desertfireballnetwork/observatories_technical_wiki/index.md

---
title: "Home"
nav_order: 1
---
Welcome to the [Desert Fireball
Network's](https://en.wikipedia.org/wiki/Desert_Fireball_Network) and Global
Fireball Observatory public wiki. This wiki contains documentation for
the the DFN's fireball observatories and data processing procedures for
collaborators and team members. The main GFO website is on
<https://gfo.rocks>, Australian DFN website can be found at
<https://dfn.gfo.rocks>.

**Please contribute where you can** by uploading information, designs
and files that will help others with installation, maintenance and
operation. By documenting your problems and solutions here, you can help
other collaborators get up and running faster. **We need your help to
get cameras off shelves and under the night sky looking for space
rocks!**

# Fireball Observatories

Documentation to help you get your observatory up and running

- [Re-configuring VPN in camera systems - 2023
  change]({% link network/Reconfigure_VPN.md %})
- [Contents of the box with DFNEXT system]({% link observatories/dfnext/Packing.md %})
- [Getting Started]({% link Getting_Started.md %})
- [Maintenance]({% link observatories/maintenance/index.md %})
- [Troubleshooting]({% link observatories/maintenance/Camera_Troubleshooting.md %})
- [Getting Help]({% link Getting_Help.md %})
- Frequently asked questions ([FAQ]({% link FAQ.md %}))

# Fireball Data

How to access your fireball images and information about how the DFN
processes fireball ev

- [Accessing data]({% link data-processing/Accessing_data.md %}) captured by Fireball
  Observatory (still images, videos, logs)
- [Finding Fireballs]({% link data-processing/Finding_Fireballs.md %}) in images
- Data Processing Pipeline

# Meteorite searching

- Foot searching:
  [Meteorite_searching_advice_handbook.pdf]({{ site.baseurl }}/images/Meteorite_searching_advice_handbook.pdf)
- Drone Meteorite Searching:
  <https://desertfireballnetwork.github.io/drone_meteorite_doc/>

# Resources

Collections of things you might find useful. **Contributions to this
section are especially appreciated**

Todo: find a better name for this section

- [Mechanical Designs]({% link installations/Mechanical_Designs.md %}) for deploying your
  fireball observatory (add your stand and roof mount designs here)
- [Cables]({% link observatories/maintenance/Cables.md %}) used in fireball observatories and for
  deployment
- [Photos of Fireballs]({% link data-processing/Fireball_Photos.md %}) (add your pretty
  fireball to the galleries here at reduced resolutions for everyone to
  see; remember this wiki is open to the public)
- [Photos of Fireball Camera
  Installations]({% link installations/Photos_of_Fireball_Camera_Installations.md %})
  (upload photos of your finished and in-progress installations here)

# [Hayabusa]({% link campaigns/hayabusa/index.md %})

# Wiki Info

Users with accounts may edit the wiki, and anyone may view the wiki
(even without logging in).

Internal links do not work in edit mode (it's a bug), but work as
expected in read mode.

File uploads are restricted to certain types of files. If you require a
new filetype to be added, please email DFN camera help.

Click the DFN fireball in the upper left at any time to get back to this
main page.

[Help Editing Wiki Pages](https://www.mediawiki.org/wiki/Help:Editing_pages),
[Formatting Help](https://www.mediawiki.org/wiki/Help:Formatting), [The
MediaWiki
VisualEditor](https://www.mediawiki.org/wiki/Help:VisualEditor/User_guide),
Orphaned Pages, [DFN Wiki To-do
List]({% link Wiki_To-do_List.md %})
