desertfireballnetwork/observatories_technical_wiki/Mechanical_Designs.md

upload you design files here for stands, roofmounts, railing mounts,
sunshields and things like that

# Gallery of installations

- [Various photos of Fireball Camera Systems
  Installations](Photos_of_Fireball_Camera_Installations.html)
- [Rooftop installations of DFNEXT/DFNSMALL camera
  systems](Rooftop_Fireball_Camera_Installation.html)
- [Standalone Fireball Camera
  Installation](Standalone_Fireball_Camera_Installation.html)
  (DFNEXT/DFNSMALL)

# DFNEXT and DFNSMALL camera systems

- [DFNEXT/DFNSMALL camera mounting
  pattern](Rooftop_Fireball_Camera_Installation#Mounting_Pattern.html),
  eg for roof top deployment
- [Drawings and instructions for standalone
  installation](Standalone_Fireball_Camera_Installation#Parts.html)
- [DFNEXT stand design by the UK Fireball
  Network](DFNEXT_stand_design_by_the_UK_Fireball_Network.html),
  off-the-shelf installation guide for standalone or rooftop deployment.

# DFNKIT camera systems

##  Rooftop Mounts

- [Rooftop Kit Camera
  Installation](Rooftop_Kit_Camera_Installation.html) details -
  DFNKIT deployment

(For [DFNKIT](:File:Kit_camera_with_GPS_antenna_1000.jpg.html)
cameras only at the moment. These have plastic enclosures with
transparent tops.)

Editable Autodesk Inventor ([free for use by "Qualified Educational
Institutions"](https://www.autodesk.com/education/free-software/inventor-professional))
part files:

roof_mount.ipt roof angle parameter can be modified before DXF export
for laser cutting

roof_mount_rib_and_pan.ipt

flat_roof_mount.ipt

### DXF files (send to your nearest lasercutter and then bend with a panbrake):

#### For smooth corrugated tin roofs

[Media:PART 10 degree roof mount MAT 3mm
aluminium.dxf](Media:PART_10_degree_roof_mount_MAT_3mm_aluminium.dxf.html)

[Media:PART 15 degree roof mount MAT 3mm
aluminium.dxf](Media:PART_15_degree_roof_mount_MAT_3mm_aluminium.dxf.html)

[Media:PART 20 degree roof mount MAT 3mm
aluminium.dxf](Media:PART_20_degree_roof_mount_MAT_3mm_aluminium.dxf.html)

[Media:PART 25 degree roof mount MAT 3mm
aluminium.dxf](Media:PART_25_degree_roof_mount_MAT_3mm_aluminium.dxf.html)

[Media:PART 30 degree roof mount MAT 3mm
aluminium.dxf](Media:PART_30_degree_roof_mount_MAT_3mm_aluminium.dxf.html)

[Media:PART 35 degree roof mount MAT 3mm
aluminium.dxf](Media:PART_35_degree_roof_mount_MAT_3mm_aluminium.dxf.html)

#### For rib and pan tin roofs

[Media:PART 20 degree rib and pan roof mount MAT 3mm
aluminium.dxf](Media:PART_20_degree_rib_and_pan_roof_mount_MAT_3mm_aluminium.dxf.html)

For flat roofs and other structures:

[Media:PART flat mount MAT 3mm
aluminium.dxf](Media:PART_flat_mount_MAT_3mm_aluminium.dxf.html)

### IPT files (editable for different roof angles and constructions)

[Media:Roof mount.ipt](Media:Roof_mount.ipt.html) (main roof mount
used by kit cameras, roof angle is an editable parameter)

[Media:Flat roof mount.ipt](Media:Flat_roof_mount.ipt.html)

[Media:Roof mount rib and
pan.ipt](Media:Roof_mount_rib_and_pan.ipt.html)
