desertfireballnetwork/observatories_technical_wiki/AMOS-Spec_fireball_BIOS_configuration.md

**Motherboard type: Asus ROG Strix Z370-I gaming**

Advanced - APM configuration - Restore AC power loss - Power ON.
