desertfireballnetwork/observatories_technical_wiki/observatories/dfnext/DFNEXT_stand_design_by_the_UK_Fireball_Network.md

---
title: "DFNEXT UK Stand Design"
parent: "DFNEXT"
grand_parent: "Observatories"
---
The UK Fireball Network has designed a stand for mounting DFNEXT cameras
using off the shelf building/electrical equipment. The stands have been
designed to be mounted on the floor, however, the design is easily
adaptable for installations on the side of buildings or on a flat roof.

The stand design in the UK uses the Unistrut system---a metal framing
system widely used in electrical and mechanical projects---however, an
alternative brand can be used if this system is not available. The
stands are designed to be weather resistant; all cut metal edges should
be galvanised to prevent rust, terrace pads should be used to elevate
the wooden base and minimise water damage, and the prevailing wind
direction and strength in the installation location should be considered
when positioning concrete blocks and deciding the size of the base.

### Build Manual and Cutting Instructions

![File:DFNEXT Camera Stand Design by UKFN.pdf]()
*<a href="File:DFNEXT">File:DFNEXT</a> Camera Stand Design by
UKFN.pdf*

# Gallery of installations

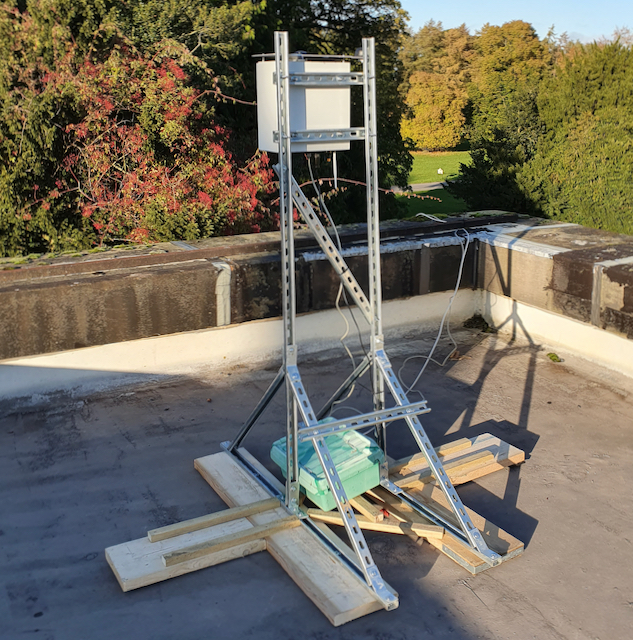
[picture p1: images/Roof_tall_install.jpeg]
\| Floor mounted camera back.jpeg\|
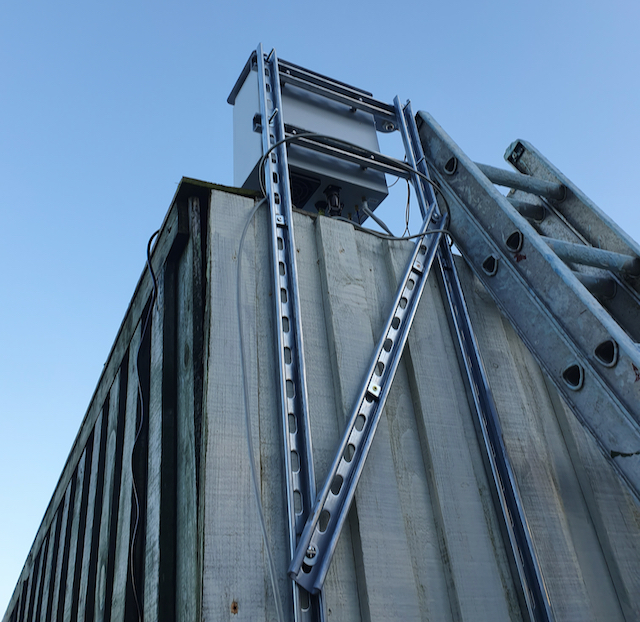
[picture p2: images/Shed_side_install.jpeg]
Floor mounted camera front.jpeg\| \|
Lincoln camera stand.jpeg\| Example roof stand.jpeg\|
