desertfireballnetwork/observatories_technical_wiki/AC_Power_Supply.md

The power supply recommended for AC powered installations where the
observatory is located close to the AC power supply is the [Meanwell
GST120A12](https://www.meanwellaustralia.com.au/products/gst120a).

For observatories with heaters and long DC power cable runs the
[Meanwell
HRP-300-12](https://www.meanwellaustralia.com.au/products/hrp-300) is
recommended as it's remote sense functionality allows it to compensate
for any voltage drop in the long cable runs. (If no heaters are present,
the [Meanwell
HRP-150-12](https://www.meanwellaustralia.com.au/products/hrp-150) is
the preferred option.)

Direct links to order Meanwell HRP-300-12 from USA:

[HRP-300-12, Mouser
Electronics](https://www.mouser.com/ProductDetail/MEAN-WELL/HRP-300-12?qs=sGAEpiMZZMvdqMP%2FaZ%252BGCqLV2Ez6D3hU)

[HRP-300-12, TRC
Electronics](https://www.trcelectronics.com/View/Mean-Well/HRP-300-12.shtml)

Accessories for Meanwell HRP-300-12:

[TRC-E-HRP300450600 enclosure for
HRP-300-12](https://www.trcelectronics.com/View/TRC/TRC-E-HRP300450600.shtml)

[US/Canada power cord for
HRP-300-12](https://www.trcelectronics.com/View/Tumbler/32V86S.shtml)

<figure>

<figcaption>Power_supply_wiring_with_remote_voltage_sense.svg</figcaption>
</figure>

### Outdoor Cable

The recommended off the shelf for use on roofs or outdoor structures is
the sunlight and abrasion resistant AlphaWire EcoFlex PUR 80045 SL005
(unshielded) or 80145 SL005 (braid shield). Digi-Key usually has one or
the other in stock: [80045
SL005](https://www.digikey.com/product-detail/en/alpha-wire/80045-SL005/80045SL005-ND/5271247),
[80145
SL005](https://www.digikey.com/product-detail/en/alpha-wire/80145-SL005/80145SL005-ND/5271269).

That cabling doesn't have a twisted pair, so we recommend wiring up the
conductors to the green numbering in the two images below.

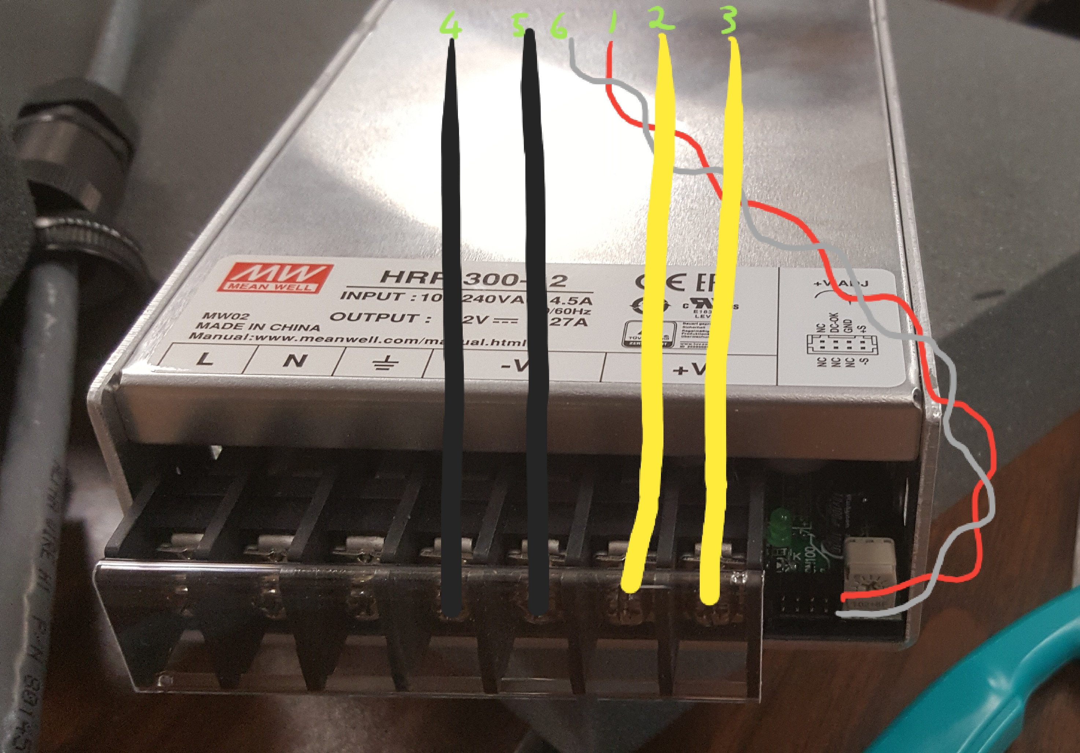
[picture p7: wiki/images/Remote_sense_cable_wiring_power_supply_side.jpg]
Recommended wiring on the power supply side for a 6 or 7 conductor cable (twisted pair will most likely not be present in off-the-shelf cables) You should use Blue 3mm Fork Crimps to terminate the conductors for L,N,E,-V and +V. This power supply should be installed in a metal enclosure which shoul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

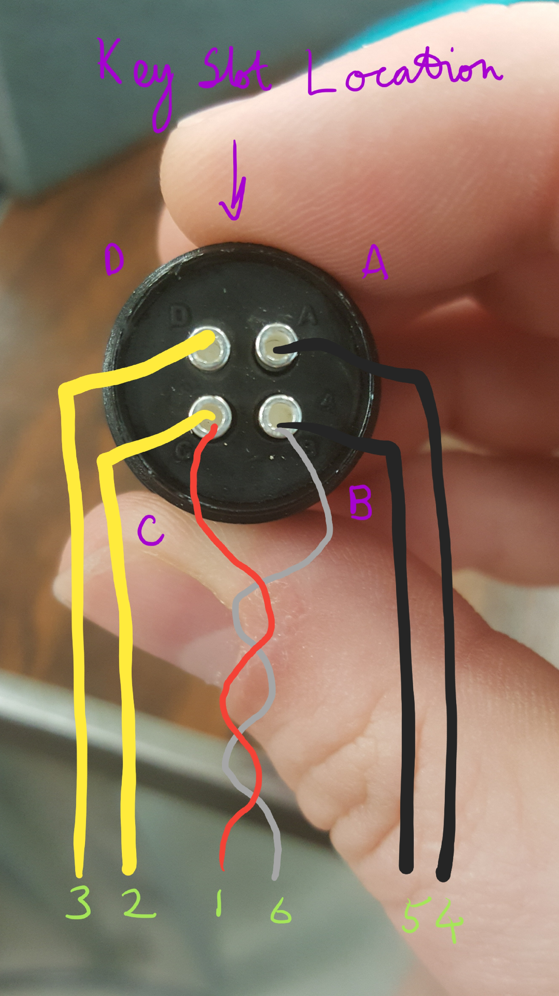
[picture p8: wiki/images/Remote_sense_cable_wiring_observatory_side.jpg]
Recommended wiring on the observatory power plug side for a 6 or 7 conductor cable (twisted pair will most likely not be present in off-the-shelf cables) Conductors 1 and 6 will need to be soldered to the side of C and B if thick conductors are used. The transition from insulated wire to contact ne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


### Mathias Research Ranch Installation in Alberta, Canada

<File:20190724_212110.jpg>\| <File:20190724_212620.jpg>\|
<File:20190724_212709.jpg>\|

### Long DC Cable Run Connector Care Package

If you need to build your own long cable with (using the cable listed
above) you can request a *Long DC Cable Run Connector Care Package* from
[us](Getting_Help.html). It should contain:
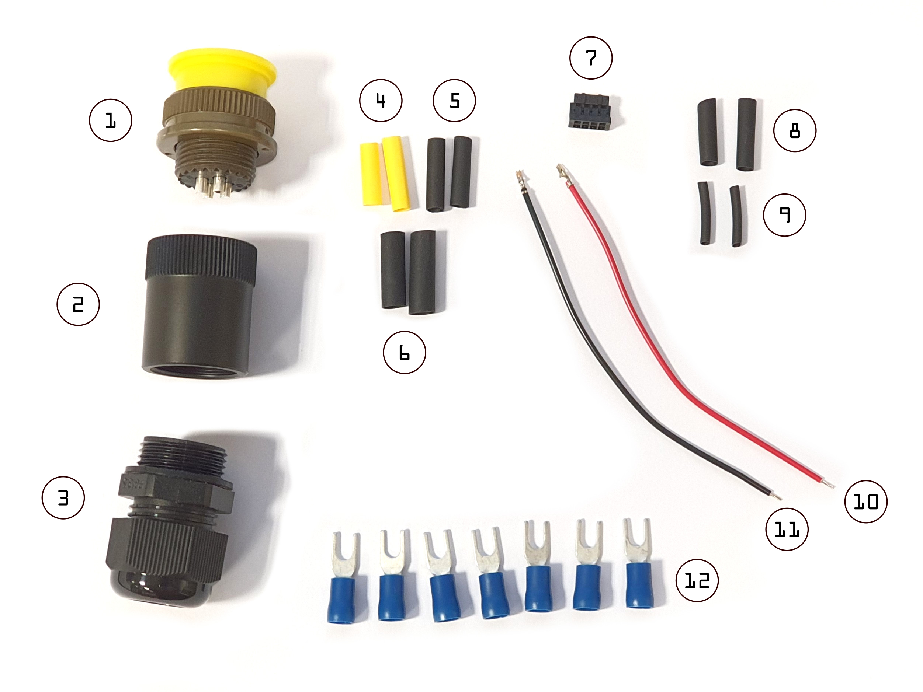
[picture p9: images/Long_DC_cable_connector_care_package.png]


<table>
<thead>
<tr class="header">
<th><p>Item #</p></th>
<th><p>Part</p></th>
<th><p>Quantity</p></th>
<th><p>Manufacturer</p></th>
<th><p>Manufacturer Part Number</p></th>
<th><p>Example Supplier Link 1</p></th>
<th><p>Example Supplier Link 2</p></th>
</tr>
</thead>
<tbody>
<tr class="odd">
<td><p>1</p></td>
<td><p>MIL-DTL-5015 compatible plug, 14S-2S insert</p></td>
<td><p>1</p></td>
<td><p>various</p>
<p>(Amphenol Industrial)</p></td>
<td><p>various</p>
<p>(MS4106F-14S-2S-624)</p></td>
<td><p><a
href="https://www.digikey.com/product-detail/en/amphenol-industrial-operations/MS3106F-14S-2S/MS3106F14S-2S-ND/378649">https://www.digikey.com/product-detail/en/amphenol-industrial-operations/MS3106F-14S-2S/MS3106F14S-2S-ND/378649</a></p></td>
<td><p><a
href="https://au.rs-online.com/web/p/mil-spec-circular-connectors/2982465/">https://au.rs-online.com/web/p/mil-spec-circular-connectors/2982465/</a></p></td>
</tr>
<tr class="even">
<td><p>2</p></td>
<td><p>PG13.5 cable gland adaptor for size 14 MIL-DTL-5015 compatible
plug</p></td>
<td><p>1</p></td>
<td><p>Amphenol Industrial</p></td>
<td><p>97B-14S-PG13.5-624</p></td>
<td><p>DFN Camera Help</p></td>
<td><p>Amphenol Industrial (minimum order quantity will apply)</p></td>
</tr>
<tr class="odd">
<td><p>3</p></td>
<td><p>PG13.5 cable gland</p></td>
<td><p>1</p></td>
<td><p>various</p></td>
<td><p>various</p></td>
<td><p><a
href="https://www.digikey.com/products/en/cables-wires-management/cable-and-cord-grips/492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">https://www.digikey.com/products/en/cables-wires-management/cable-and-cord-grips/492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</a></p></td>
<td><p><a
href="https://www.altronics.com.au/p/h4318A-6-12mm-eg13.5-pg13.5-black-ip68-cable-gland/">https://www.altronics.com.au/p/h4318A-6-12mm-eg13.5-pg13.5-black-ip68-cable-gland/</a></p></td>
</tr>
<tr class="even">
<td><p>4</p></td>
<td><p>≈10mm length of 3 mm yellow heatshrink tubing</p></td>
<td><p>2</p></td>
<td><p>various</p></td>
<td><p>various</p></td>
<td><p><a
href="https://www.altronics.com.au/p/w0912a-black-3mm-heatshrink-1.2m-length/">https://www.altronics.com.au/p/w0912a-black-3mm-heatshrink-1.2m-length/</a></p></td>
<td></td>
</tr>
<tr class="odd">
<td><p>5</p></td>
<td><p>≈10mm length of 3 mm black heatshrink tubing</p></td>
<td><p>2</p></td>
<td><p>various</p></td>
<td><p>various</p></td>
<td><p><a
href="https://www.altronics.com.au/p/w0912a-black-3mm-heatshrink-1.2m-length/">https://www.altronics.com.au/p/w0912a-black-3mm-heatshrink-1.2m-length/</a></p></td>
<td></td>
</tr>
<tr class="even">
<td><p>6</p></td>
<td><p>≈10mm length of 5 mm heatshrink tubing (may be required if 3 mm
tubing doesn't fit over contacts "C" and "B")</p></td>
<td><p>0-2</p></td>
<td><p>various</p></td>
<td><p>various</p></td>
<td><p><a
href="https://www.altronics.com.au/p/w0913a-black-5mm-heatshrink-1.2m-length/">https://www.altronics.com.au/p/w0913a-black-5mm-heatshrink-1.2m-length/</a></p></td>
<td></td>
</tr>
<tr class="odd">
<td><p>7</p></td>
<td><p>Power supply connector</p></td>
<td><p>1</p></td>
<td><p>Hirose</p></td>
<td><p>DF11-2DS-2C</p></td>
<td><p><a
href="https://www.digikey.com.au/product-detail/en/hirose-electric-co-ltd/DF11-8DS-2C/H2022-ND/141255">https://www.digikey.com.au/product-detail/en/hirose-electric-co-ltd/DF11-8DS-2C/H2022-ND/141255</a></p></td>
<td></td>
</tr>
<tr class="even">
<td><p>8</p></td>
<td><p>≈10mm length of 3 mm heatshrink tubing</p></td>
<td><p>2</p></td>
<td><p>various</p></td>
<td><p>various</p></td>
<td><p><a
href="https://www.altronics.com.au/p/w0912a-black-3mm-heatshrink-1.2m-length/">https://www.altronics.com.au/p/w0912a-black-3mm-heatshrink-1.2m-length/</a></p></td>
<td></td>
</tr>
<tr class="odd">
<td><p>9</p></td>
<td><p>≈10mm length of 1.5 mm heatshrink tubing</p></td>
<td><p>2</p></td>
<td><p>various</p></td>
<td><p>various</p></td>
<td><p><a
href="https://www.altronics.com.au/p/w0910a-black-1.5mm-heatshrink-1.2m-length/">https://www.altronics.com.au/p/w0910a-black-1.5mm-heatshrink-1.2m-length/</a></p></td>
<td></td>
</tr>
<tr class="even">
<td><p>10</p></td>
<td><p>DF-11 pre crimped jumper cable, red, cut in half</p></td>
<td><p>1</p></td>
<td><p>Hirose</p></td>
<td><p>H3BBT-10106-R6</p></td>
<td><p><a
href="https://www.digikey.com.au/product-detail/en/hirose-electric-co-ltd/H3BBT-10106-R6/H3BBT-10106-R6-ND/310537">https://www.digikey.com.au/product-detail/en/hirose-electric-co-ltd/H3BBT-10106-R6/H3BBT-10106-R6-ND/310537</a></p></td>
<td></td>
</tr>
<tr class="odd">
<td><p>11</p></td>
<td><p>DF-11 pre crimped jumper cable, black, cut in half</p></td>
<td><p>1</p></td>
<td><p>Hirose</p></td>
<td><p>H3BBT-10106-B6</p></td>
<td><p><a
href="https://www.digikey.com.au/product-detail/en/hirose-electric-co-ltd/H3BBT-10106-B6/H3BBT-10106-B6-ND/310505">https://www.digikey.com.au/product-detail/en/hirose-electric-co-ltd/H3BBT-10106-B6/H3BBT-10106-B6-ND/310505</a></p></td>
<td></td>
</tr>
<tr class="even">
<td><p>12</p></td>
<td><p>Blue 4 mm fork crimp terminal</p></td>
<td><p>7</p></td>
<td><p>various</p></td>
<td><p>various</p></td>
<td><p><a
href="https://www.altronics.com.au/p/h2082a-blue-4mm-fork-crimp-pk-100/">https://www.altronics.com.au/p/h2082a-blue-4mm-fork-crimp-pk-100/</a></p></td>
<td></td>
</tr>
</tbody>
</table>

### Long DC Cable Assembly

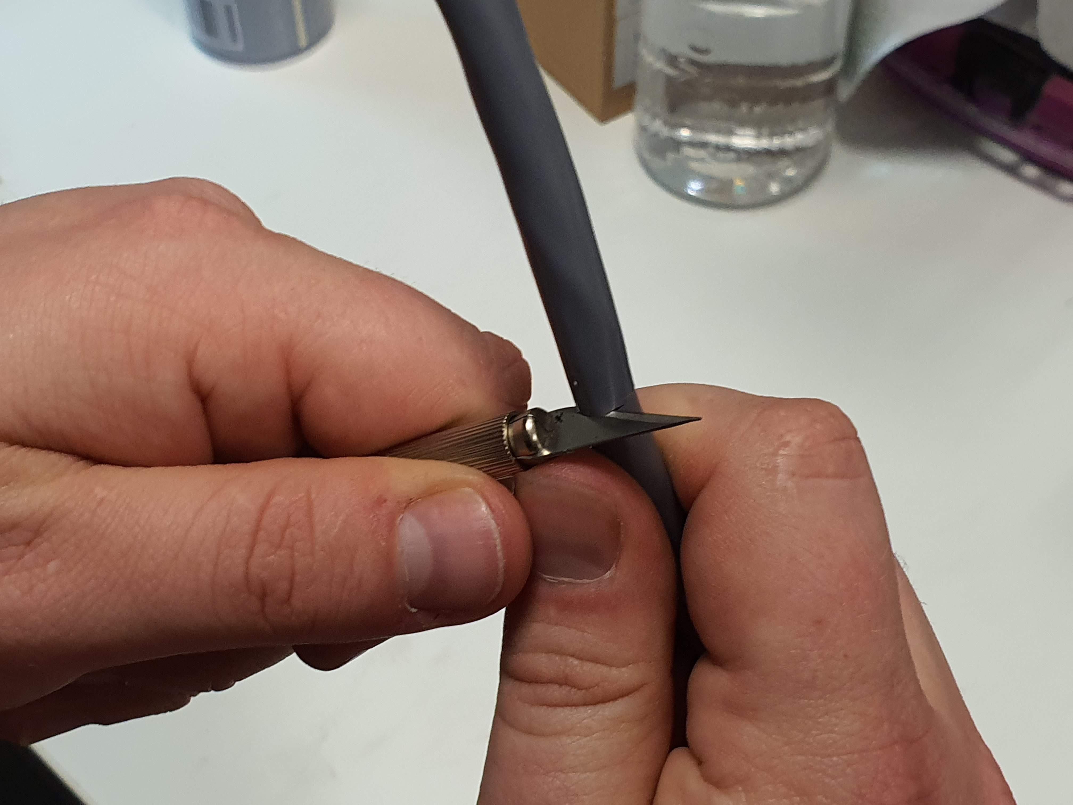
[picture p10: images/20190918_114454.jpg]

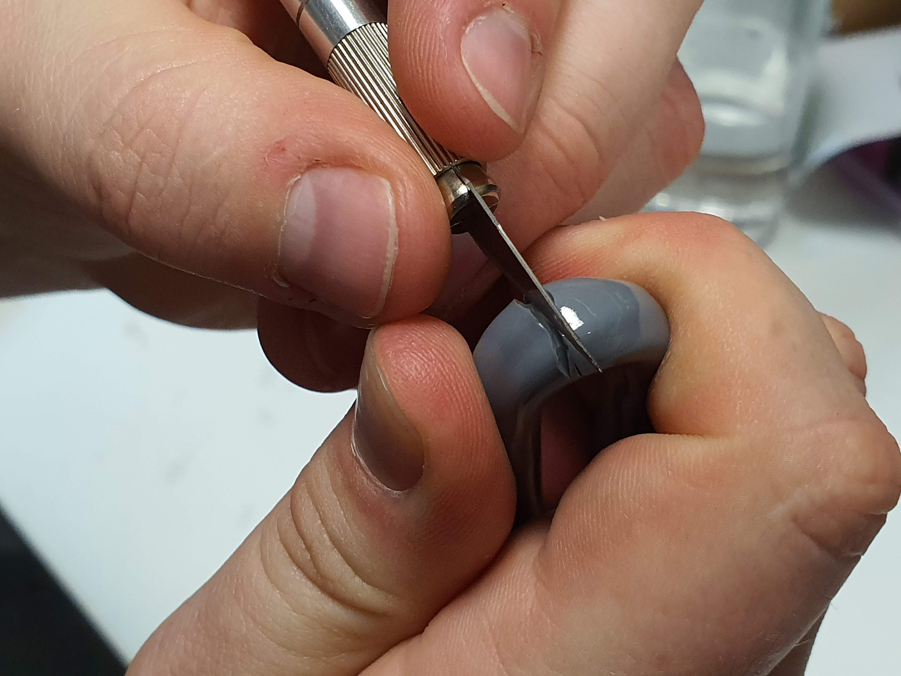
[picture p11: images/20190918_114512.jpg]

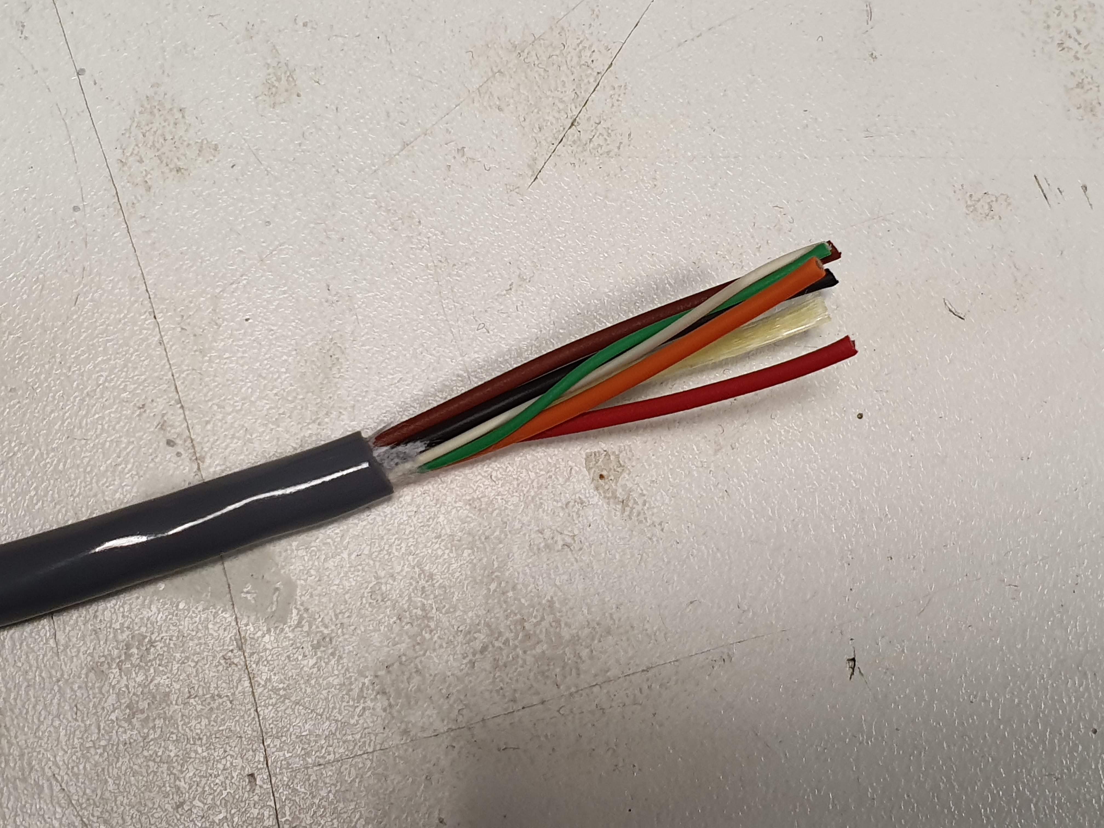
[picture p12: images/20190918_114635.jpg]

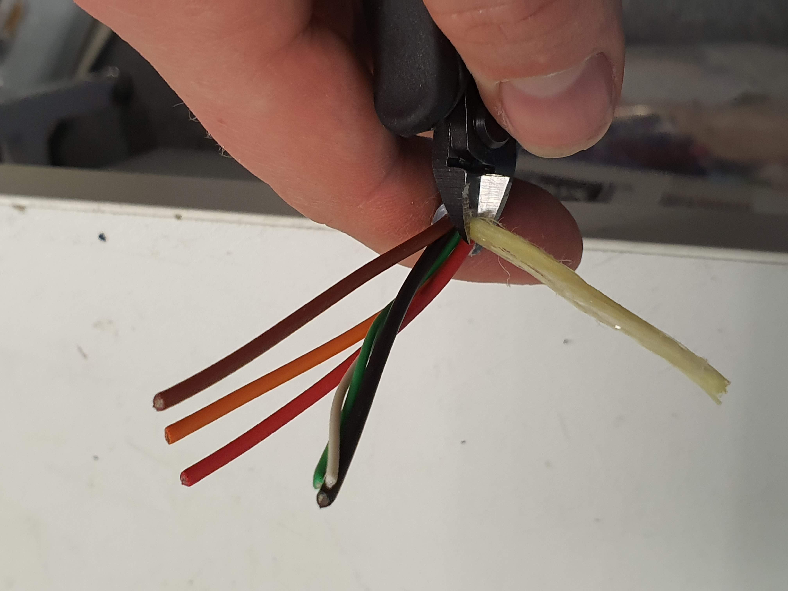
[picture p13: images/20190918_114658.jpg]

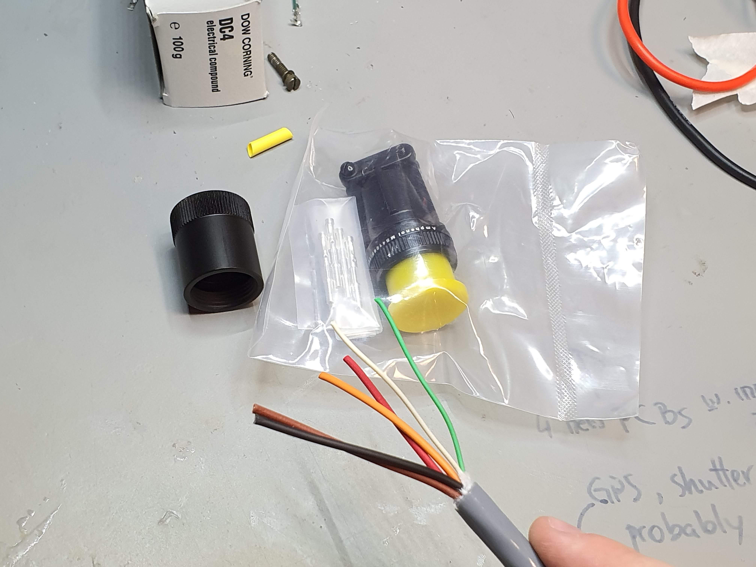
[picture p14: images/20190918_115321.jpg]

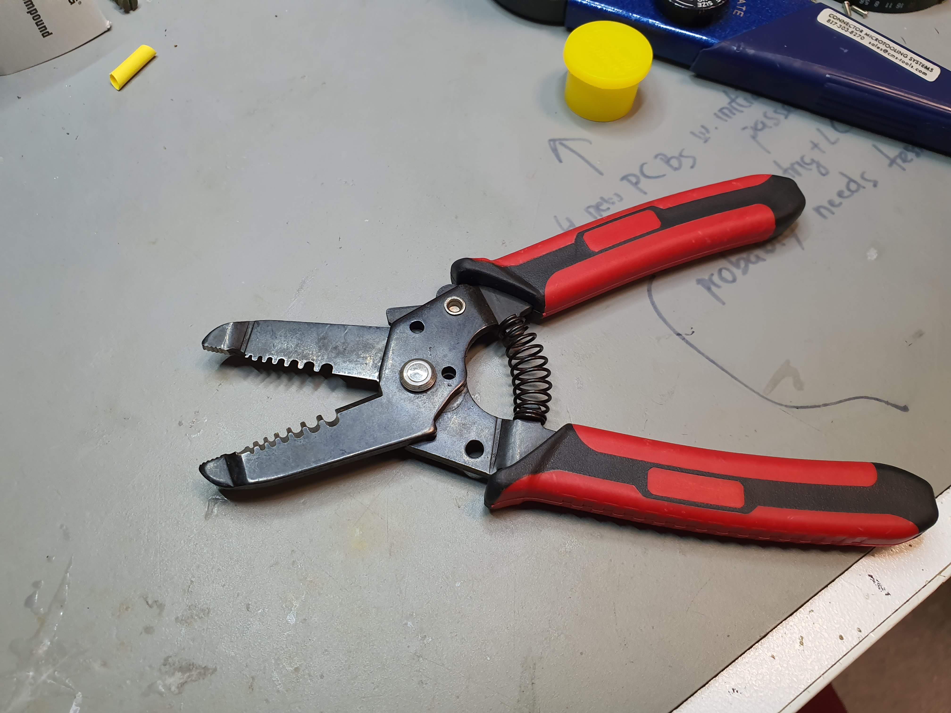
[picture p15: images/20190918_115757.jpg]

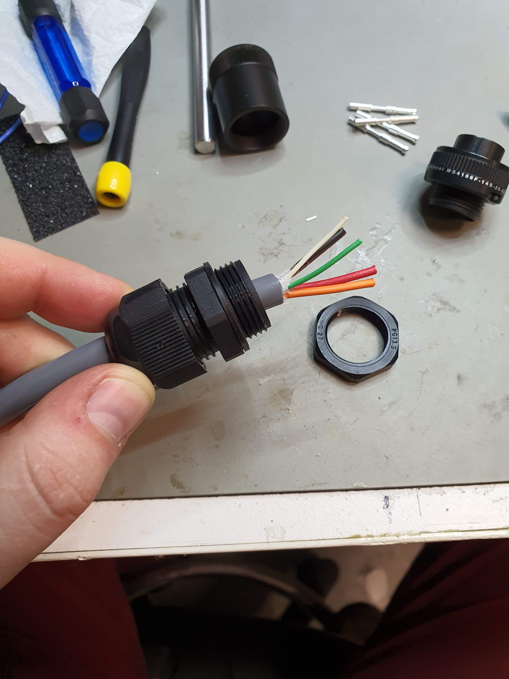
[picture p16: images/20190918_115538.jpg]

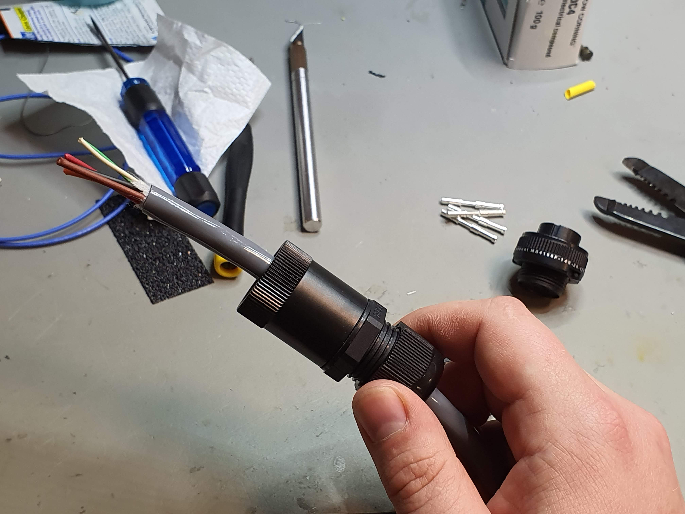
[picture p17: images/20190918_115612.jpg]

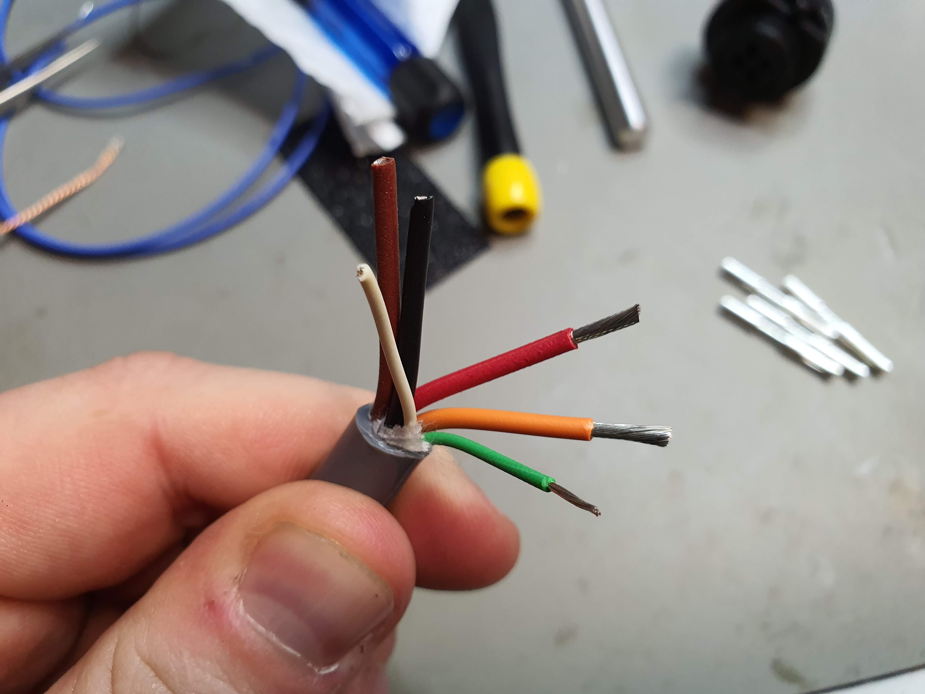
[picture p18: images/20190918_115724.jpg]

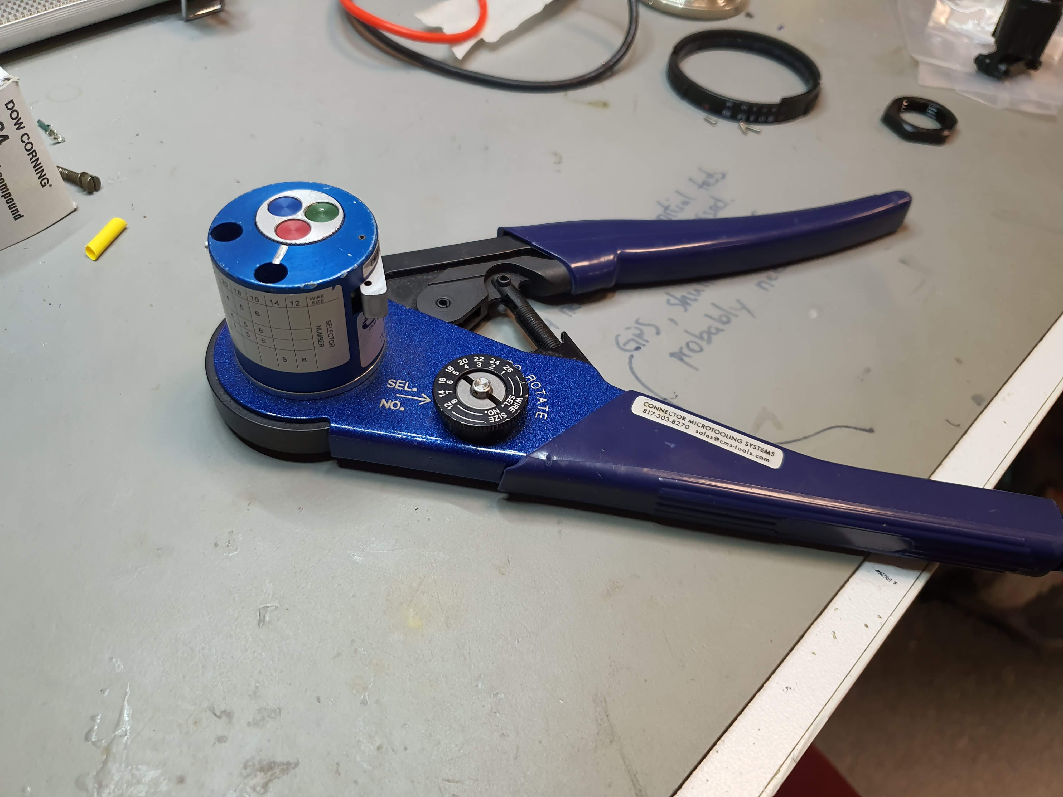
[picture p19: images/20190918_115806.jpg]

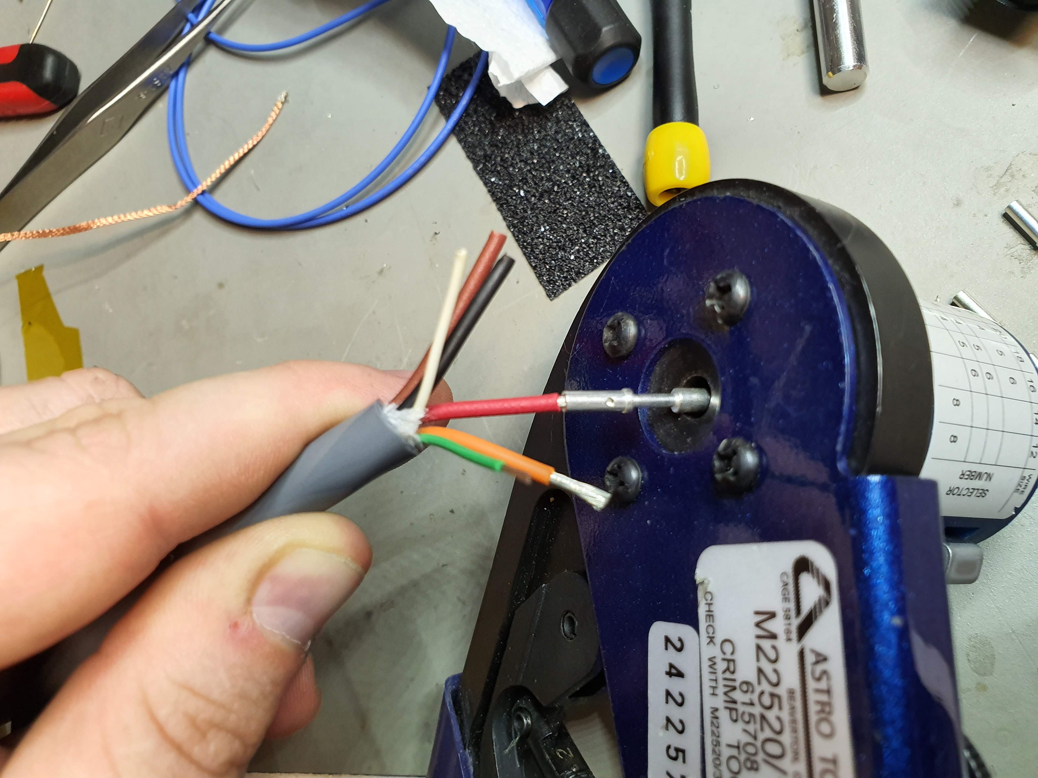
[picture p20: images/20190918_115819.jpg]

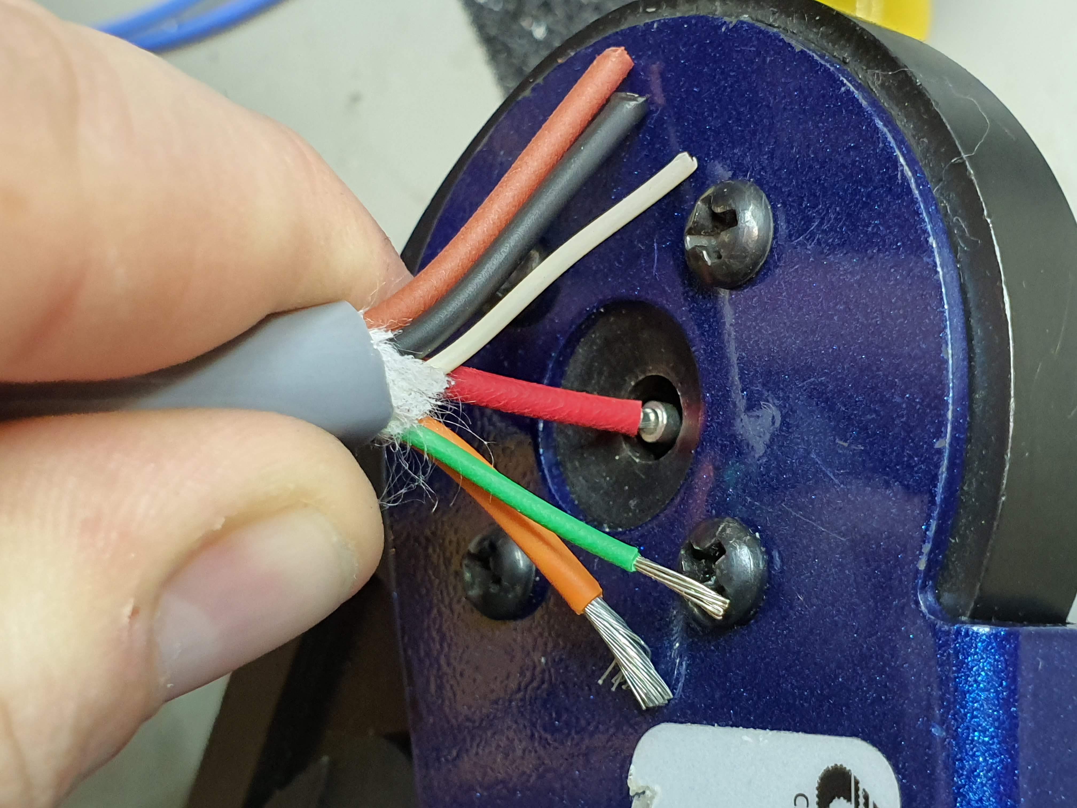
[picture p21: images/20190918_115836.jpg]

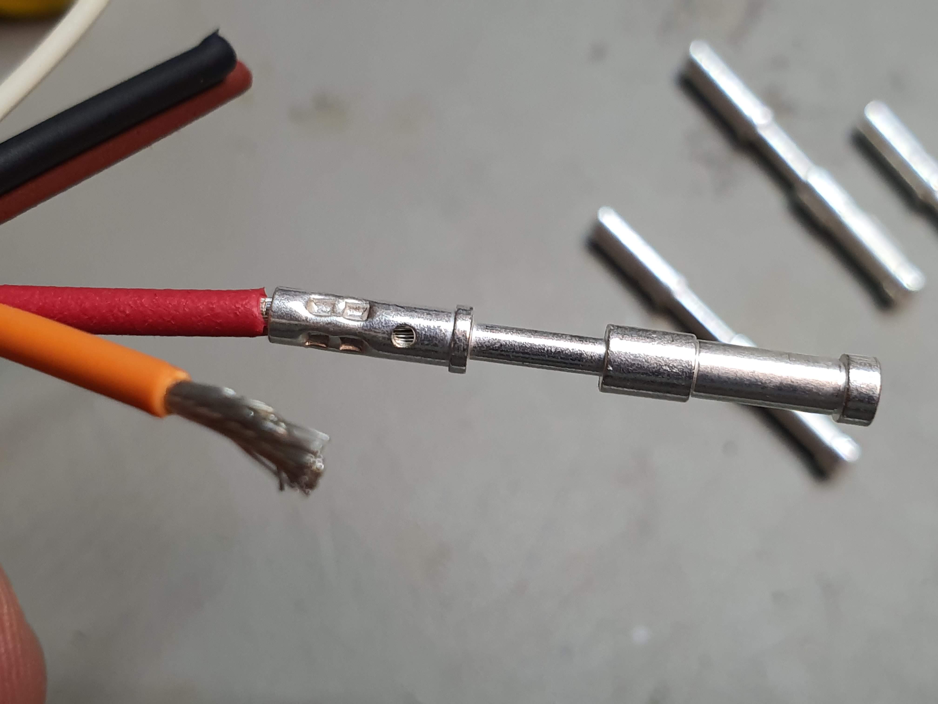
[picture p22: images/20190918_115848.jpg]

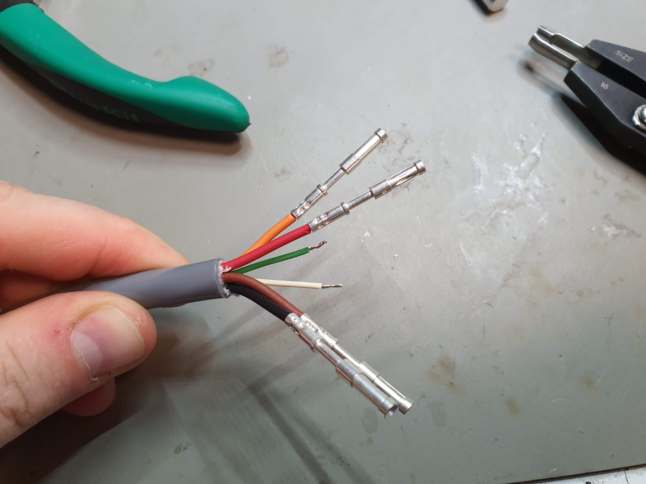
[picture p23: images/20190918_120819.jpg]

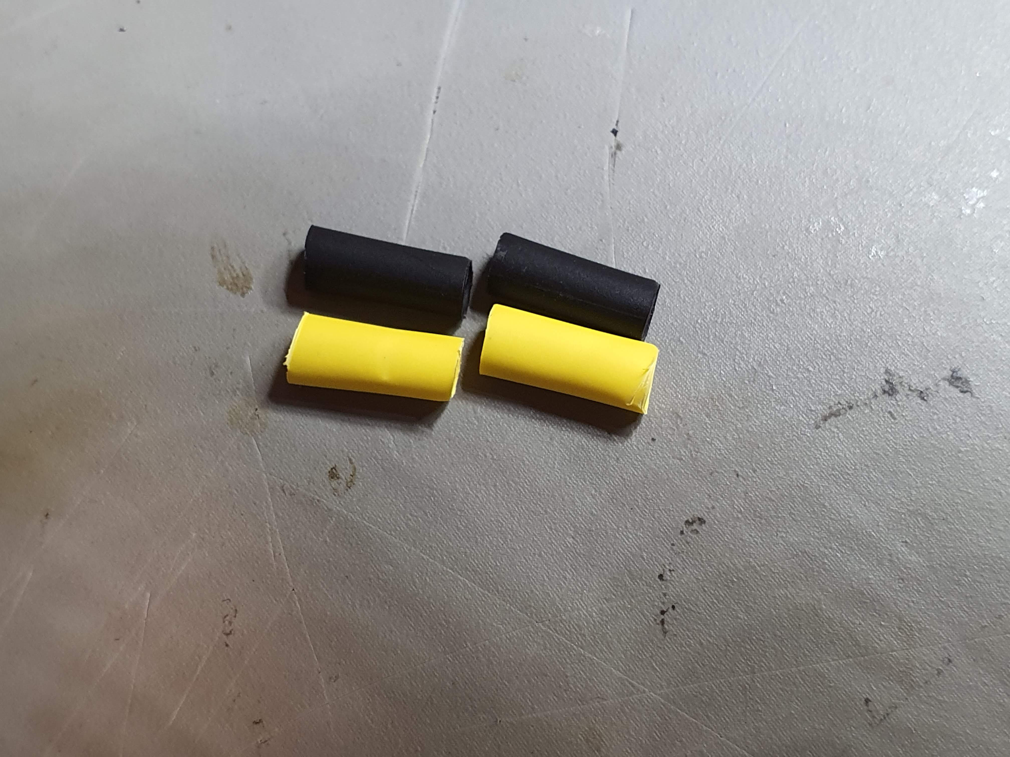
[picture p24: images/20190918_122415.jpg]

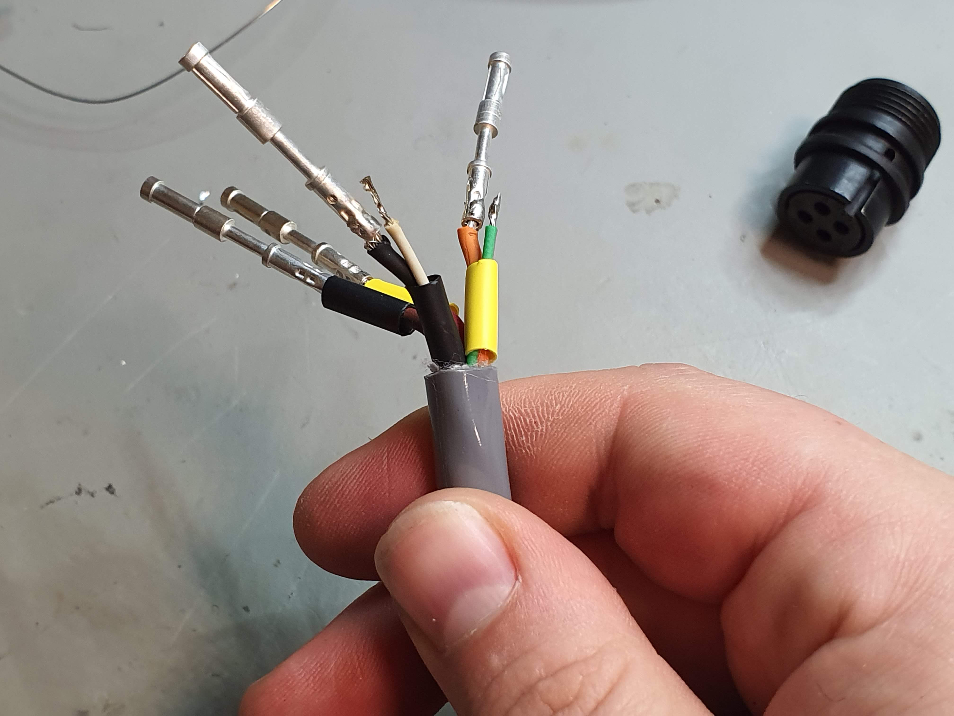
[picture p25: images/20190918_122350.jpg]

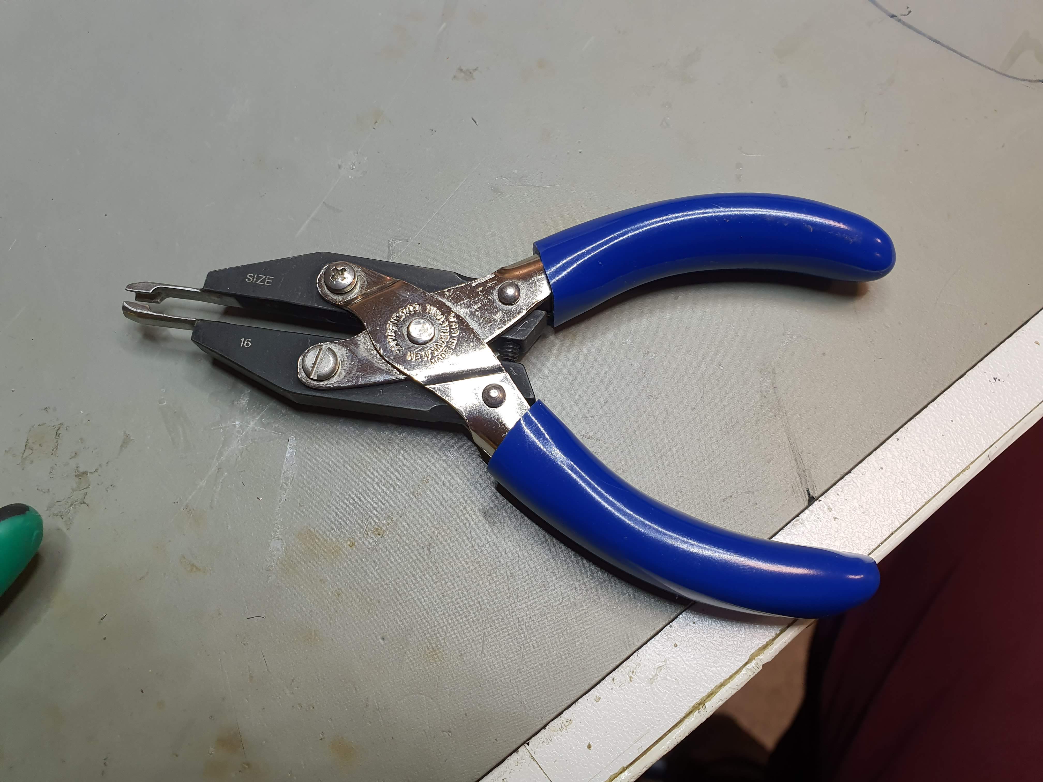
[picture p26: images/20190918_120735.jpg]

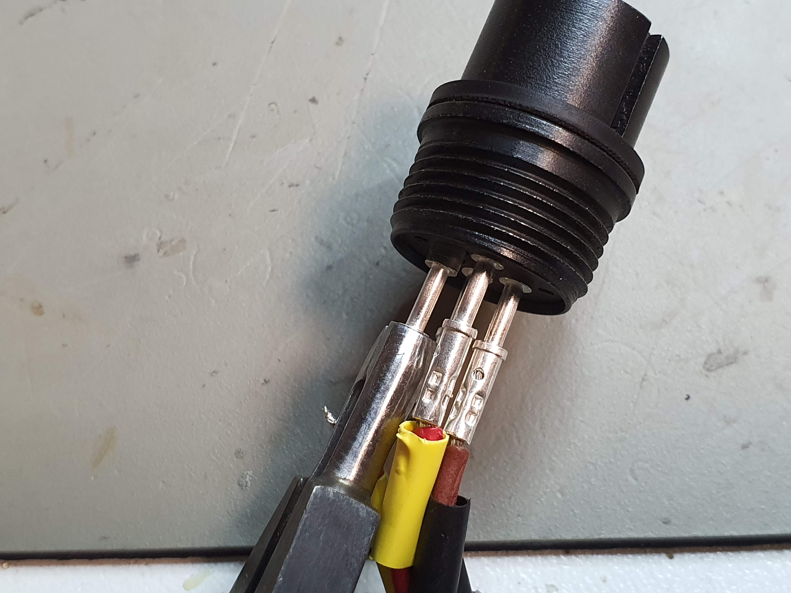
[picture p27: images/20190918_122718.jpg]

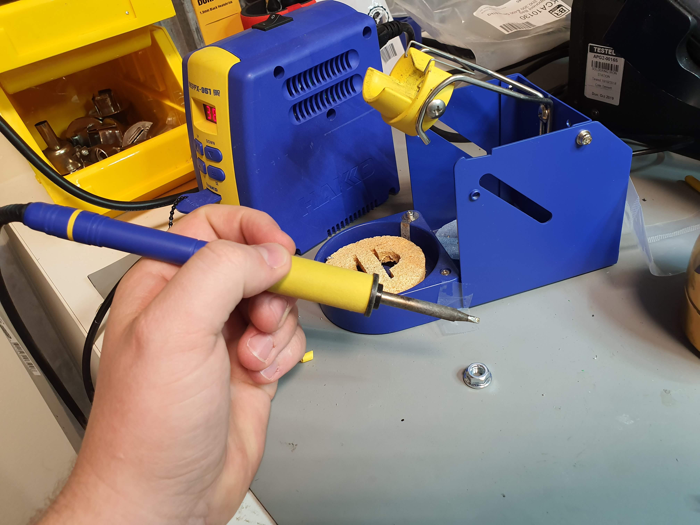
[picture p28: images/20190918_121758.jpg]

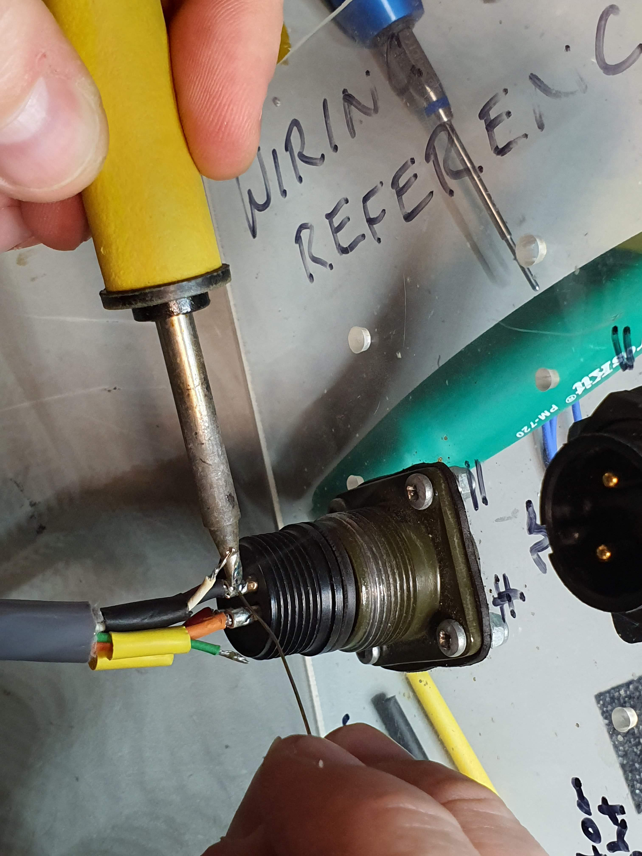
[picture p29: images/20190918_123025.jpg]

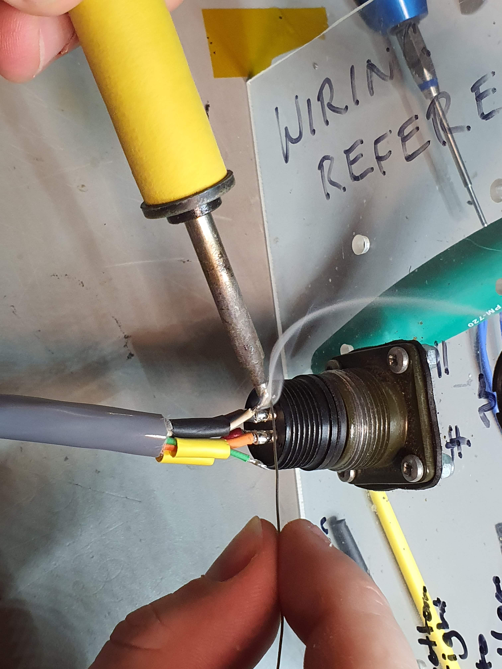
[picture p30: images/20190918_123050.jpg]

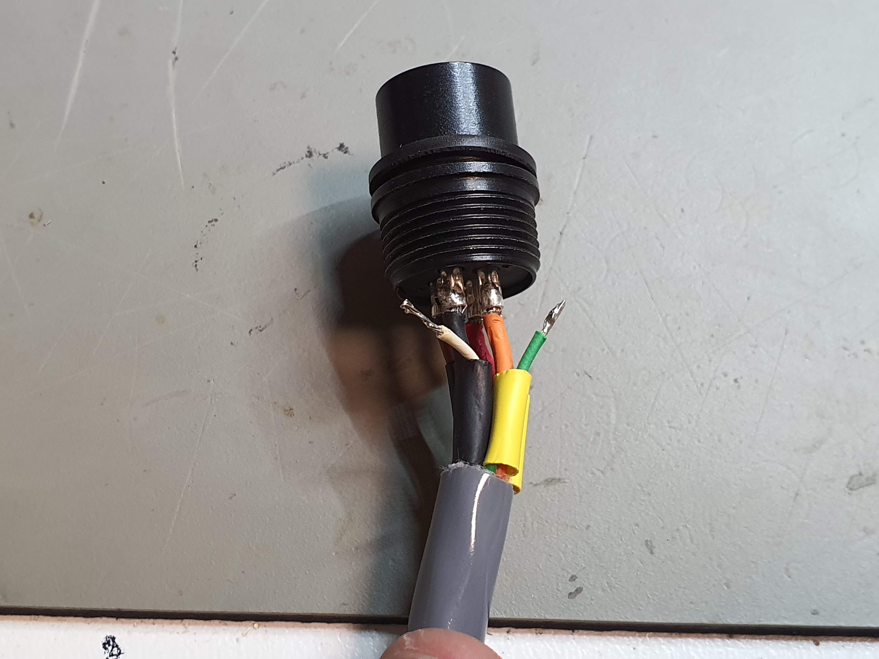
[picture p31: images/20190918_122938.jpg]

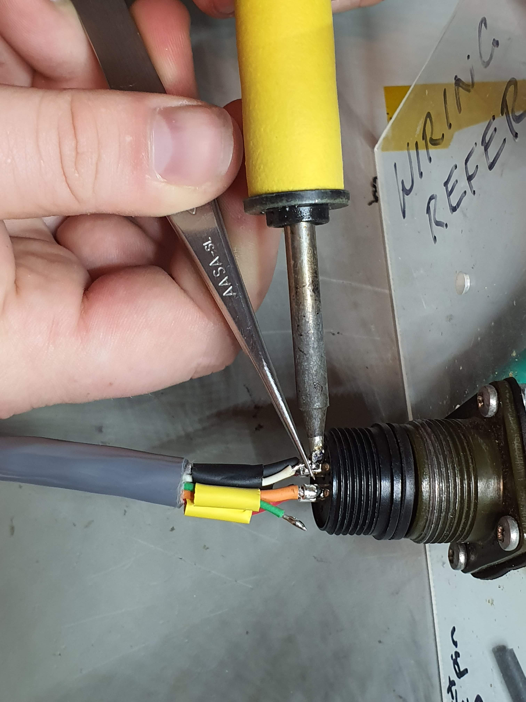
[picture p32: images/20190918_123119.jpg]

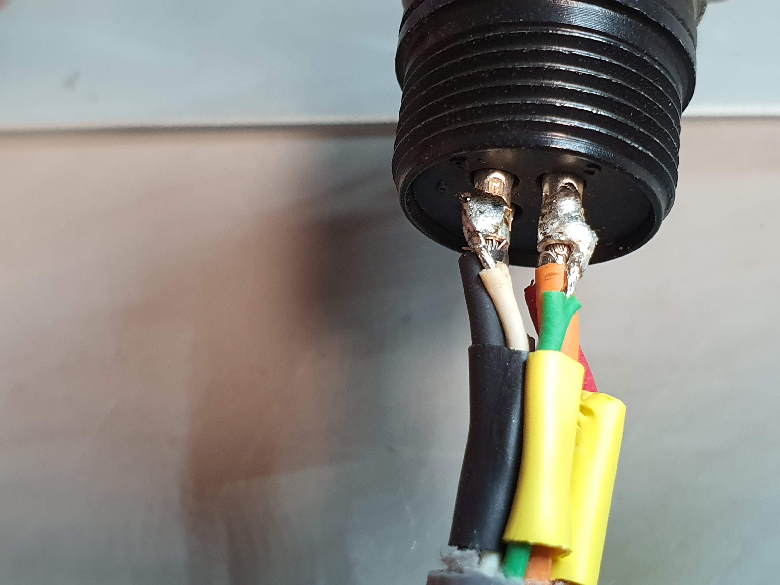
[picture p33: images/20190918_123215.jpg]

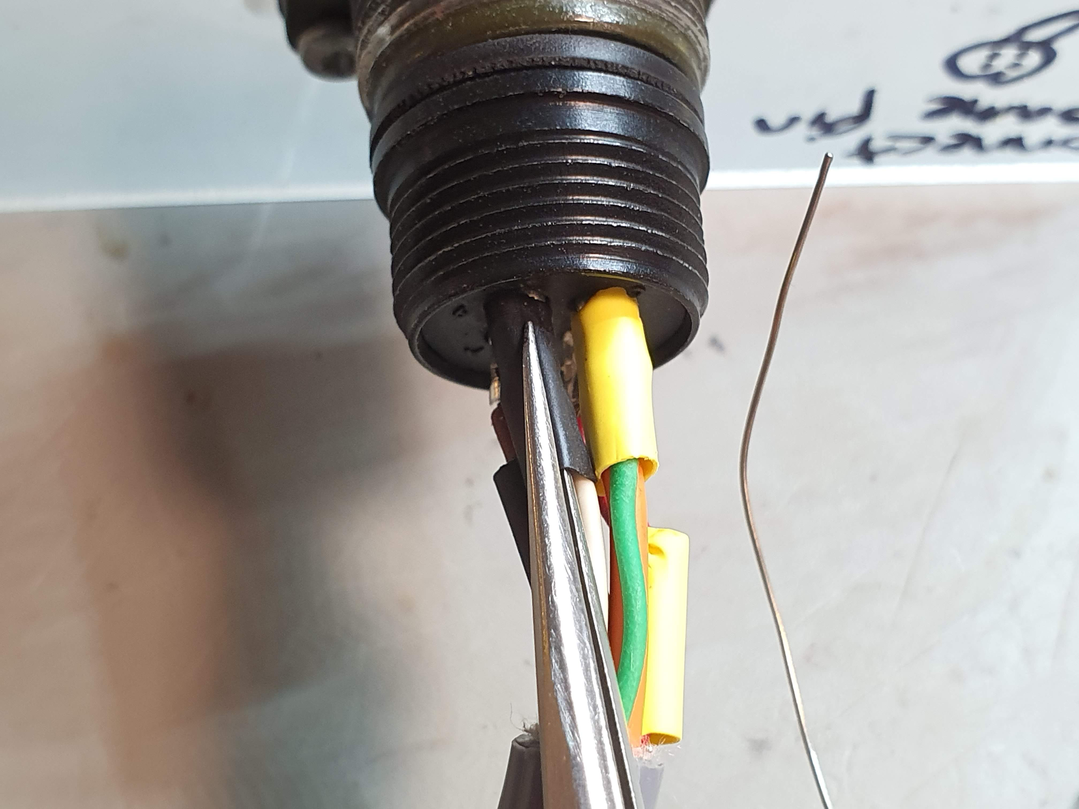
[picture p34: images/20190918_123318.jpg]

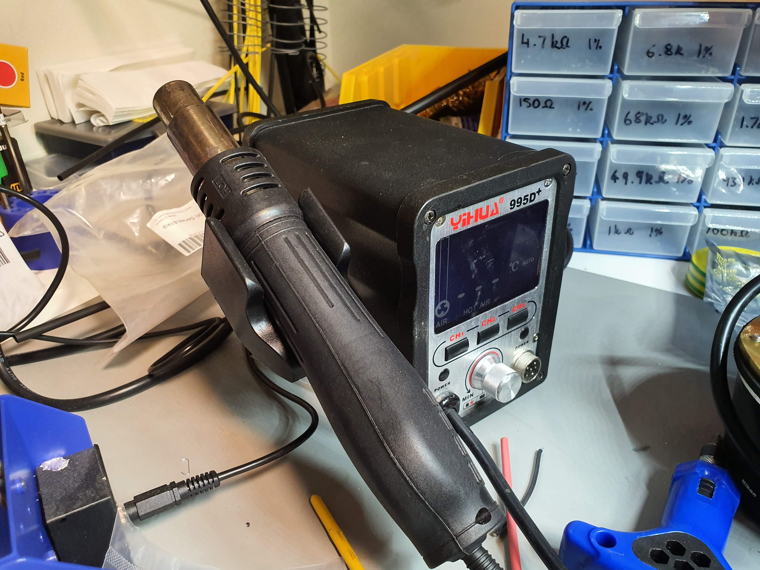
[picture p35: images/20190918_123427.jpg]

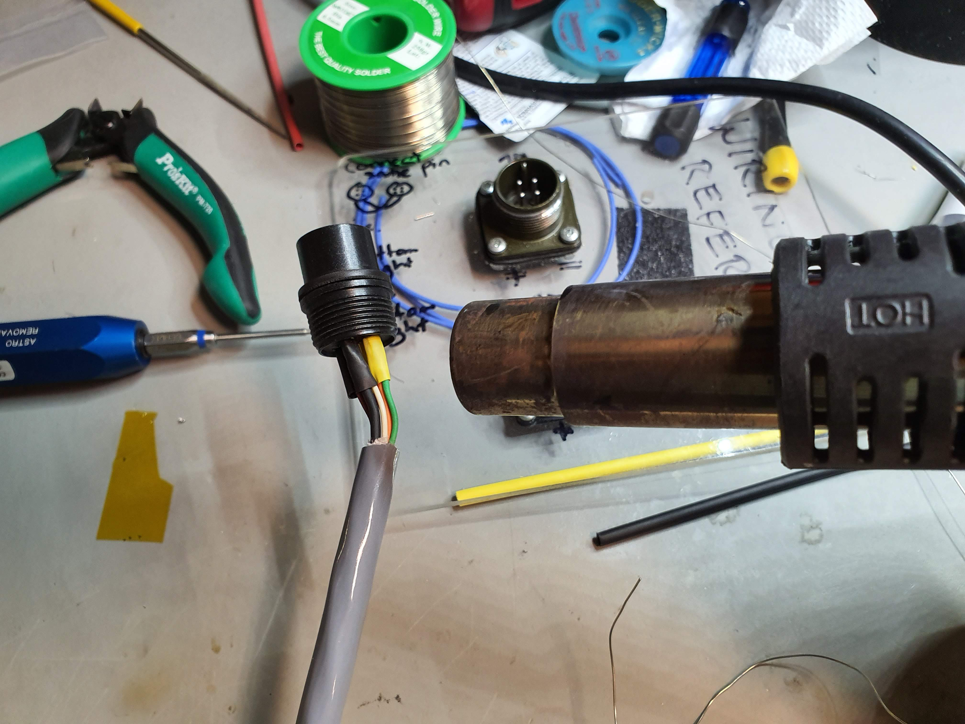
[picture p36: images/20190918_123442.jpg]


Your connector should now look like this:

<File:20190918_123513.jpg>\| <File:20190918_123550.jpg>\|
<File:20190918_123612.jpg>\|

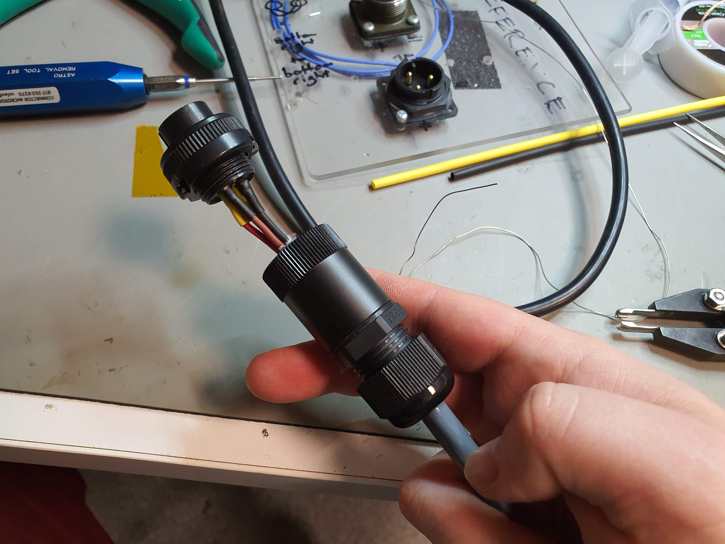
[picture p37: images/20190918_123625.jpg]

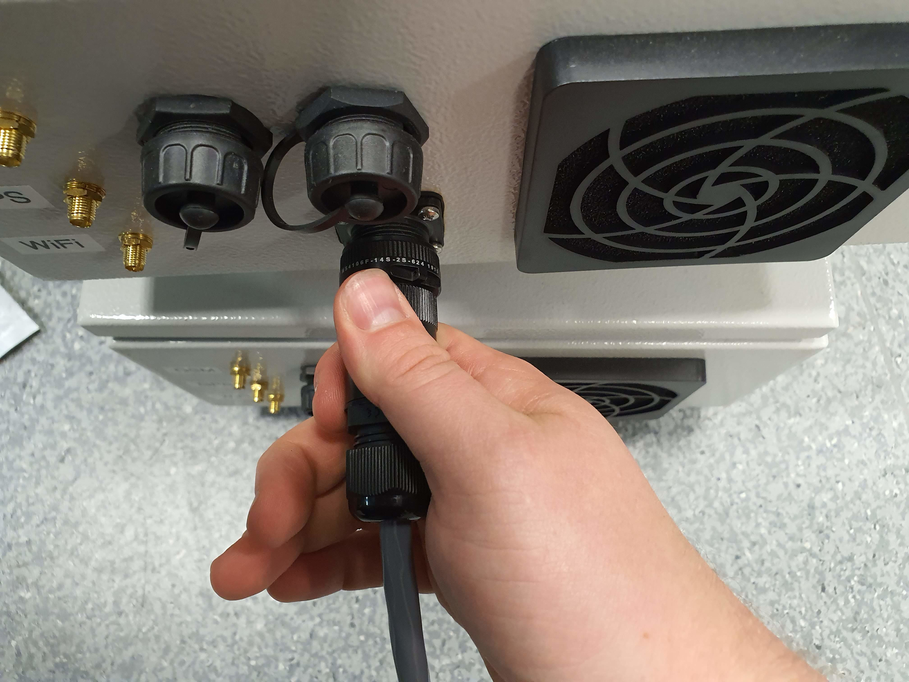
[picture p38: images/20190918_123725.jpg]

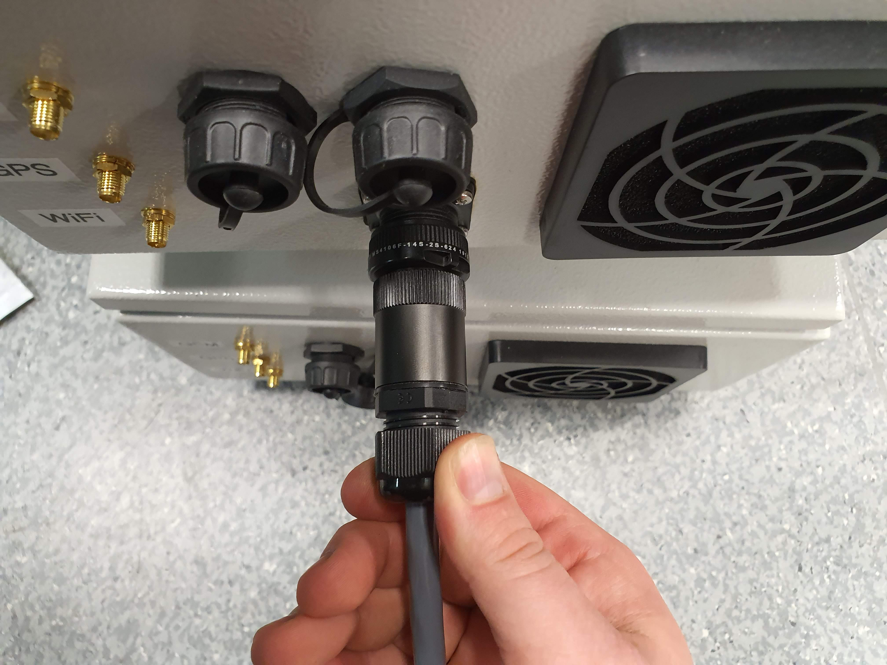
[picture p39: images/20190918_123729.jpg]

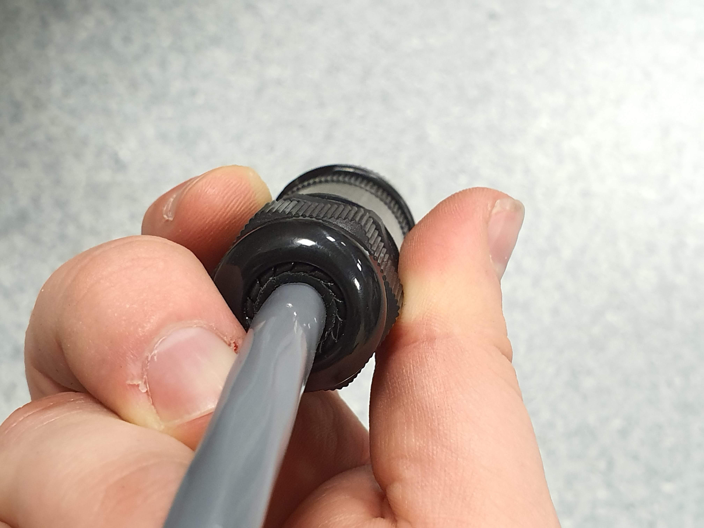
[picture p40: images/20190918_123756.jpg]

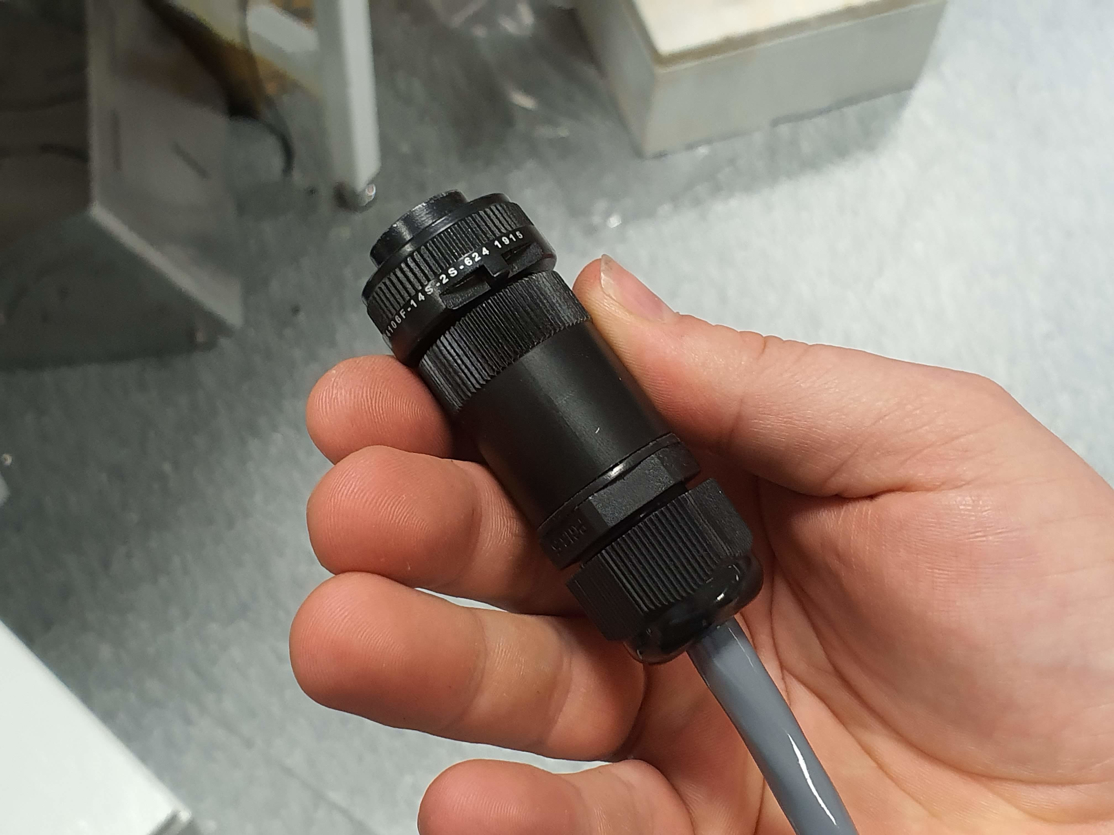
[picture p41: images/20190918_123806.jpg]

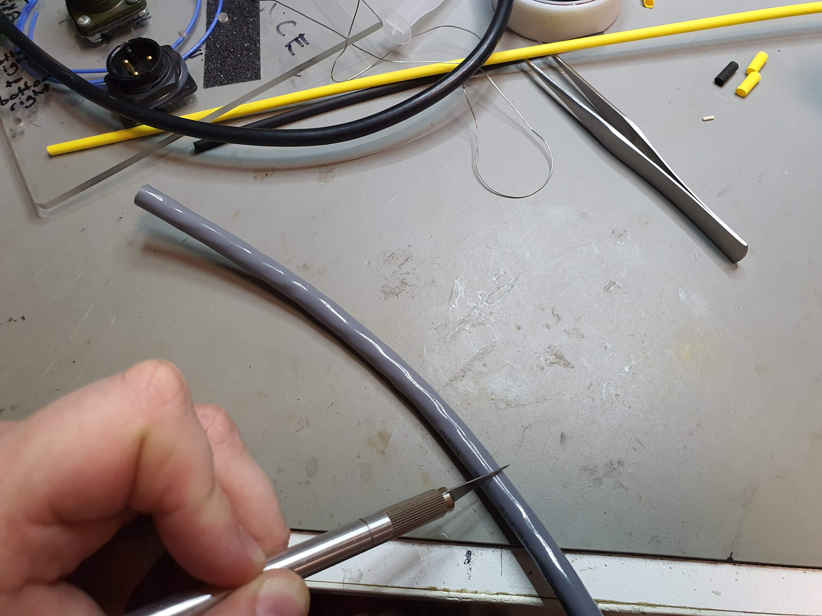
[picture p42: images/20190918_124546.jpg]


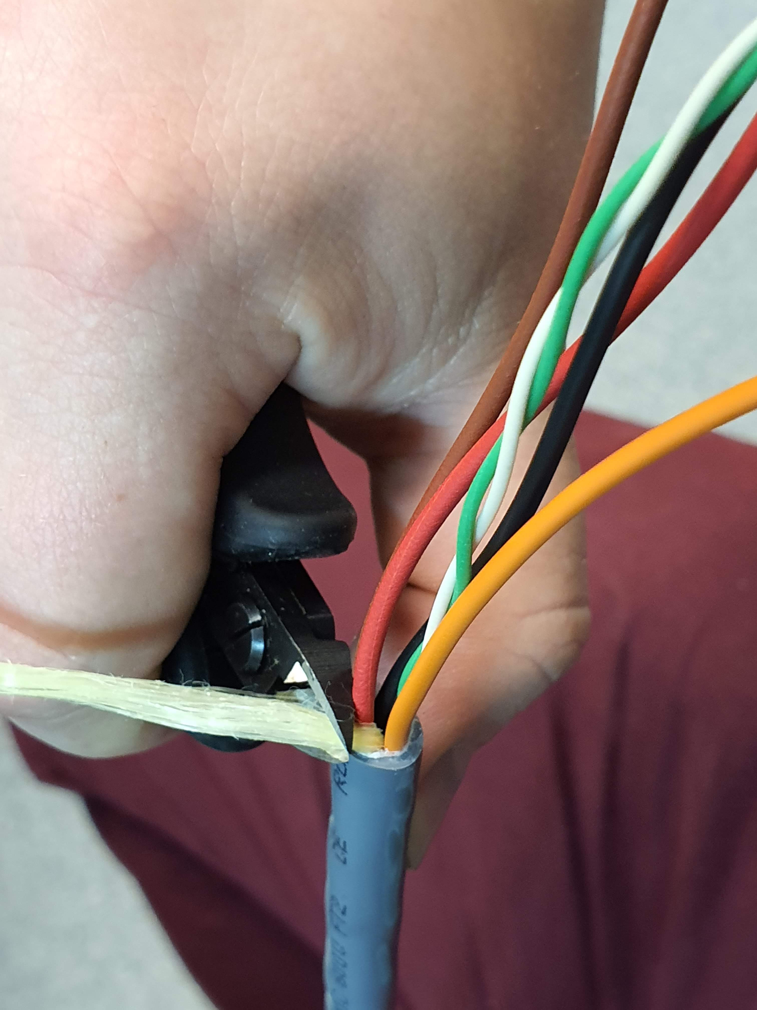
[picture p43: images/20190918_124812.jpg]


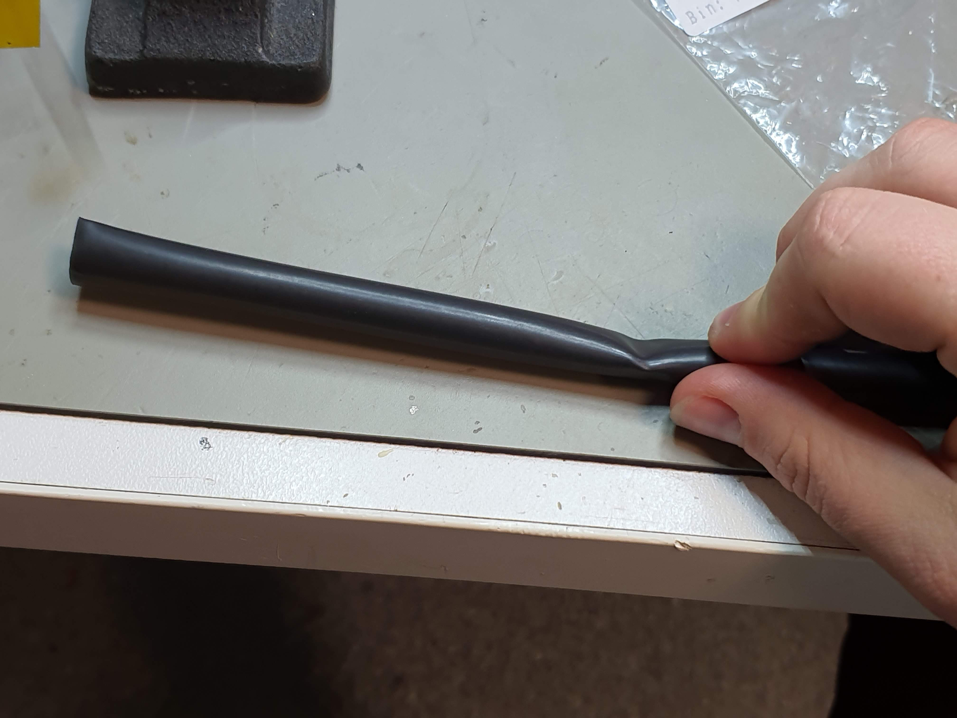
[picture p44: images/20190918_140828.jpg]

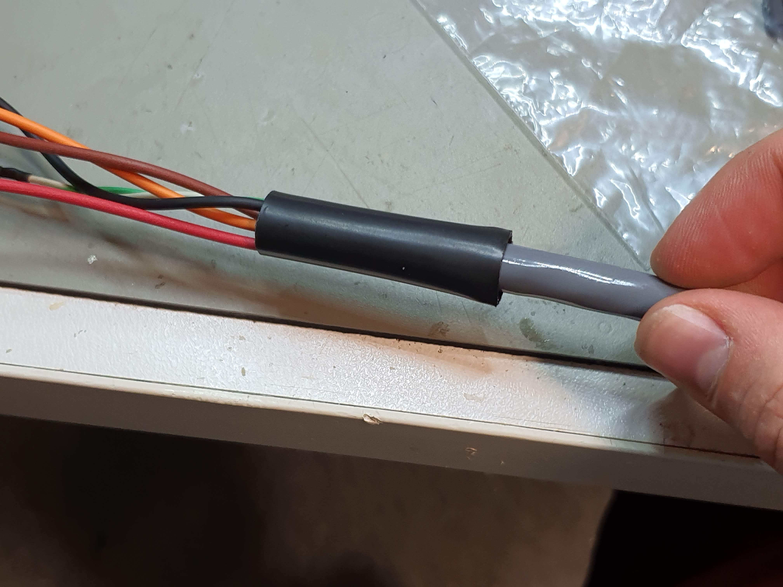
[picture p45: images/20190918_140939.jpg]


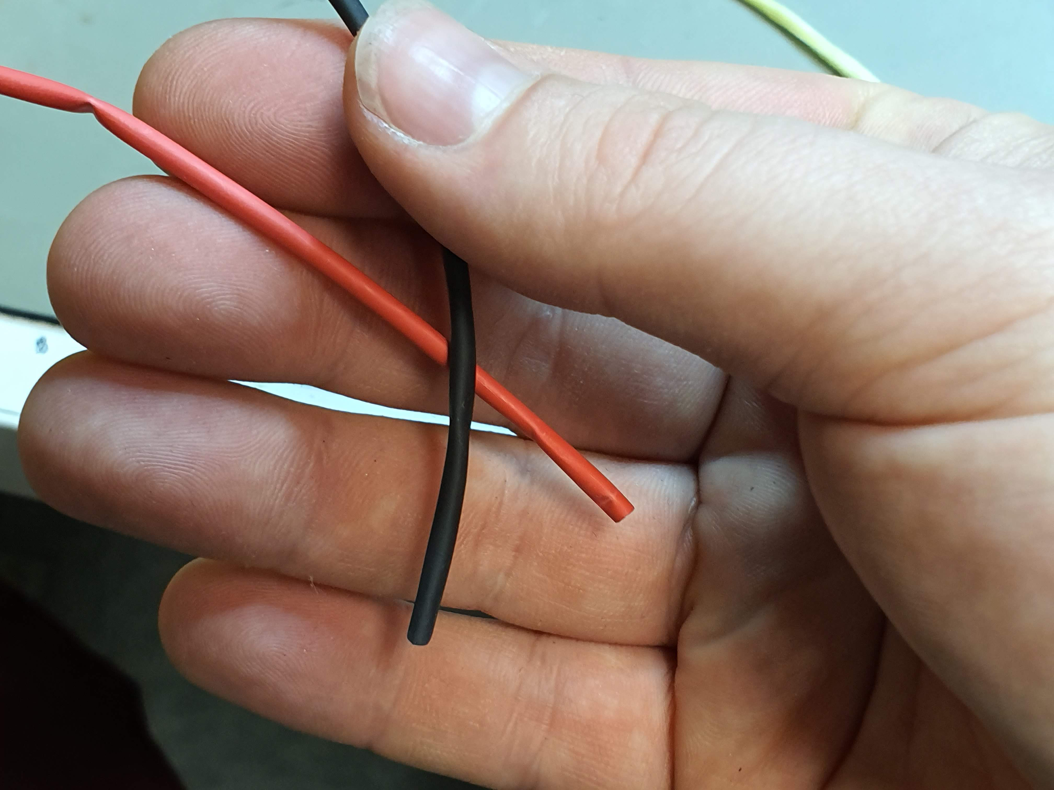
[picture p46: images/20190918_125003.jpg]

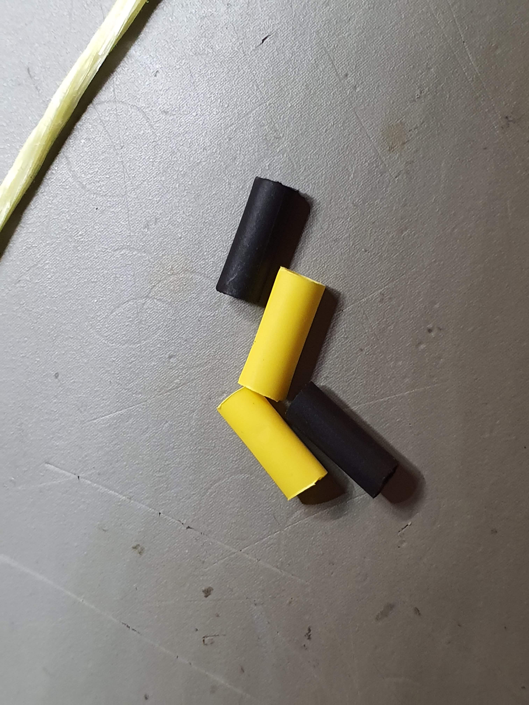
[picture p47: images/20190918_124842.jpg]

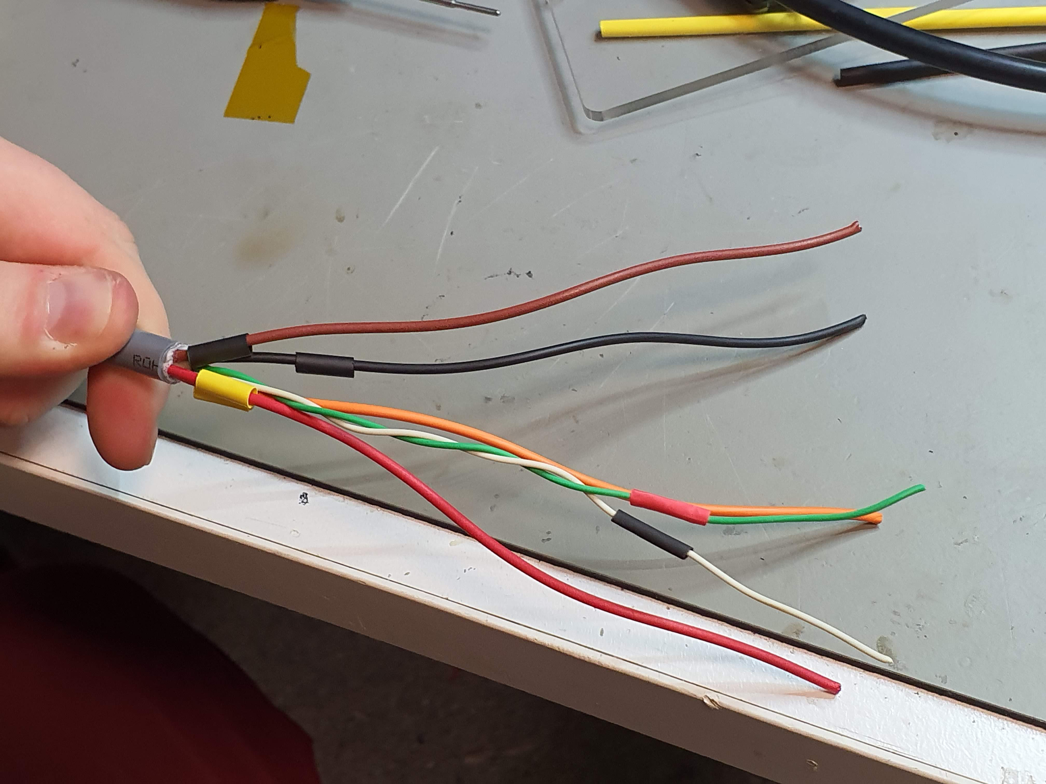
[picture p48: images/20190918_125102.jpg]

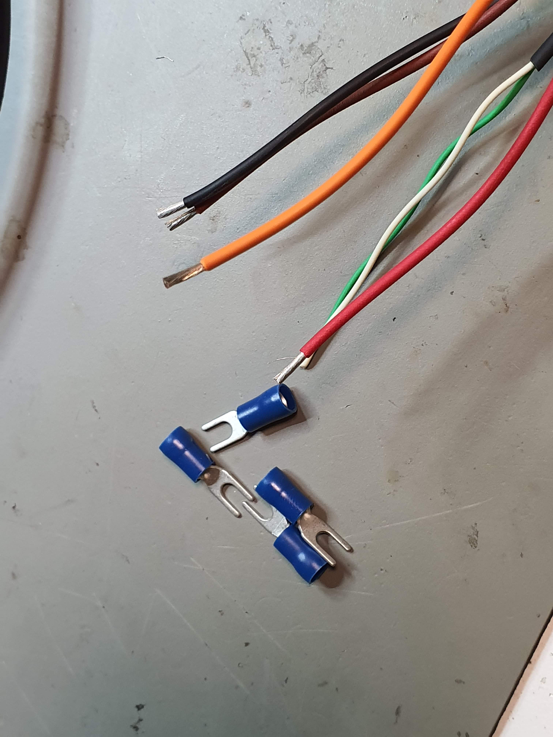
[picture p49: images/20190918_135624.jpg]

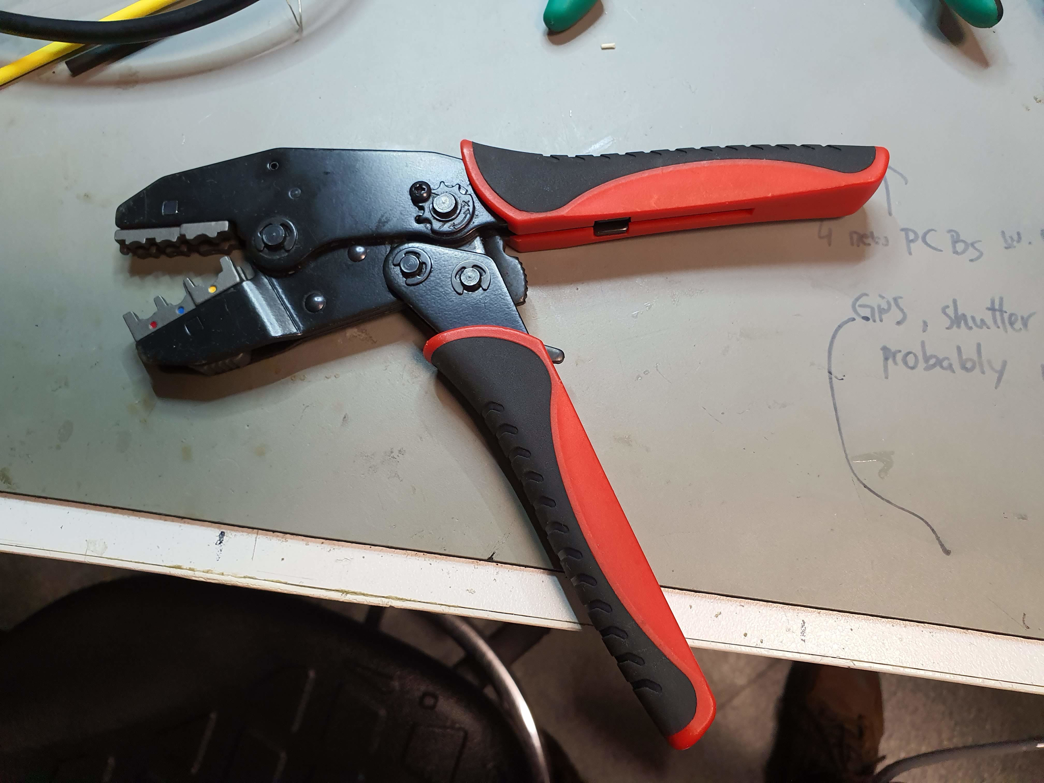
[picture p50: images/20190918_135630.jpg]

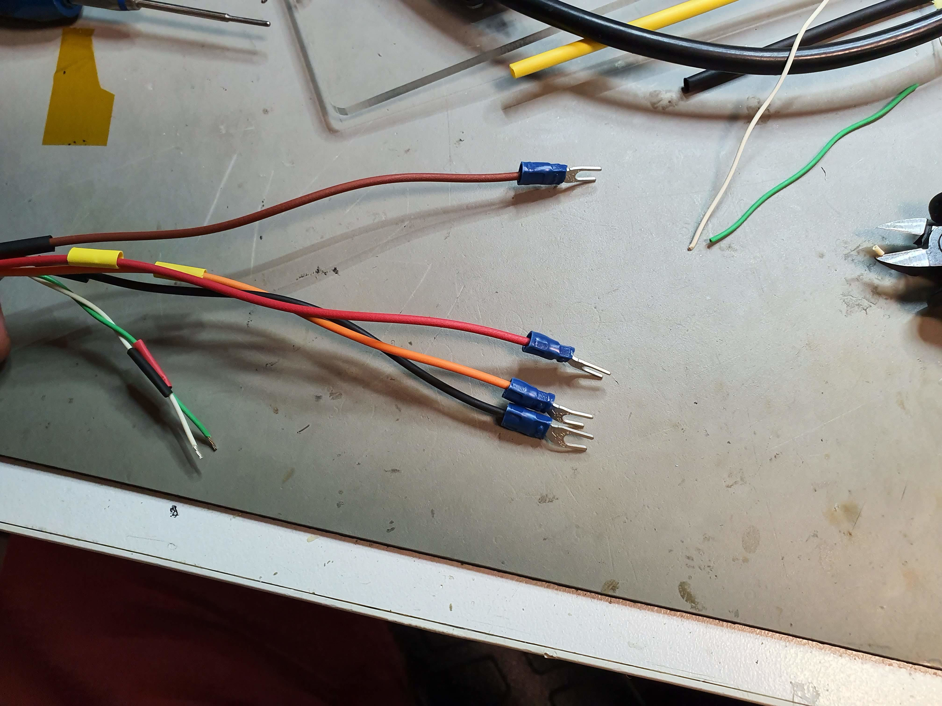
[picture p51: images/20190918_135819.jpg]

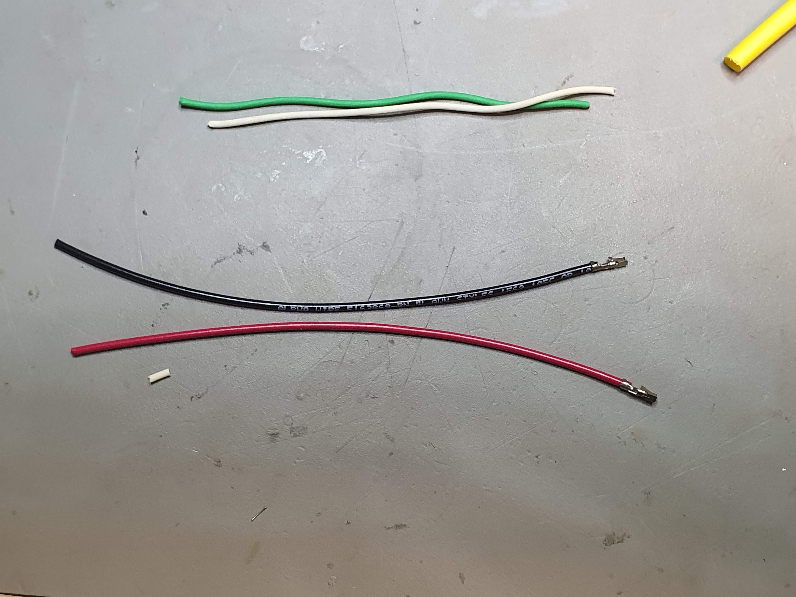
[picture p52: images/20190918_140019.jpg]

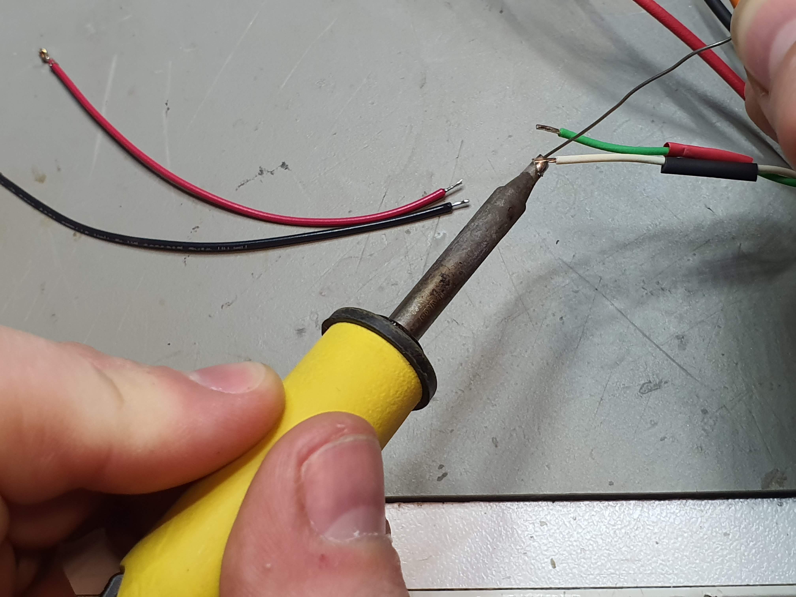
[picture p53: images/20190918_140158.jpg]

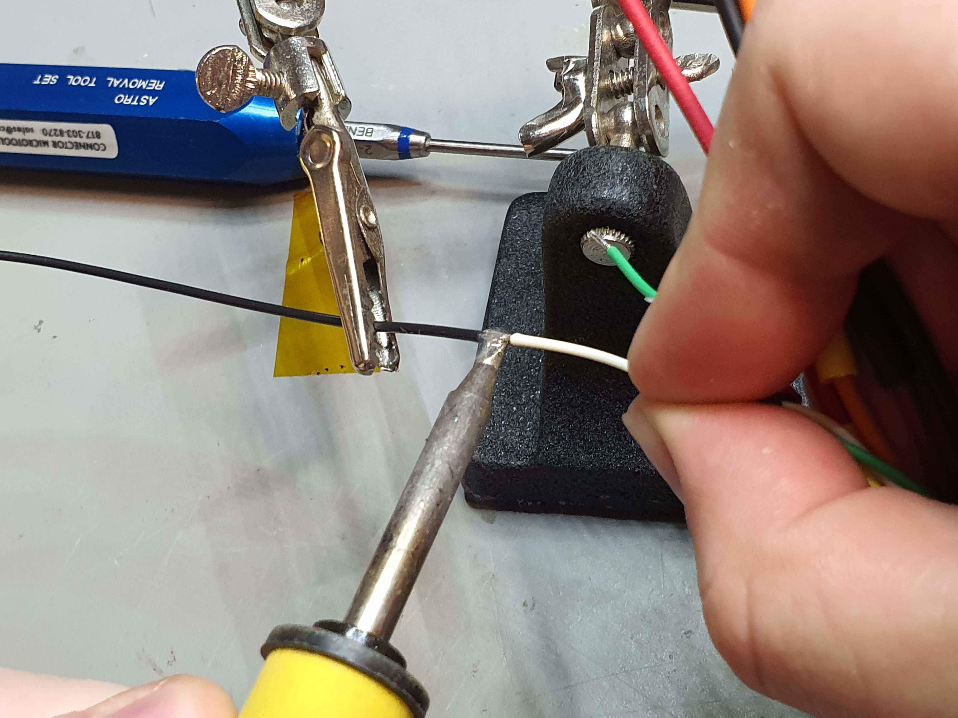
[picture p54: images/20190918_140254.jpg]

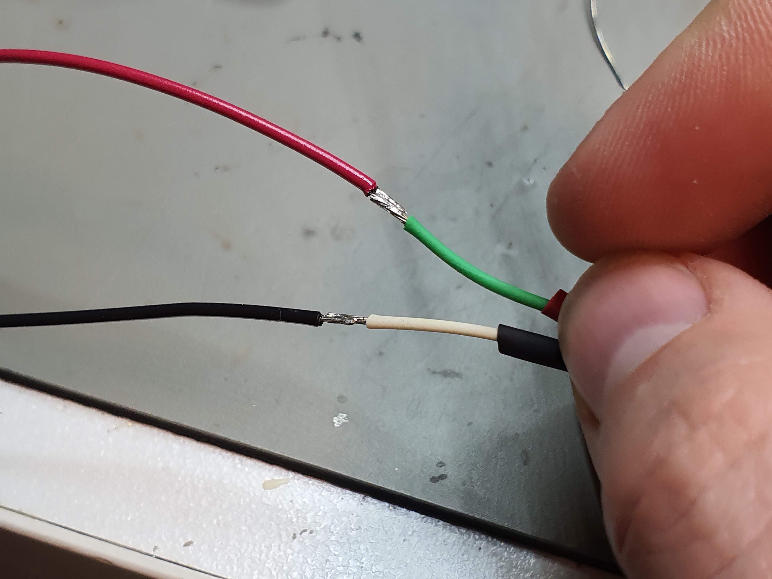
[picture p55: images/20190918_140334.jpg]

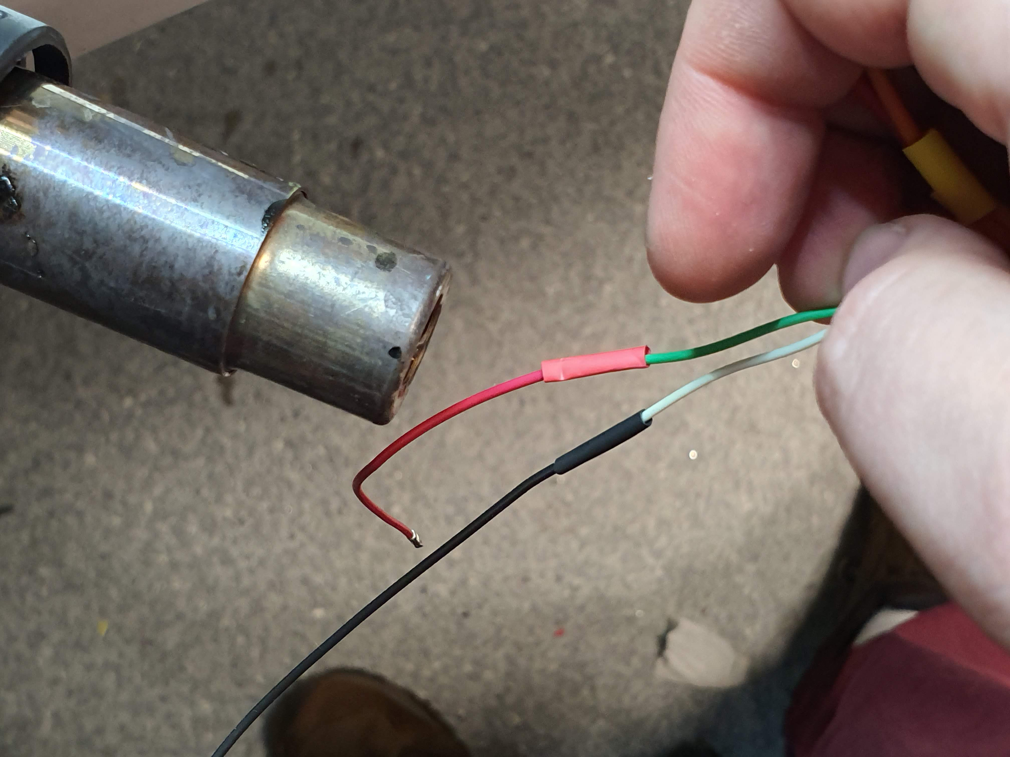
[picture p56: images/20190918_140355.jpg]

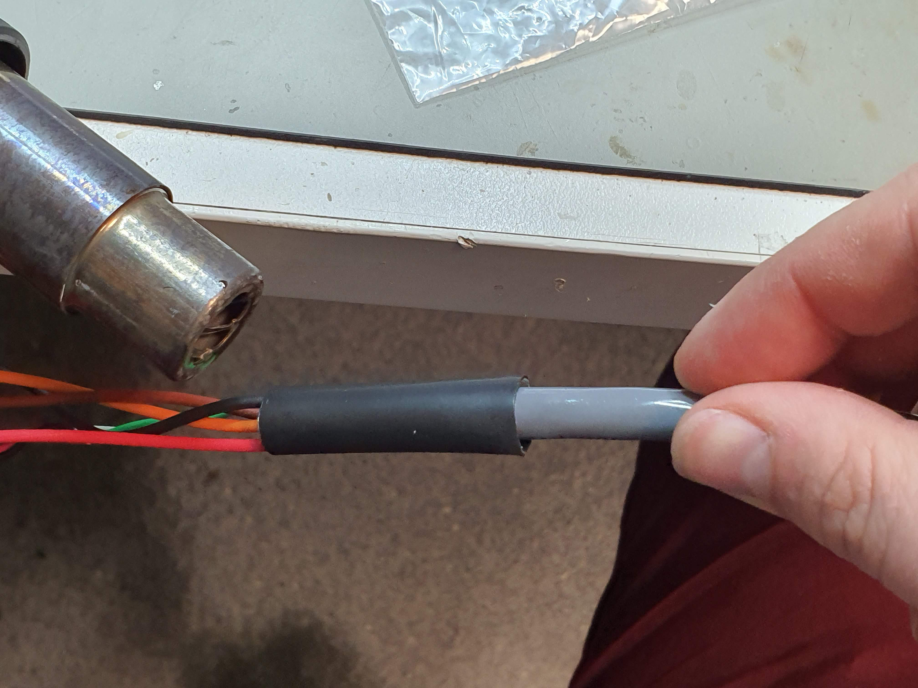
[picture p57: images/20190918_140948.jpg]


add df 11 stuff

<figure>
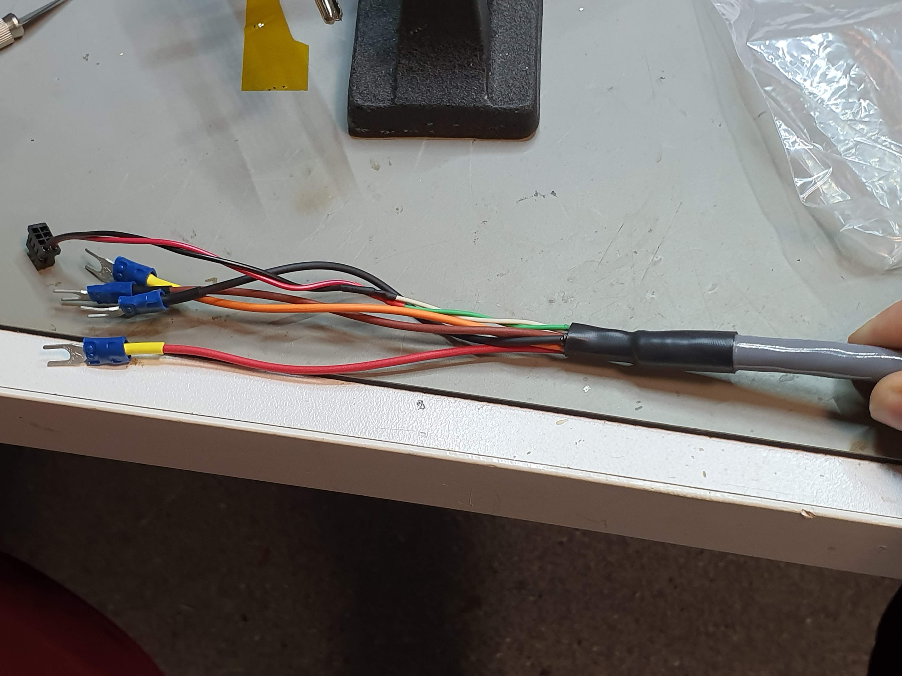
[picture p58: wiki/images/20190918_141031.jpg]

<figcaption>20190918_141031.jpg</figcaption>
</figure>
