desertfireballnetwork/observatories_technical_wiki/AMOS_Australia.md

# General

## Solar charger controller

user manual: user manual

datasheet:
datasheet

## DC-DC converter

datasheet: datasheet

## Modem-Router with digital output control (relay)

[Bivocom TG451 user
guide](https://www.bivocom.com/wp-content/uploads/2021/08/TG451-Series-Router-User-Guide-V3.pdf)

[USR-G809](https://shop.usriot.com/4G-Industrial-Cellular-Router-G809.html)

## Relay wiring

Relay D0 should be DFN camera.

Relay D1 should be Amos.

First design (off by default)
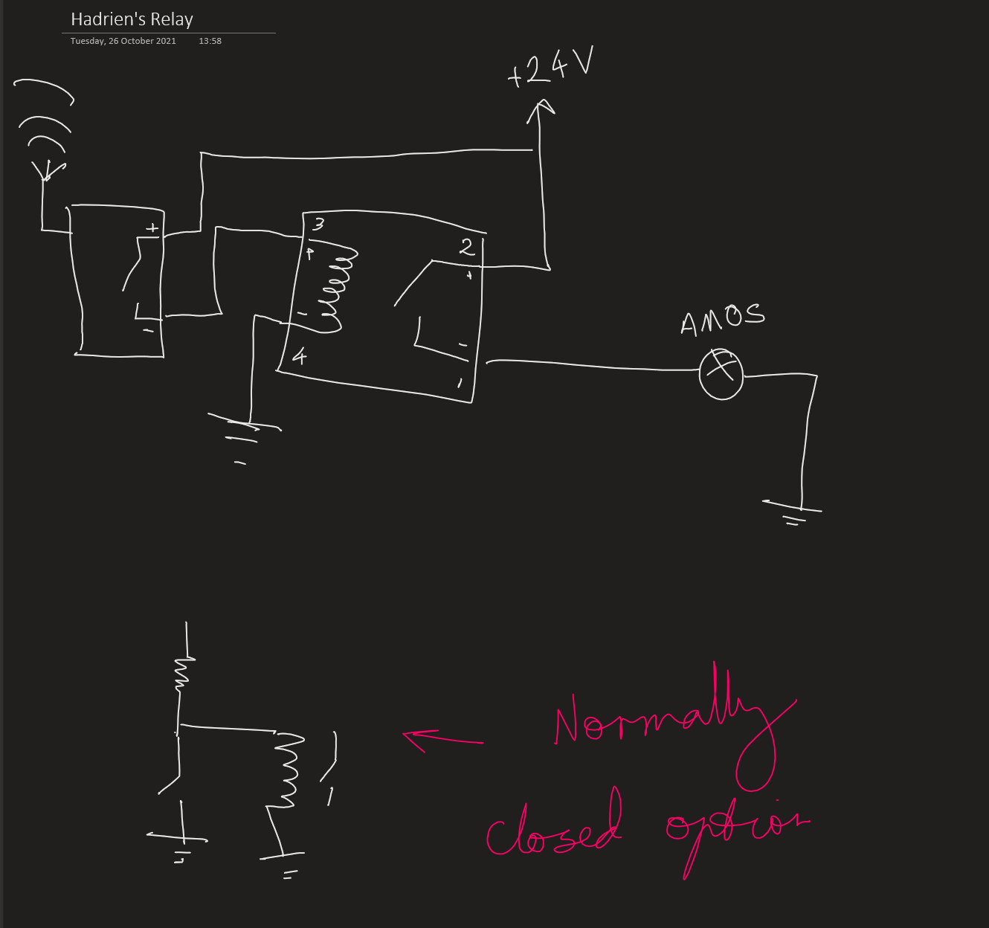
[picture p59: images/Robert_AMOS_relay_wiring.png]


New design (on by default). Use a 2.2kΩ resistor.

<figure>
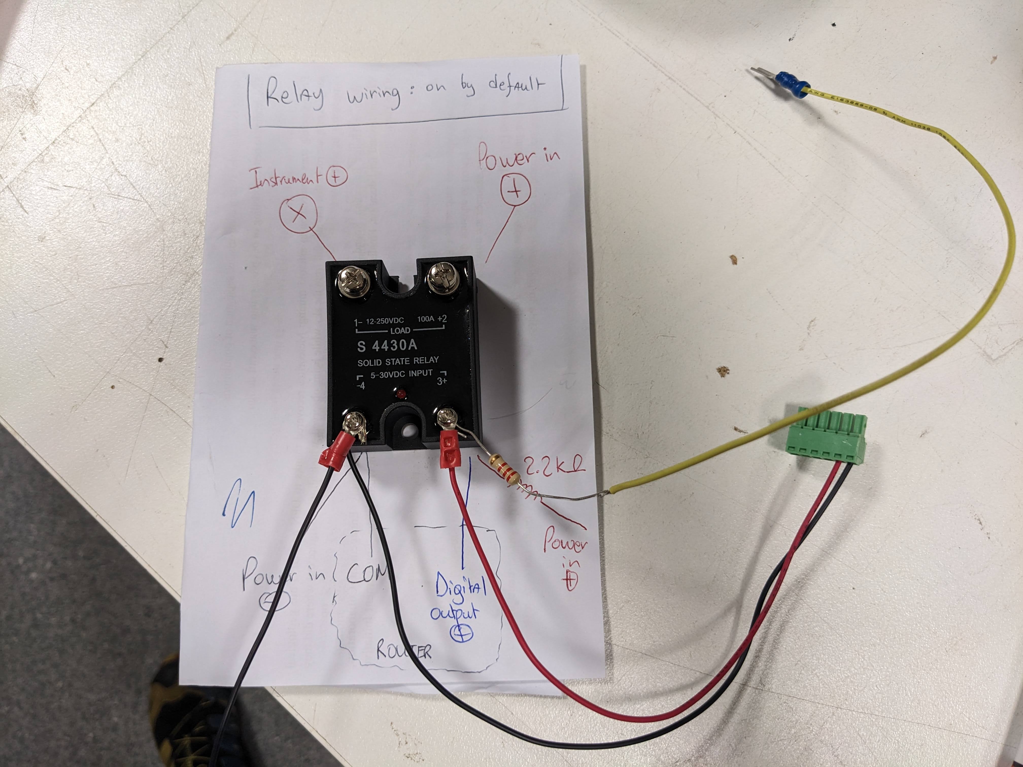
[picture p60: images/PXL_20230105_092055680.jpg]

<figcaption>PXL_20230105_092055680.jpg</figcaption>
</figure>

## AMOS-Spec for fireballs

[BIOS configuration](AMOS-Spec_fireball_BIOS_configuration.html)

## Replace HDD

1\) Open the side.

2\) System shutdown. Either:

` A) connect screen and keyboard, figure out and note the folder structure on the data HDD and how/where it is attached to the filesystem, to be able to replicate that with the new drive. Shutdown the system.`
` B) Ask the Slovak team to shut the system down.`

3\) Disconnect power (either by disconnecting the cable, or switching
the output off on the MPPT.

4\) Replace the HDD physically, label the old drive with masking tape
(location, which system - AMOS All-sky or Spectral, date).

5\) Let the Slovak colleagues know, to verify all works well, and
reformat if necessary.

# Forrest

<File:PXL> 20211118 013341701.jpg\| <File:PXL> 20211118
013016049.MP.jpg\| <File:PXL> 20211118 012738885.jpg\| <File:PXL>
20211118 012719280.jpg\| <File:PXL> 20211117 063816287.jpg\| <File:PXL>
20211118 012704049.jpg\| <File:PXL> 20211118 012640752.jpg\|

# Mundrabilla

<File:PXL> 20211117 012333528.jpg\| <File:PXL> 20211117 010557006.jpg\|
<File:PXL> 20211117 010525287.jpg\| <File:PXL> 20211117 010518661.jpg\|
<File:PXL> 20211116 205348092.jpg\| <File:PXL> 20211117 010305724.jpg\|
