desertfireballnetwork/observatories_technical_wiki/Focusing_the_DSLR.md

There are many methods for focusing the DSLR. You need to be able to
capture and review an image (in a suitably dark location to observe
stars) and adjust the focus ring. This guide will describe a method for
focusing the DSLR when it is installed in the observatory.
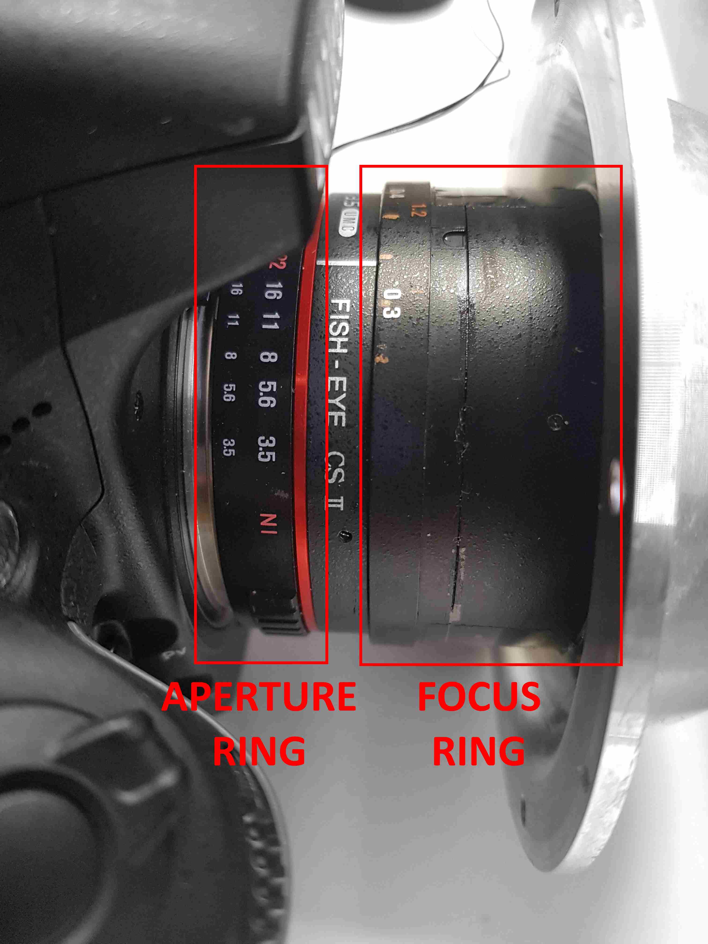
[picture p64: images/Focus_and_Aperture.jpg]

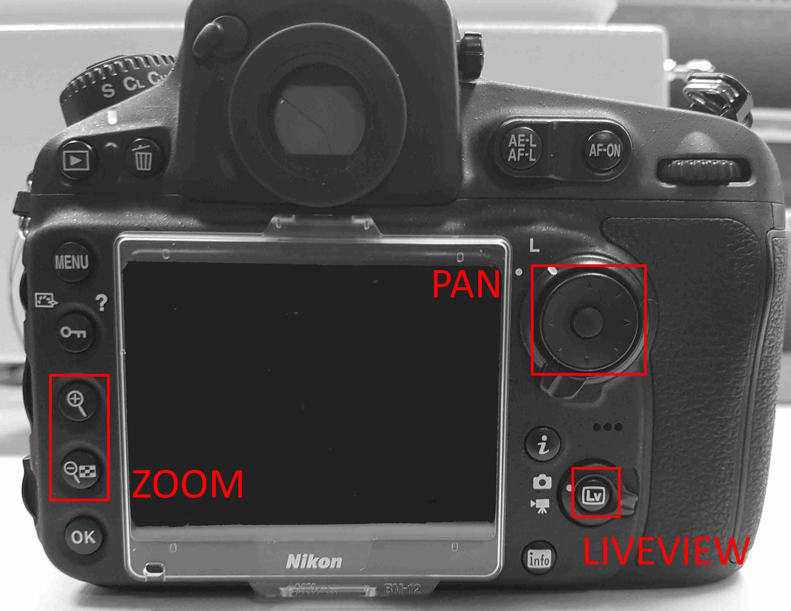
[picture p65: images/Liveview_and_navigation_buttons.jpg]


You will need:

- A monitor with a HDMI input. We use and recommend the battery powered
  [Lilliput
  A7S](https://www.bhphotovideo.com/c/product/1359220-REG/lilliput_a7s_full_hd_7.html)
  ([battery](https://www.bhphotovideo.com/c/product/836000-REG/watson_b_4206_np_f975_battery_pack_f_sony.html/pageID/accessory)).
- A HDMI Mini to HDMI cable (see
  [1](https://en.wikipedia.org/wiki/File:HDMI_Connector_Types.png) for
  HDMI connector types). You will probably need a cable with an angled
  mini HDMI cable. ([You can find some
  here](https://www.bhphotovideo.com/c/search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),
  but be sure to check that it is the mini end that is angled—if not
  both).
- A power source for the observatory and monitor.
- Visible stars.
- A method for [logging into your
  camera](Getting_Started#Connecting_to_Your_Fireball_Observatory_for_the_First_Time.html).

You should walk through these steps in a laboratory setting first when
possible, however the best location for the focus will be the intended
installation site.

1.  Attach the Nikon DSLR to the monitor using the HDMI Mini to HDMI
    cable.
2.  Power the camera using the command
    `python /opt/dfn-software/enable_camera.py` or *Camera \> Enable
    Camera* on the GUI.
3.  Remove the tape around the focus ring.
4.  Press the liveview \[Lv\] button on the back of the DSLR to enable
    output to the monitor.
5.  Find a star close to the top or bottom edge and zoom in using the
    Nikon controls.
6.  Carefully adjust the focus ring until the star is as small and round
    as possible. Turning the ring back and forth across that position
    will ensure the best position is identified.
7.  Ensure the aperture ring is still set to f22 (marked in red), the
    camera will not take pictures on any other setting.
8.  Mark the focus position on the ring and use tape to secure both the
    aperture and focus rings.

> **WARNING!**
>
> Large adjustments will damage the lens or LC shutter. Make minor
> adjustments and keep track of initial position.
>
> Some of the Samyangs have had the limiting screws removed to
> accommodate for the LC shutter in focusing. Turning to far in one
> direction will result in the destruction of the LC,
> in the other direction the lens will fall apart and become very
> difficult to reassemble.
