desertfireballnetwork/observatories_technical_wiki/Formatting_the_CF_Card.md

In the case of an error with the CF card in the DSLR the remedy is to
format the card. Formatting is also necessary when the CF card is
replaced.

During the day time, when it the DSLR is off, power it on with this
command: `python /opt/dfn-software/enable_camera.py` or through the
[GUI](Web_Interface.html) interface.
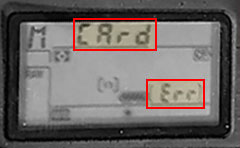
[picture p66: images/D810_Card_Error.jpg]

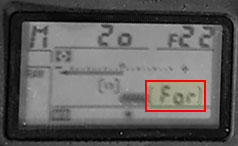
[picture p67: images/D810_Need_Format.jpg]
 In order to format the
card, the USB cable needs to be disconnected from the DSLR. The card can
be formatted through the screen menu or with the formatting buttons, in
most DFN systems it is easier to use the
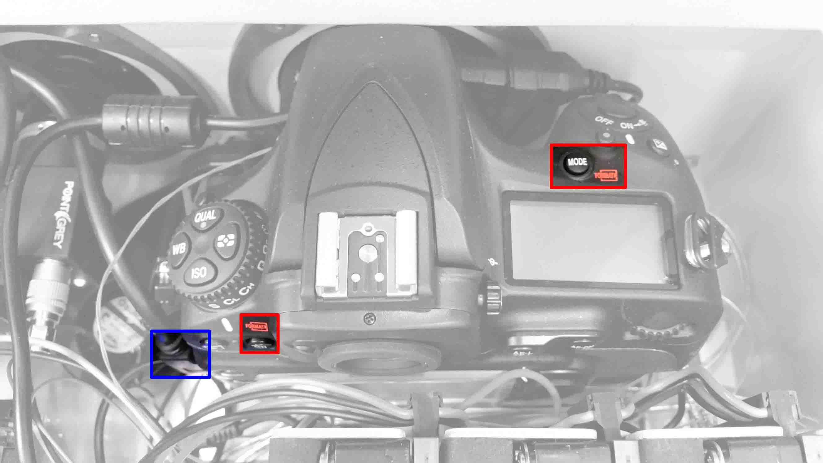
[picture p68: images/D810_Format.jpg]
buttons.

Press and hold the two formatting buttons until the screen indicates
ready to format and then release and immediately press both buttons
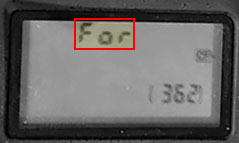
[picture p69: images/D810_Format_Ready.jpg]
again to format. 
 Power off the camera
with: `python /opt/dfn-software/disable_camera.py` or through the GUI
Interface
