desertfireballnetwork/observatories_technical_wiki/Hayabusa.md

Instructions for instruments operated during the Hayabusa-2 observation
campaign.

# Infrasound

- [Raspberry Pi (bare) logger](RPi_infrasound_logger.html)

<!-- -->

- [Blackbox logger](Blackbox_infrasound_logger.html)

<!-- -->

- [Raspberry Boom](RS&BOOM.html)

# Seismic

- [Raspberry Shake](RS&BOOM.html)

# Optical

- [DFNEXT temporary station](DFNEXT_temporary_station.html)

<!-- -->

- [DFNEXT002 Marla](DFNEXT_PC_and_video_only.html)

<!-- -->

- [Camera on tripod](camera_tripod.html)

# EM

- [log-periodic antenna + UHF receiver](log-periodic_antenna.html)

# Other

- [Absolute barometer](Absolute_barometer.html)

<!-- -->

- [Energetic Particle Detector](EPD.html)
