desertfireballnetwork/observatories_technical_wiki/Packing.md

## Contents of the box with [DFNEXT](DFNEXT.html) camera system

<figure>
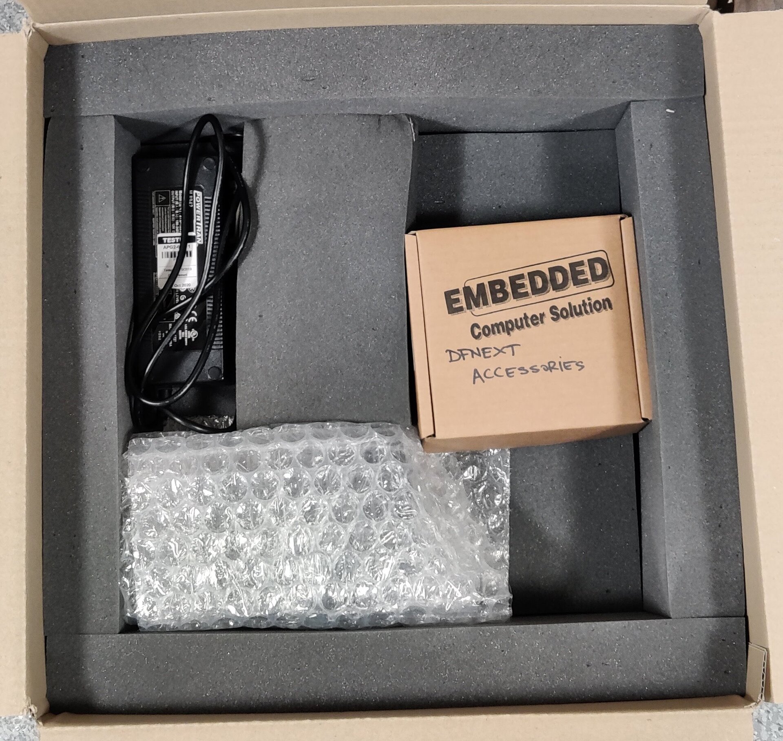
[picture p72: images/PackedBox.jpg]

<figcaption>PackedBox.jpg</figcaption>
</figure>

[DFNEXT](DFNEXT.html) packed in a box for shipping

<figure>
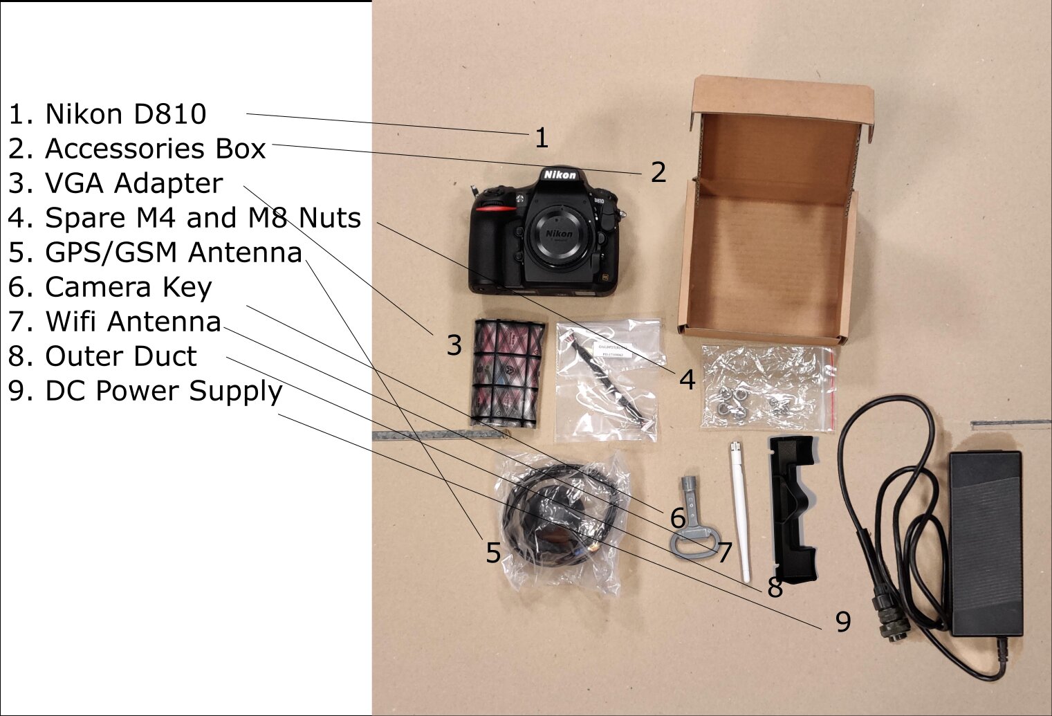
[picture p73: images/LabelledAccessories.jpg]

<figcaption>LabelledAccessories.jpg</figcaption>
</figure>

[DFNEXT](DFNEXT.html) camera system accessories - labeled photo of
what is included in the shipping box.
