desertfireballnetwork/observatories_technical_wiki/Cables.md

# DFNEXT/DFNSMALL DC Power Cable

Make your own DC power cable using these instructions
<File:DFNEXT_DC_Power_Cable_Assembly.pdf> File:DFNEXT_DC_Power_Cable_Assembly.pdf.
Useful for solar powered (~12V) sites or in case when custom/specific
AC/DC power supply is used.
