desertfireballnetwork/observatories_technical_wiki/Camera_servicing_kit.md

Tools and spare parts useful for servicing cameras.

### Bare minimum (just hard drive swap)

- camera key
- spare hard drives
- lens wipes (eg. in
  [Australia](http://www.chemistwarehouse.com.au/buy/58031/Clearwipe-Lens-Cleaner-Wipes-20))
- computer + ethernet cable OR phone/tablet

### Full kit (tools and spare)

##### Camera box related stuff

- spare camera
- camera key
- spare hard drives
- lens wipes (eg. in
  [Australia](http://www.chemistwarehouse.com.au/buy/58031/Clearwipe-Lens-Cleaner-Wipes-20))
- Nanokote (eg. in [Australia](http://www.nanokote.com.au/))
- laptop or phone/tablet
- ethernet cable 10m
- backup ethernet cable
- memory card
- GSM modem + connectors
- monitor
- VGA cable
- VGA calbe adaptor
- keyboard
- GPS/3G antenna
- 3D printed air duct (both inner and outer)
- HDD enclosure (DFNSMALL system)
- leostick (DFNSMALL system)
- Y USB cable (to power modem on DFNSMALL system)
- USB 3.0 enclosure cable (right angle, for DFNSMALL system)

##### Tools and parts

- hammer
- battery drill
- hex driver for tek screws
- drill bits
- screwdrivers set
- adjustable wrench
- 7 mm spanner
- 8 mm spanner
- 13 mm spanner
- 7-8-13 mm sockets + wrench
- sealant + sealant gun
- gaffer tape
- masking tape
- electrical tape
- multimeter
- ladder (rooftop camera)
- heavy-duty mains to camera 12V converter (AC-DC)
- conduit
- M4 sunshield nuts
- M8 camera nuts
- fencing wire

##### Solar powered system parts

- 12V deep cycle battery
- solar pannel
- cable battery-panels
- cable battery-camera
- solar power regulator
- solar pannel seals
- tek screws

##### Fenced systems

- fence post
- barbed wire
- fencing pliers
- sledge hammer
