desertfireballnetwork/observatories_technical_wiki/Getting_Help.md

Try the wiki search in the upper right as not all pages may be linked
sensibly.

For help with camera installation, maintenance and operations please
email DFN camera help at
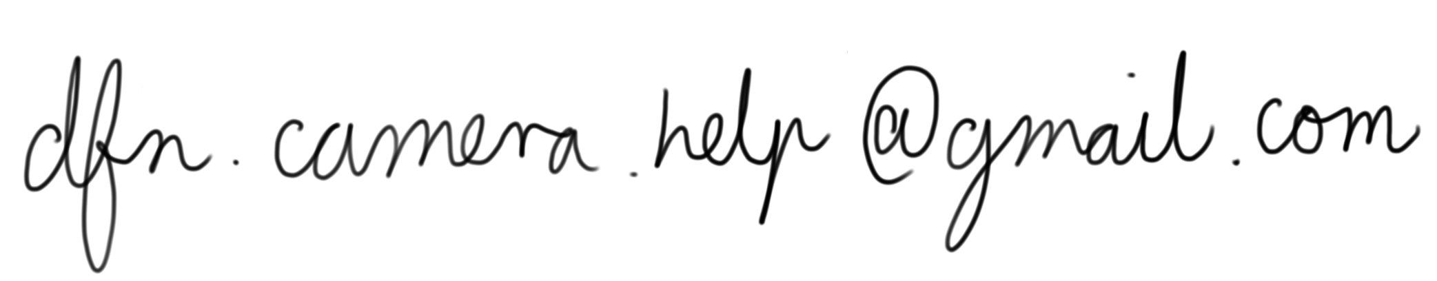
[picture p81: images/DFN_camera_help_email_address.png]


For help with data processing and fireball events please email DFN
events at
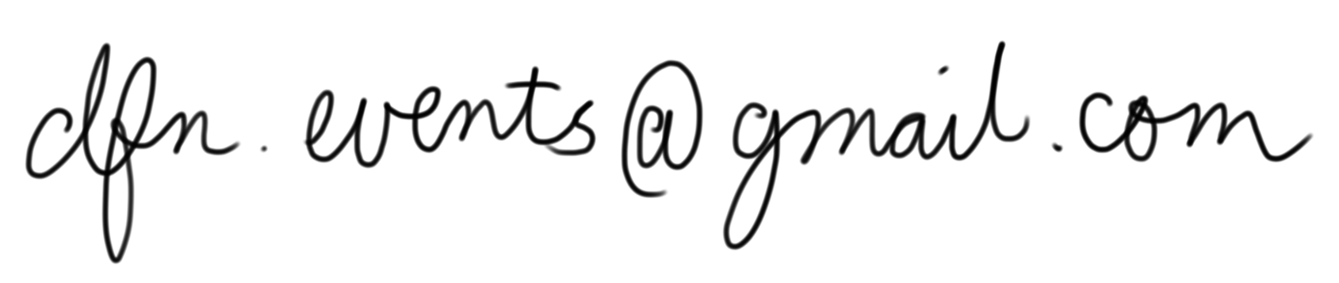
[picture p82: images/DFN_events_email_address.png]
