desertfireballnetwork/observatories_technical_wiki/Temporary_battery_with_sunshield.md

This is to power a temporary instrument in the field, and protect it
from the sun (and rain).

Things required:

- 13mm screwdriver (preferred), or 13mm spanner
- Battery
- Plywood board (as sunshield)

# Transport

On each terminal: 2 metal M8 washers + 2 large nylon M8 washers + M8
nylon bolt

<figure>
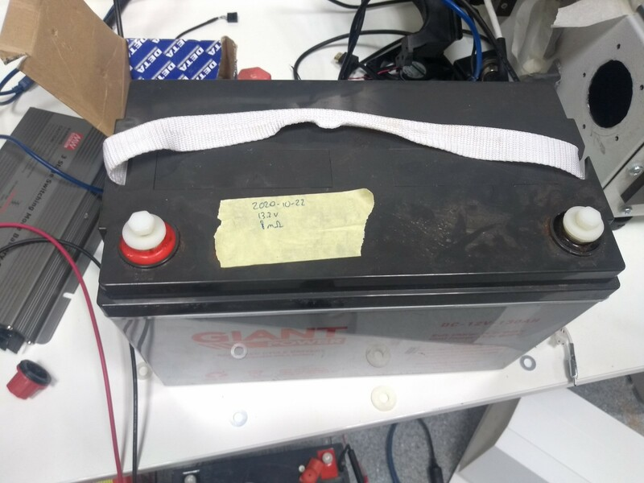
[picture p83: images/130Ah_battery.jpg]

<figcaption>130Ah_battery.jpg</figcaption>
</figure>

# Setup

Bolt together (from bottom to top):

- battery terminal
- metal washer
- lead ring terminal
- metal washer
- nylon washer
- plywood board
- nylon washer
- (bolt)

<figure>
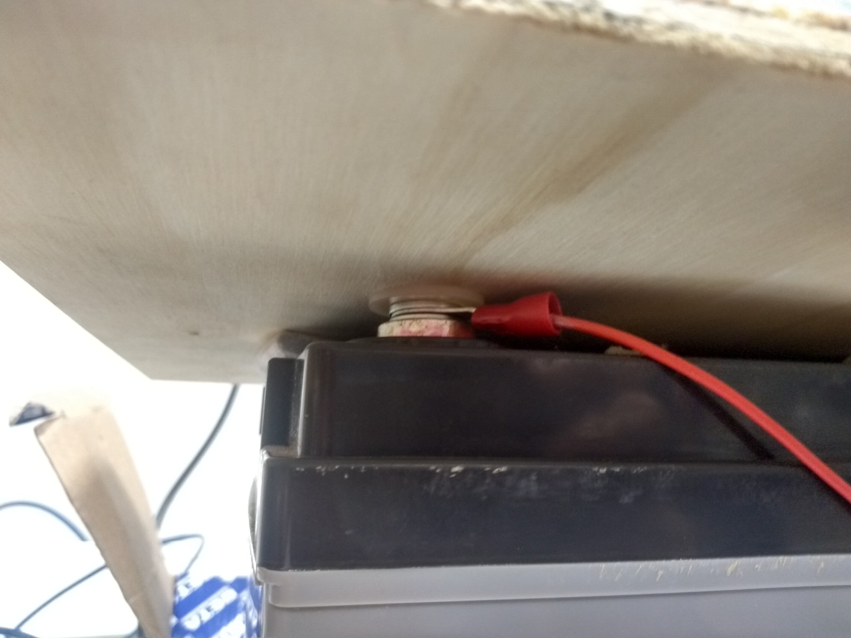
[picture p84: images/Batt_terminal_connection.jpg]

<figcaption>batt_terminal_connection.jpg</figcaption>
</figure>

<figure>
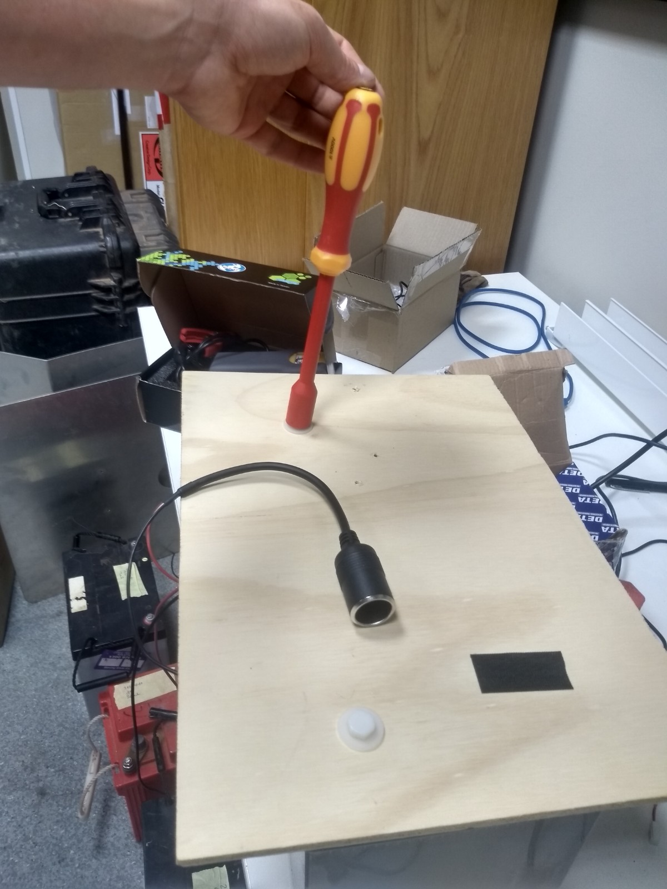
[picture p85: images/Battery_finished_setup.jpg]

<figcaption>battery_finished_setup.jpg</figcaption>
</figure>
