desertfireballnetwork/observatories_technical_wiki/wiki/Main_Page.md

Welcome to the [Desert Fireball
Network's](wikipedia:Desert_Fireball_Network "wikilink") and Global
Fireball Observatory public wiki. This wiki contains documentation for
the the DFN's fireball observatories and data processing procedures for
collaborators and team members. The main GFO website is on
<https://gfo.rocks>, Australian DFN website can be found at
<https://dfn.gfo.rocks> and the DFN outreach portal is
<http://fireballsinthesky.com.au/>.

**Please contribute where you can** by uploading information, designs
and files that will help others with installation, maintenance and
operation. By documenting your problems and solutions here, you can help
other collaborators get up and running faster. **We need your help to
get cameras off shelves and under the night sky looking for space
rocks!**

# Fireball Observatories

Documentation to help you get your observatory up and running

- [Re-configuring VPN in camera systems - 2023
  change](Reconfigure_VPN "wikilink")
- [Contents of the box with DFNEXT system](Packing "wikilink")
- [Getting Started](Getting_Started "wikilink")
- [Maintenance](Camera_Maintenance "wikilink")
- [Troubleshooting](Camera_Troubleshooting "wikilink")
- [Getting Help](Getting_Help "wikilink")
- Frequently asked questions ([FAQ](FAQ "wikilink"))

# Fireball Data

How to access your fireball images and information about how the DFN
processes fireball ev

- [Accessing data](Accessing_data "wikilink") captured by Fireball
  Observatory (still images, videos, logs)
- [Finding Fireballs](Finding_Fireballs "wikilink") in images
- [Data Processing Pipeline](Data_Processing_Pipeline "wikilink")

# Meteorite searching

- Foot searching:
  [Meteorite_searching_advice_handbook.pdf](Media:Meteorite_searching_advice_handbook.pdf "wikilink")
- Drone Meteorite Searching:
  <https://desertfireballnetwork.github.io/drone_meteorite_doc/>

# Resources

Collections of things you might find useful. **Contributions to this
section are especially appreciated**

Todo: find a better name for this section

- [Mechanical Designs](Mechanical_Designs "wikilink") for deploying your
  fireball observatory (add your stand and roof mount designs here)
- [Cables](Cables "wikilink") used in fireball observatories and for
  deployment
- [Photos of Fireballs](Fireball_Photos "wikilink") (add your pretty
  fireball to the galleries here at reduced resolutions for everyone to
  see; remember this wiki is open to the public)
- [Photos of Fireball Camera
  Installations](Photos_of_Fireball_Camera_Installations "wikilink")
  (upload photos of your finished and in-progress installations here)

# [Hayabusa](Hayabusa "wikilink")

# Wiki Info

Users with accounts may edit the wiki, and anyone may view the wiki
(even without logging in).

Internal links do not work in edit mode (it's a bug), but work as
expected in read mode.

File uploads are restricted to certain types of files. If you require a
new filetype to be added, please email DFN camera help.

Click the DFN fireball in the upper left at any time to get back to this
main page.

[Help Editing Wiki Pages](mediawikiwiki:Help:Editing_pages "wikilink"),
[Formatting Help](mediawikiwiki:Help:Formatting "wikilink"), [The
MediaWiki
VisualEditor](mediawikiwiki:Help:VisualEditor/User_guide "wikilink"),
[Orphaned Pages](Special:OrphanedPages "wikilink"), [DFN Wiki To-do
List](Wiki_To-do_List "wikilink")

__NOTOC__
