desertfireballnetwork/observatories_technical_wiki/DFNSMALL.md

The DFNSMALL was the first production digital observatory design
deployed by the DFN. The majority of the Australian systems are of this
iteration. The successor to the DFNSMALL design was the
[DFNEXT](DFNEXT.html).

<figure>
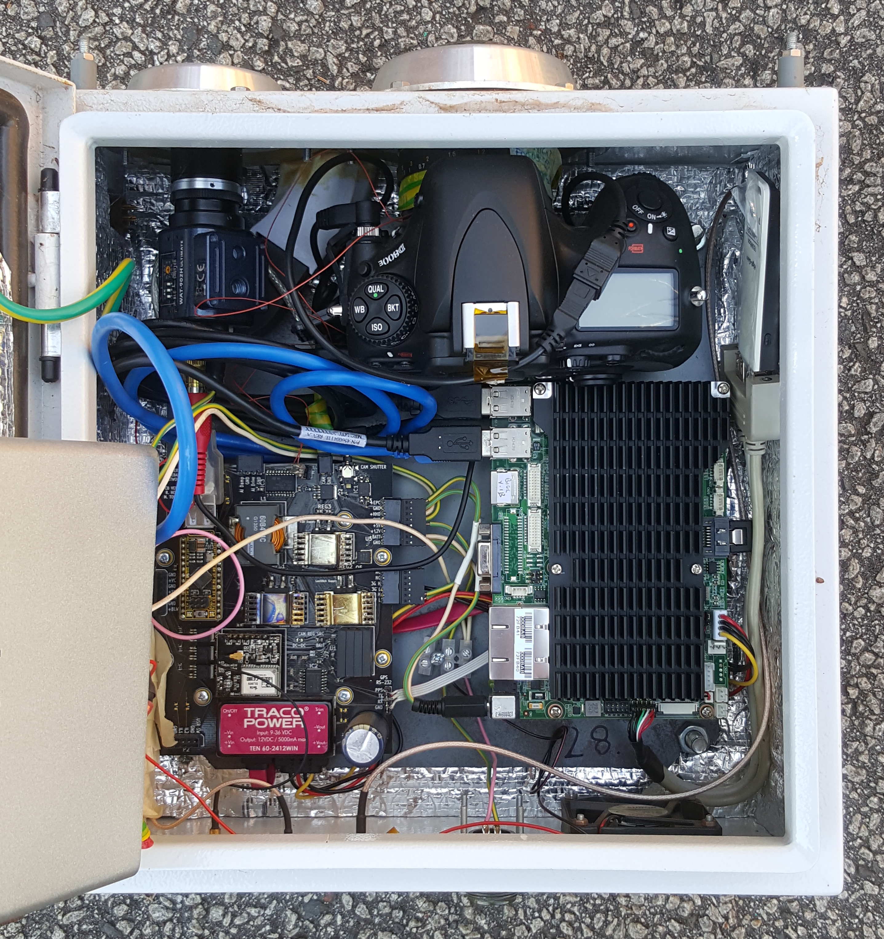
[picture p132: images/DFNSMALL_Internals.jpg]

<figcaption>DFNSMALL_Internals.jpg</figcaption>
</figure>
