desertfireballnetwork/observatories_technical_wiki/Meteorite_Dropping_Fireball_Procedure.md

Congratulations! You've seen a meteorite fall 👍
