desertfireballnetwork/observatories_technical_wiki/data-processing/Fireball_Photos.md

---
title: "Fireball Photos"
parent: "Data Processing"
---

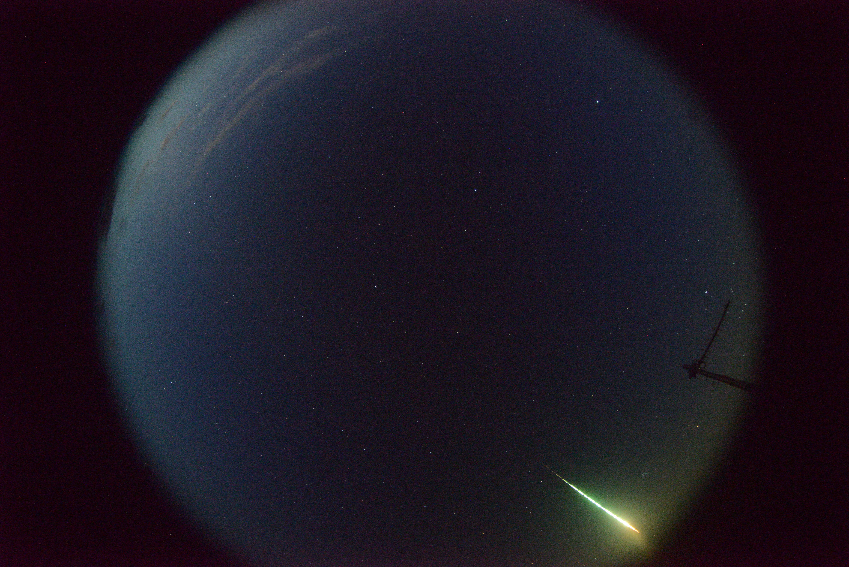
[picture p134: images/Murrili_Fireball.jpg]
Murrili

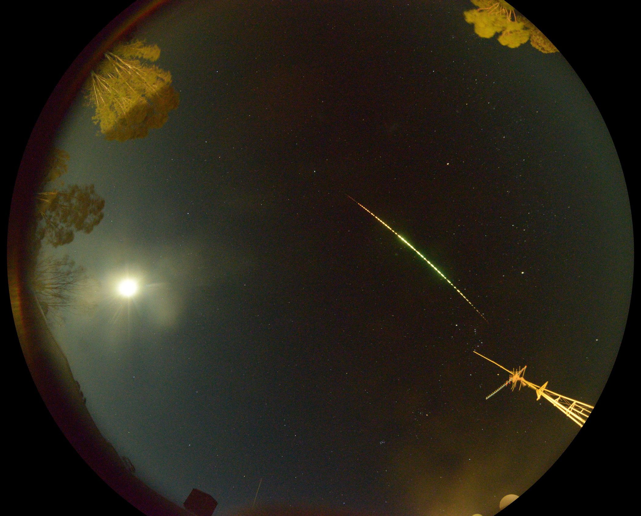
[picture p135: images/A_Fireball.jpg]
A
