desertfireballnetwork/observatories_technical_wiki/observatories/dfnsmall/index.md

---
title: "DFNSMALL"
has_children: true
parent: "Observatories"
---
The DFNSMALL was the first production digital observatory design
deployed by the DFN. The majority of the Australian systems are of this
iteration. The successor to the DFNSMALL design was the
[DFNEXT]({% link observatories/dfnext/index.md %}).



## which version of DFNSMALL?

This is the second generation of DFNSMALL with Commell LE-37D PC (note the Commell PC has silver coulour heat sink):


The first generation had Advantech PCs (black anodized heatsink):
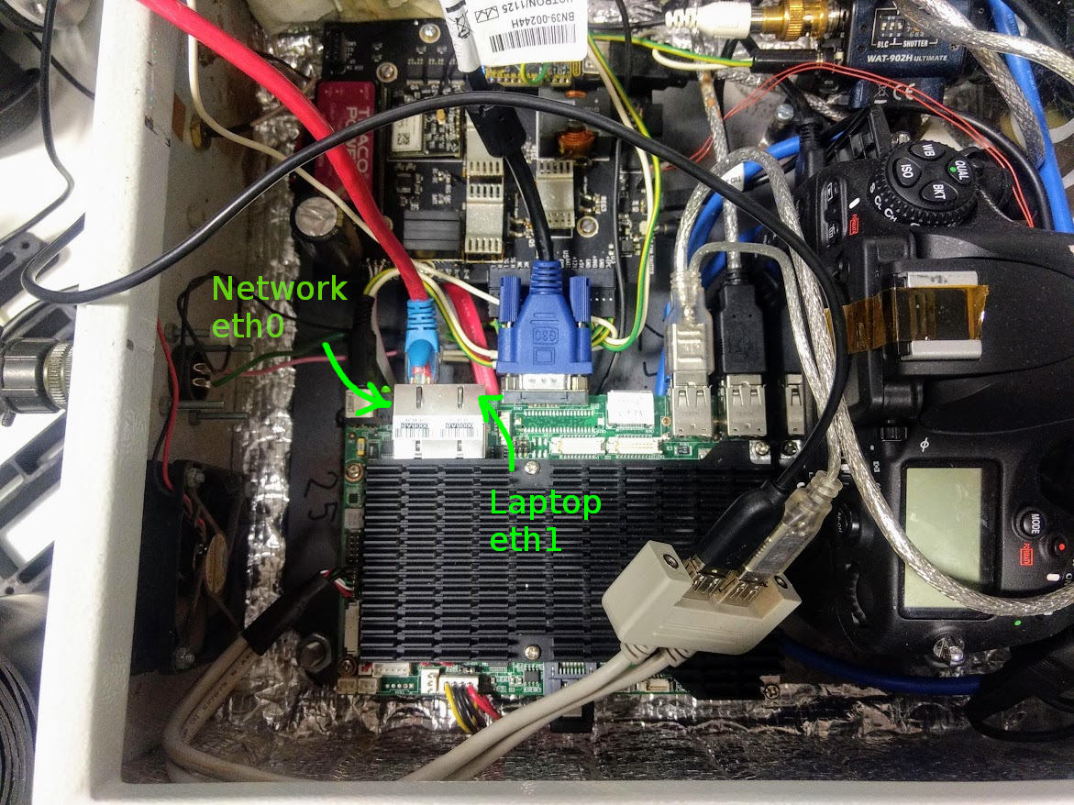
[picture p136: images/DFNSMALL_Advantech_PC_eth_ports_marked.jpg]
