desertfireballnetwork/observatories_technical_wiki/images/Starlink_wifi_extender.pdf

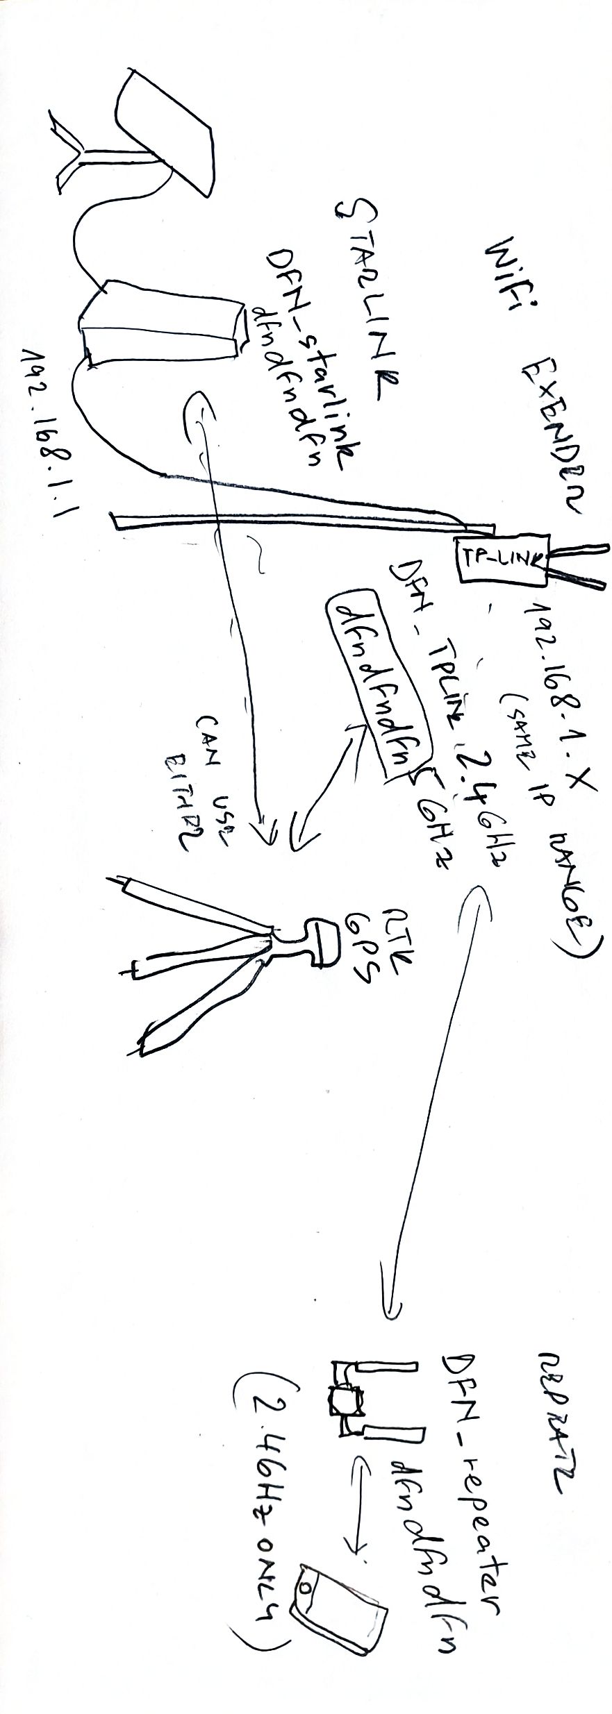
[picture p137: figure]
