desertfireballnetwork/observatories_technical_wiki/wiki/Hayabusa.md

Instructions for instruments operated during the Hayabusa-2 observation
campaign.

# Infrasound

- [Raspberry Pi (bare) logger](RPi_infrasound_logger "wikilink")

<!-- -->

- [Blackbox logger](Blackbox_infrasound_logger "wikilink")

<!-- -->

- [Raspberry Boom](RS&BOOM "wikilink")

# Seismic

- [Raspberry Shake](RS&BOOM "wikilink")

# Optical

- [DFNEXT temporary station](DFNEXT_temporary_station "wikilink")

<!-- -->

- [DFNEXT002 Marla](DFNEXT_PC_and_video_only "wikilink")

<!-- -->

- [Camera on tripod](camera_tripod "wikilink")

# EM

- [log-periodic antenna + UHF receiver](log-periodic_antenna "wikilink")

# Other

- [Absolute barometer](Absolute_barometer "wikilink")

<!-- -->

- [Energetic Particle Detector](EPD "wikilink")
