desertfireballnetwork/observatories_technical_wiki/images/20190724_212110.jpg

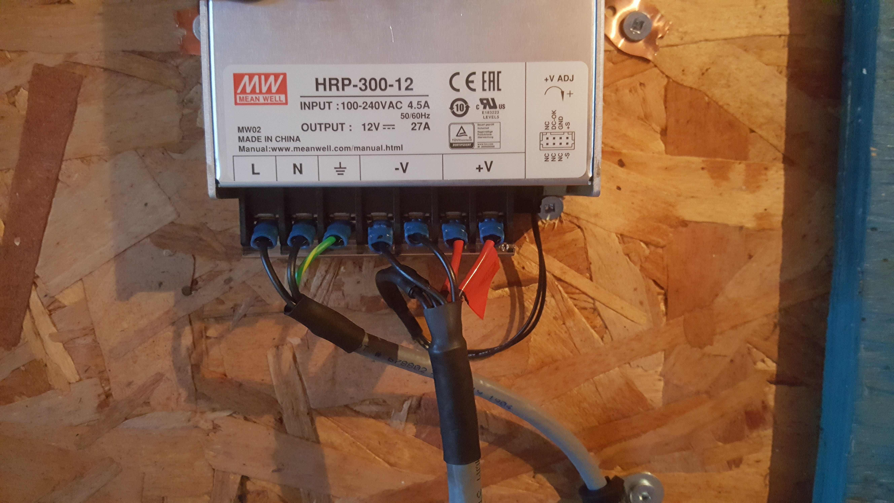
images/20190724_212110.jpg
