desertfireballnetwork/observatories_technical_wiki/images/20190725_160907.jpg

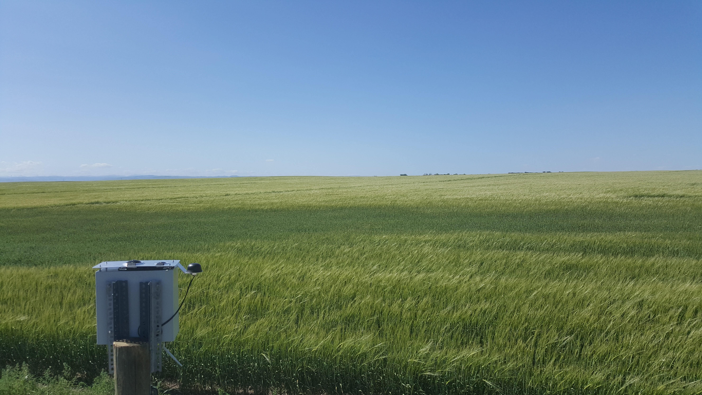
images/20190725_160907.jpg
