desertfireballnetwork/observatories_technical_wiki/images/20190918_123513.jpg

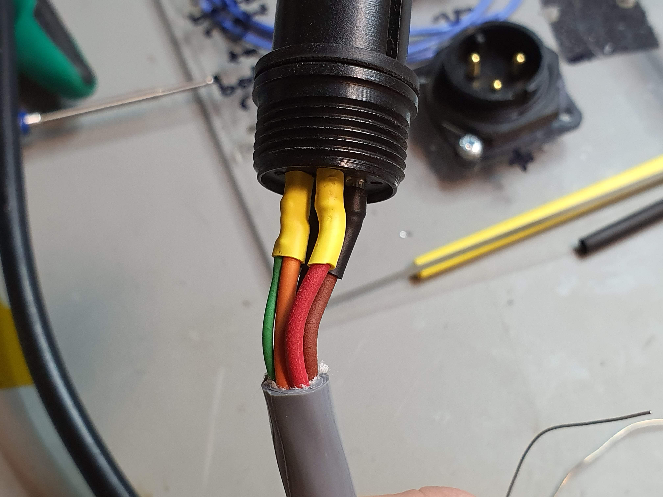
images/20190918_123513.jpg
