desertfireballnetwork/observatories_technical_wiki/images/20190918_123550.jpg

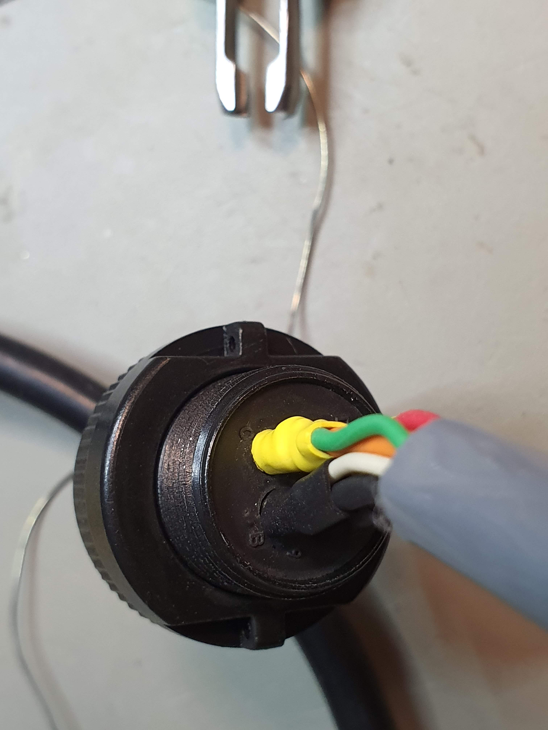
images/20190918_123550.jpg
