desertfireballnetwork/observatories_technical_wiki/images/20190918_123612.jpg

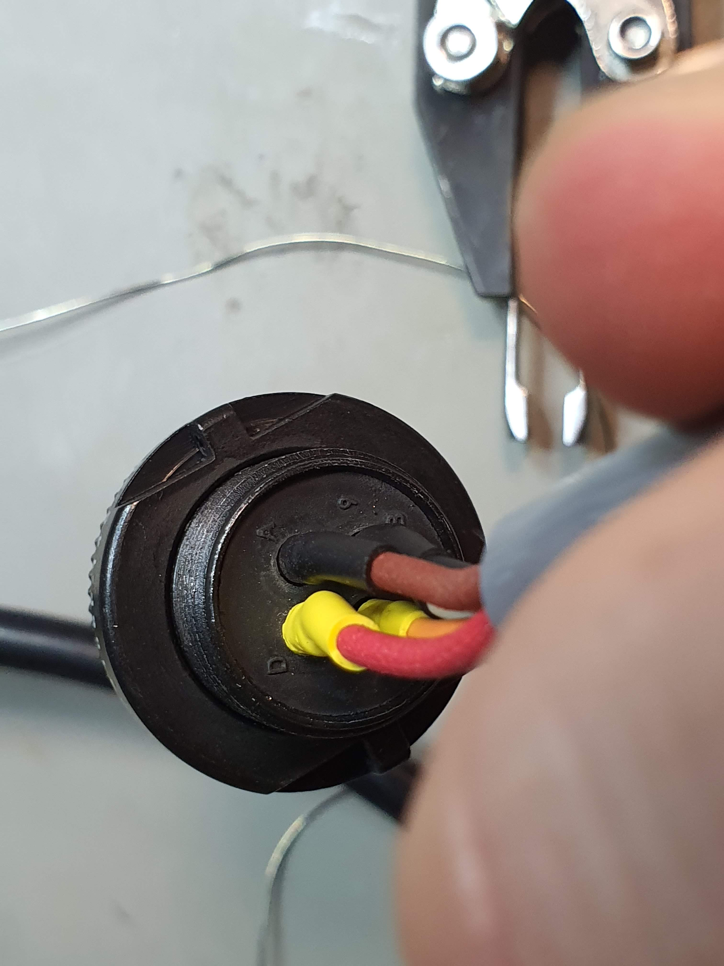
images/20190918_123612.jpg
