desertfireballnetwork/observatories_technical_wiki/images/20190918_124749.jpg

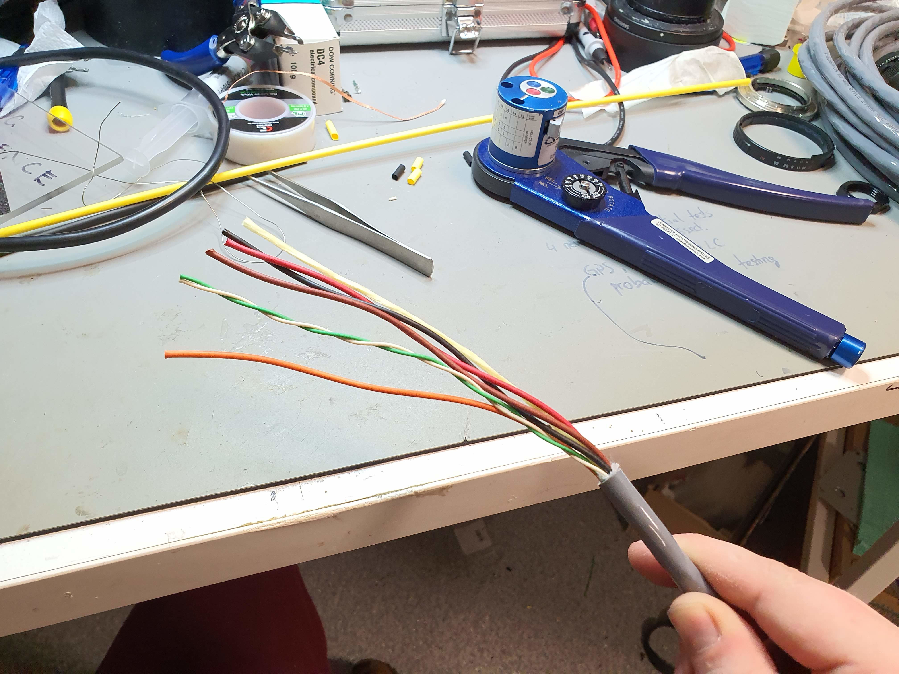
images/20190918_124749.jpg
