desertfireballnetwork/observatories_technical_wiki/images/20190918_140440.jpg

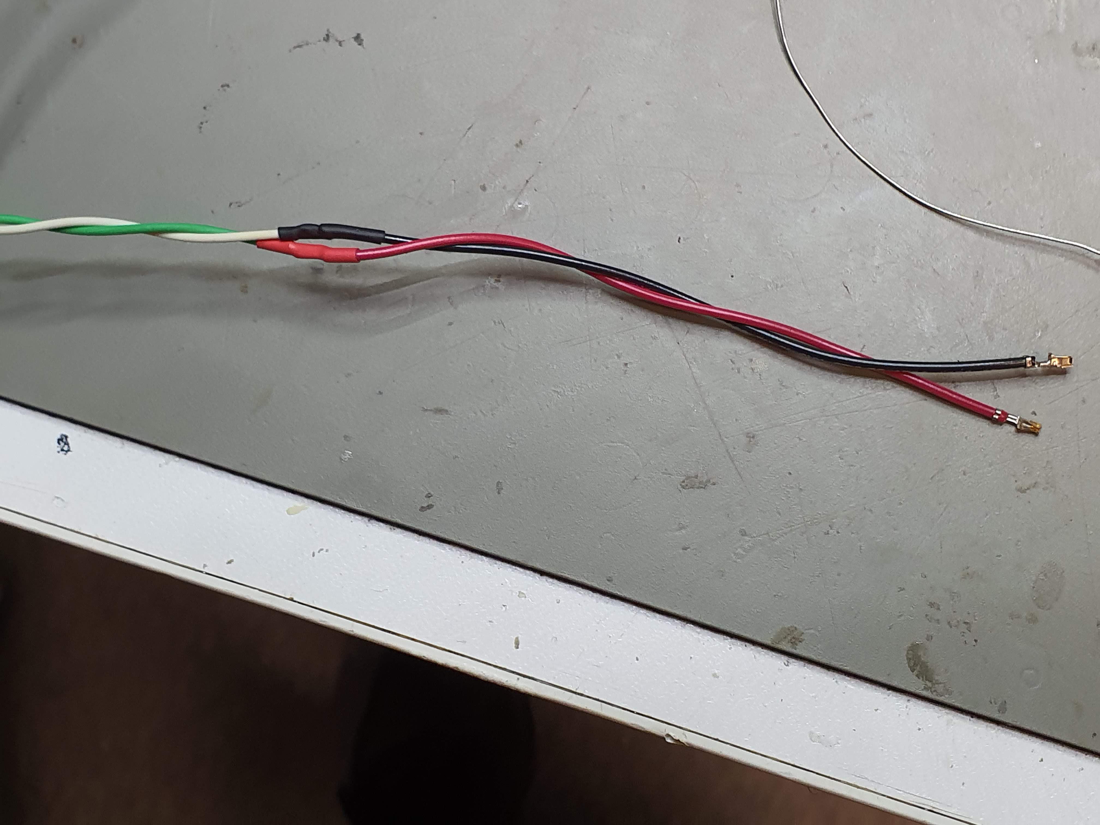
images/20190918_140440.jpg
