desertfireballnetwork/observatories_technical_wiki/images/20190918_140650.jpg

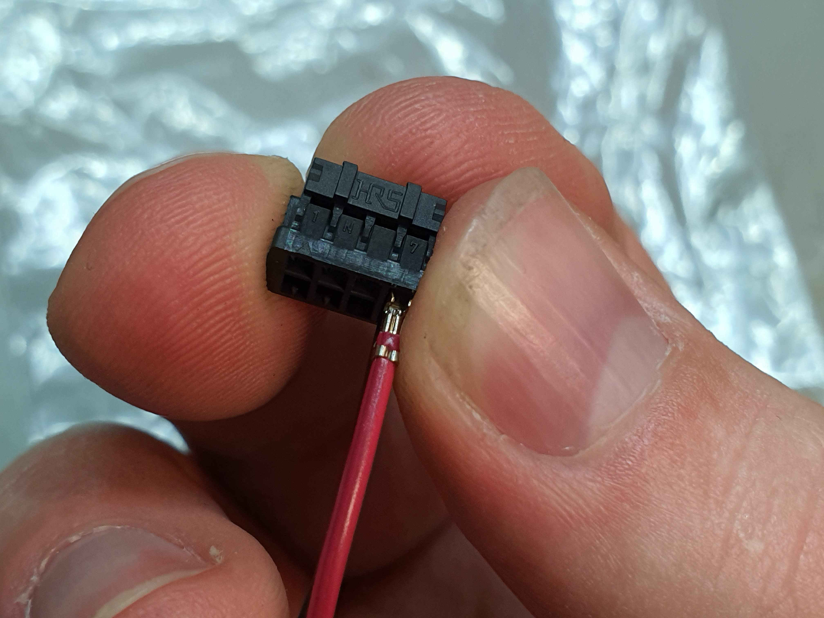
images/20190918_140650.jpg
