desertfireballnetwork/observatories_technical_wiki/images/20190918_140709.jpg

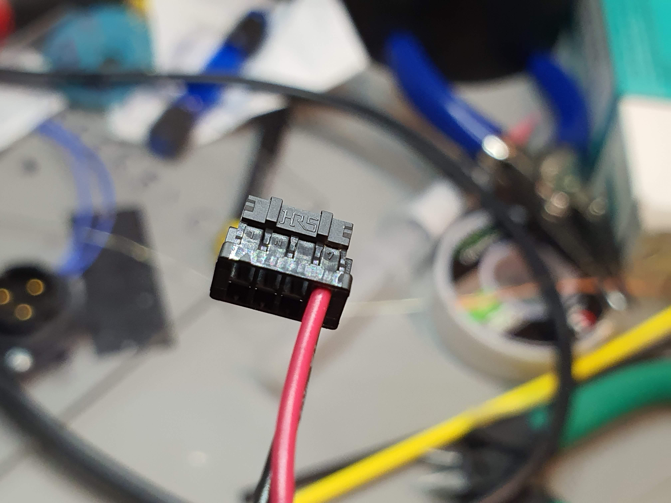
images/20190918_140709.jpg
