desertfireballnetwork/observatories_technical_wiki/images/20191018_143928_MountStromlo_1600.jpg

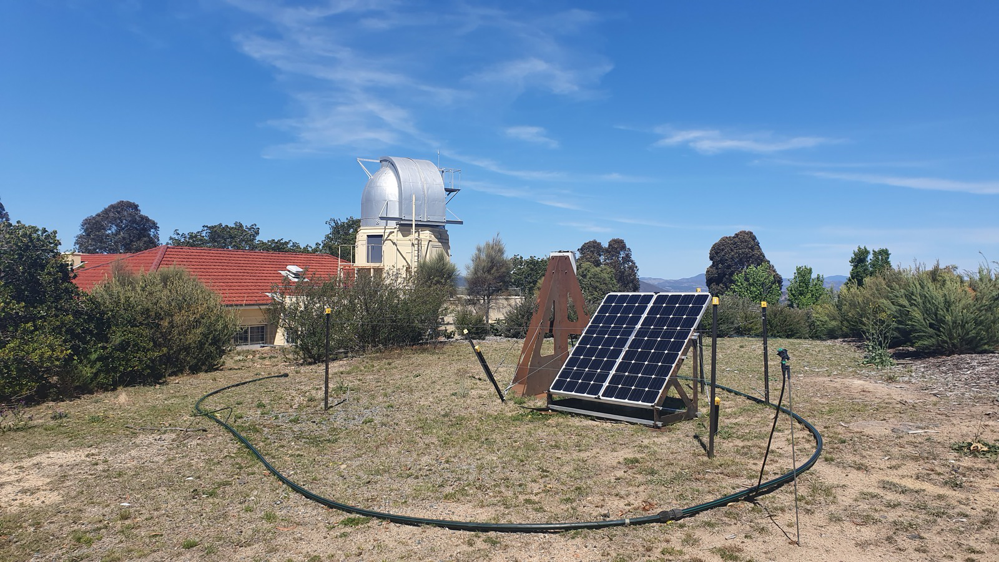
images/20191018_143928_MountStromlo_1600.jpg
