desertfireballnetwork/observatories_technical_wiki/images/Boorowa_1600.jpg

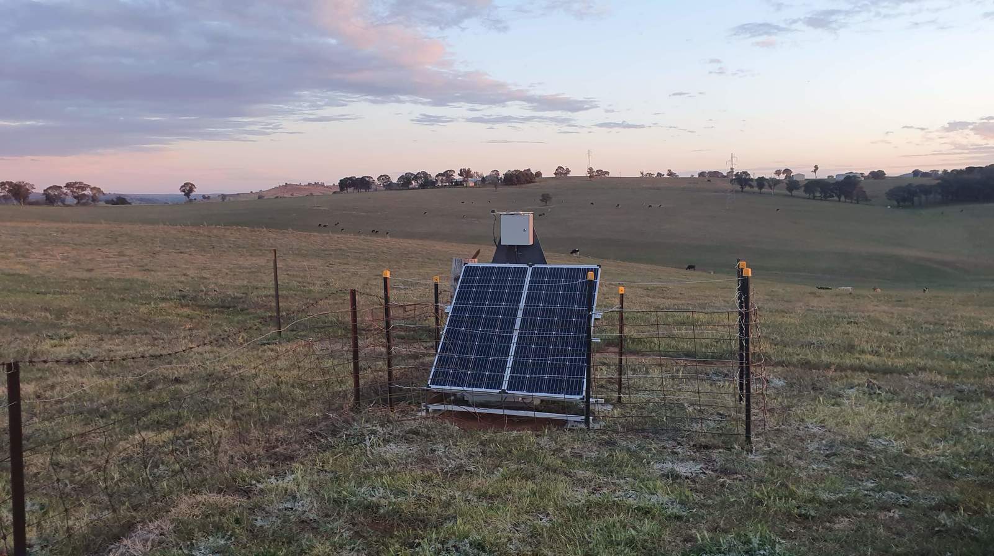
images/Boorowa_1600.jpg
