desertfireballnetwork/observatories_technical_wiki/images/Classic_GUI_Network_tab.png

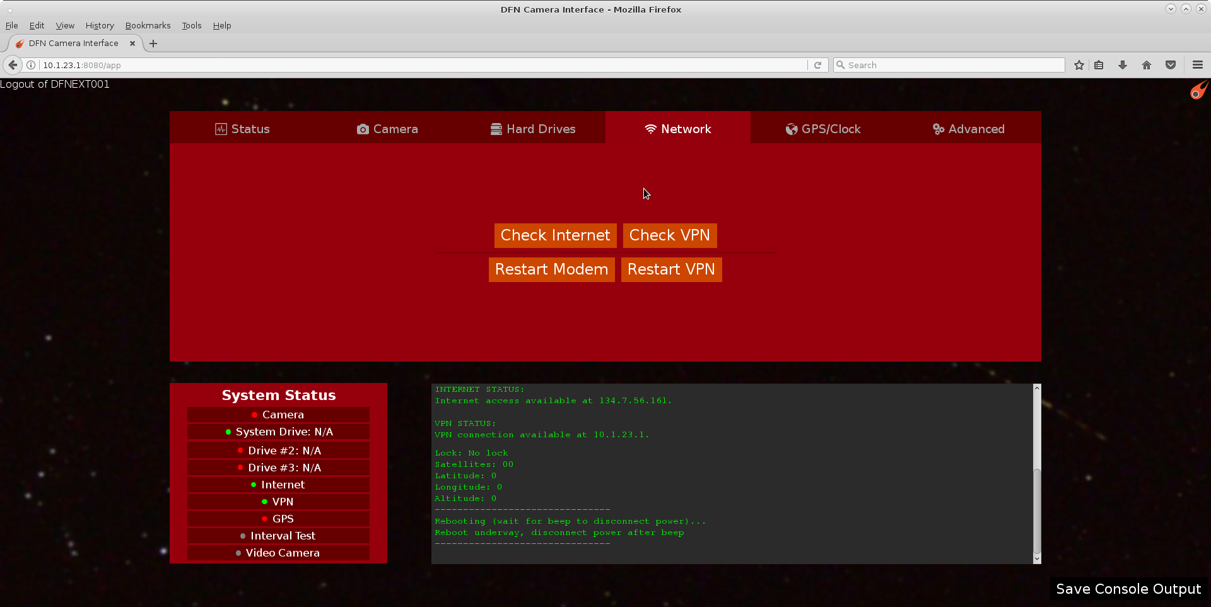
images/Classic_GUI_Network_tab.png
