desertfireballnetwork/observatories_technical_wiki/images/DFN_drone_Meteorite_detection_xsmall.png

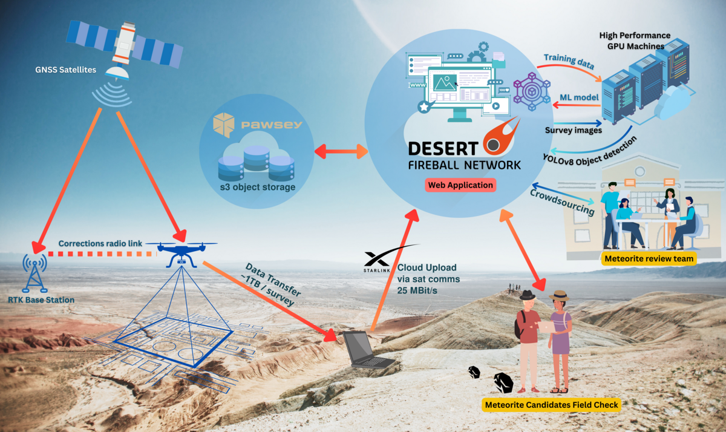
images/DFN_drone_Meteorite_detection_xsmall.png
