desertfireballnetwork/observatories_technical_wiki/images/DSC_9935_crop_MC_DFN_servicing_600.JPG

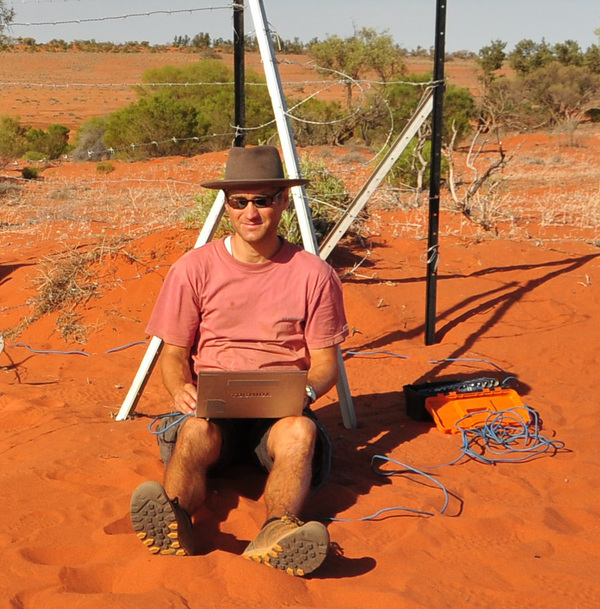
images/DSC_9935_crop_MC_DFN_servicing_600.JPG
