desertfireballnetwork/observatories_technical_wiki/images/DSD_2868_1200_Gabyon_camera.jpg

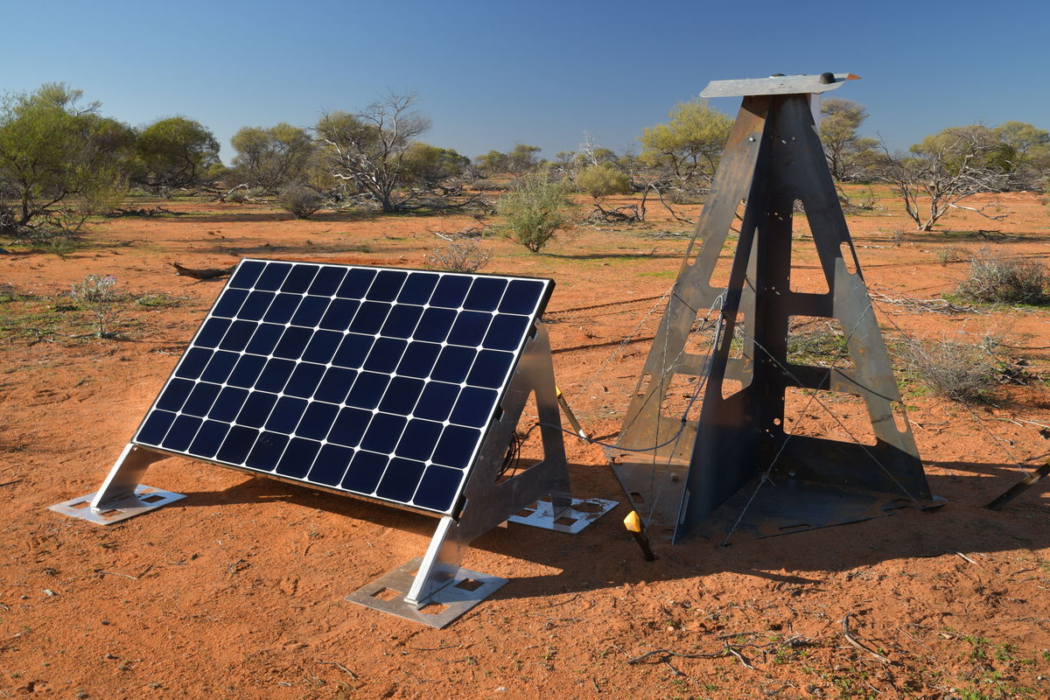
images/DSD_2868_1200_Gabyon_camera.jpg
