desertfireballnetwork/observatories_technical_wiki/images/Floor_mounted_camera_back.jpeg

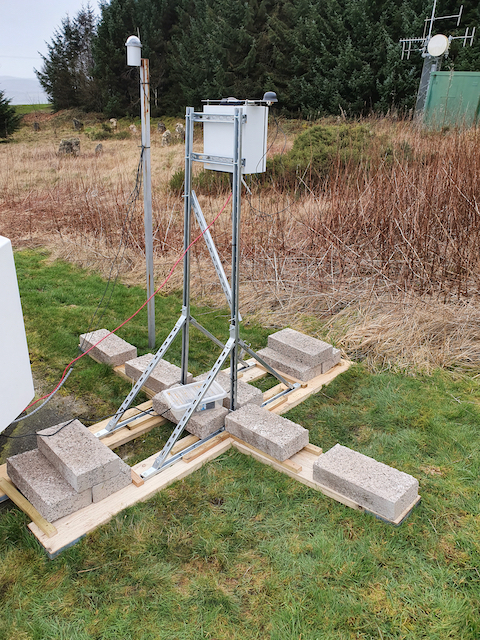
images/Floor_mounted_camera_back.jpeg
