desertfireballnetwork/observatories_technical_wiki/images/Floor_mounted_camera_front.jpeg

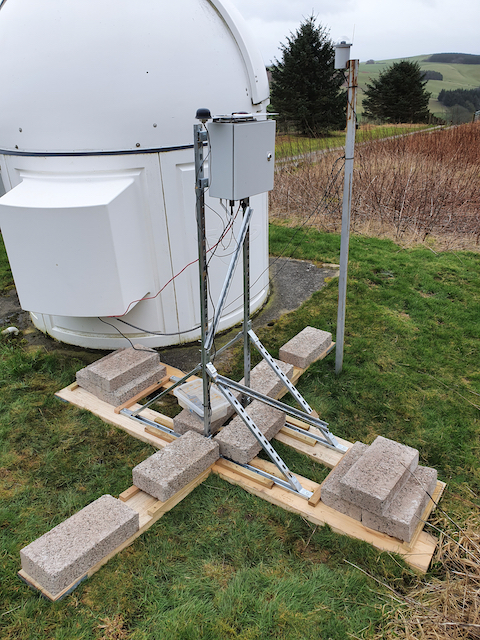
images/Floor_mounted_camera_front.jpeg
