desertfireballnetwork/observatories_technical_wiki/images/Goodlands_solar_powered_site_1200.JPG

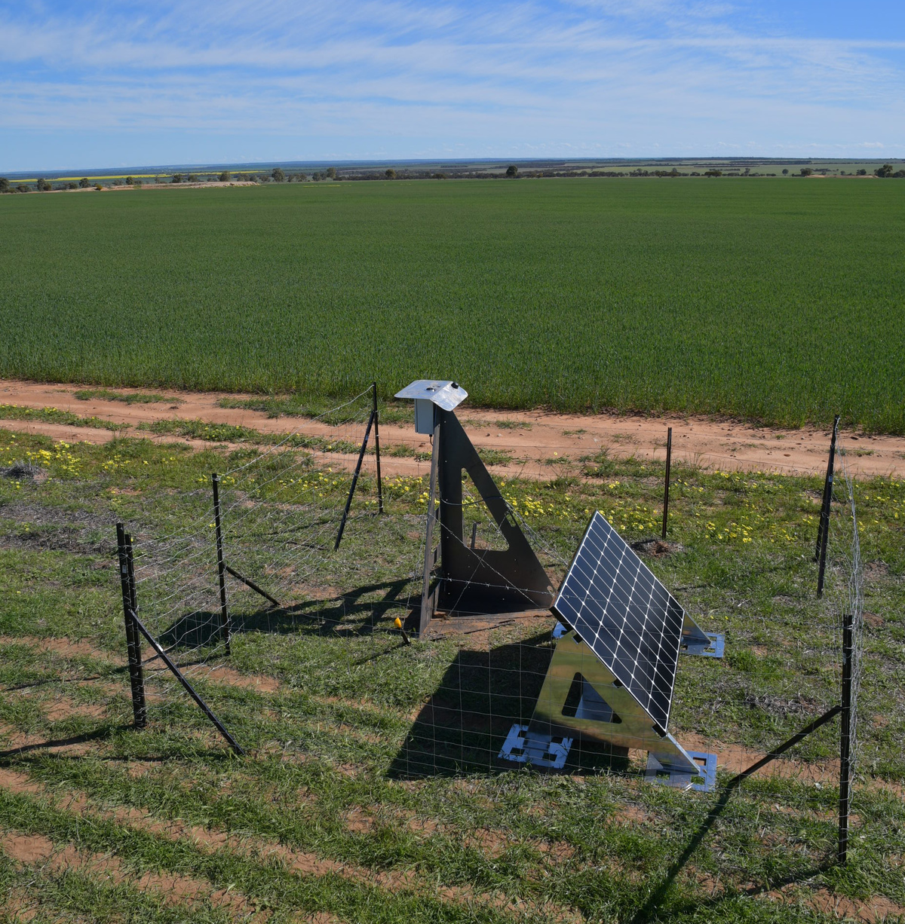
images/Goodlands_solar_powered_site_1200.JPG
