desertfireballnetwork/observatories_technical_wiki/images/Kataning_kit_camera.jpg

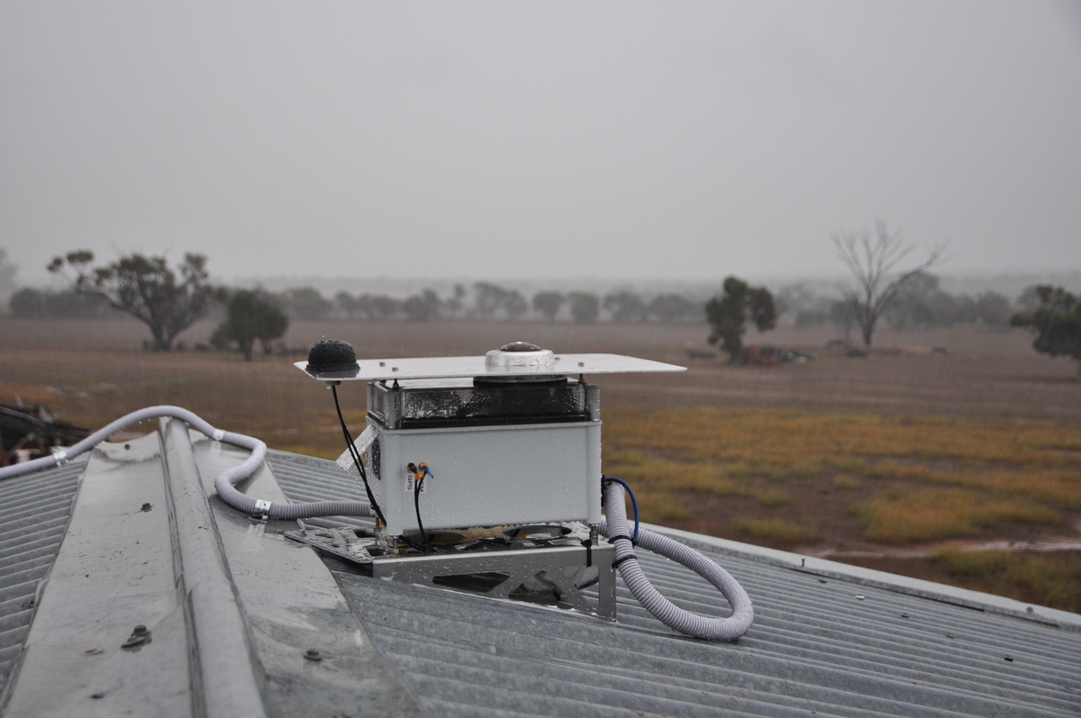
images/Kataning_kit_camera.jpg
