desertfireballnetwork/observatories_technical_wiki/images/PXL_20211116_205348092.jpg

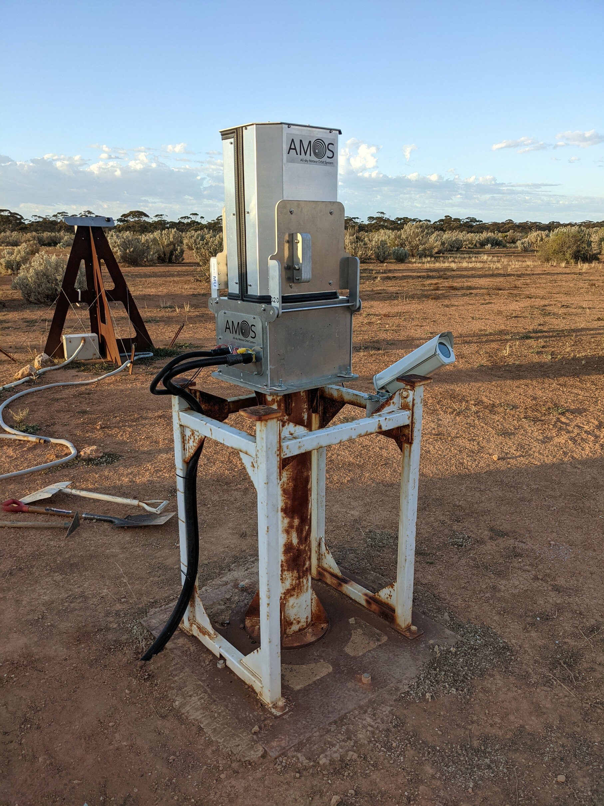
images/PXL_20211116_205348092.jpg
