desertfireballnetwork/observatories_technical_wiki/images/PXL_20211117_010305724.jpg

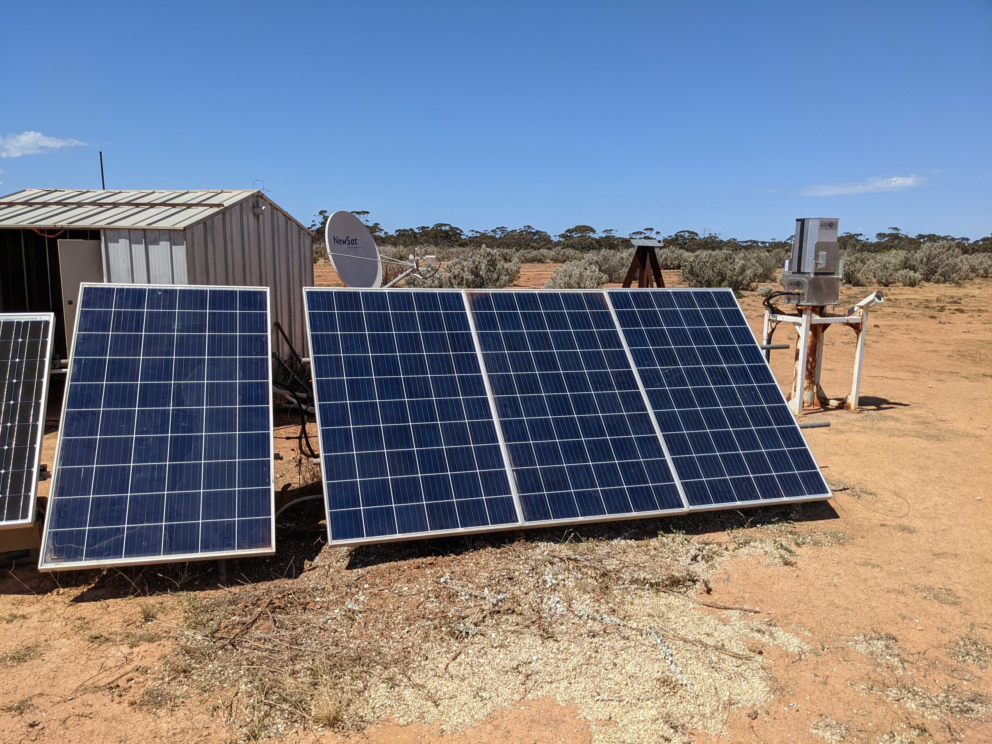
images/PXL_20211117_010305724.jpg
