desertfireballnetwork/observatories_technical_wiki/images/PXL_20211117_010518661.jpg

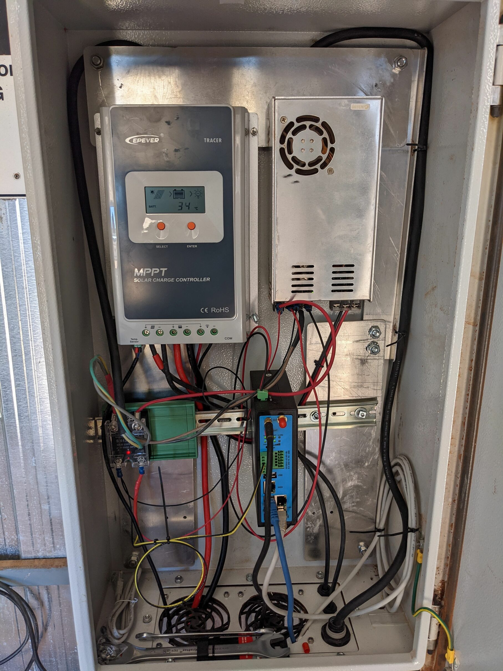
images/PXL_20211117_010518661.jpg
