desertfireballnetwork/observatories_technical_wiki/images/PXL_20211117_010525287.jpg

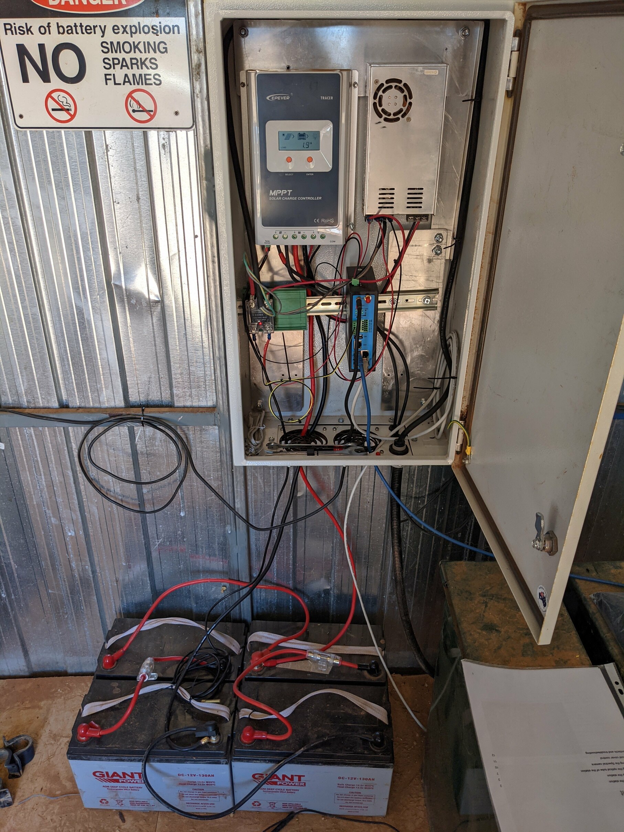
images/PXL_20211117_010525287.jpg
