desertfireballnetwork/observatories_technical_wiki/images/PXL_20211117_010557006.jpg

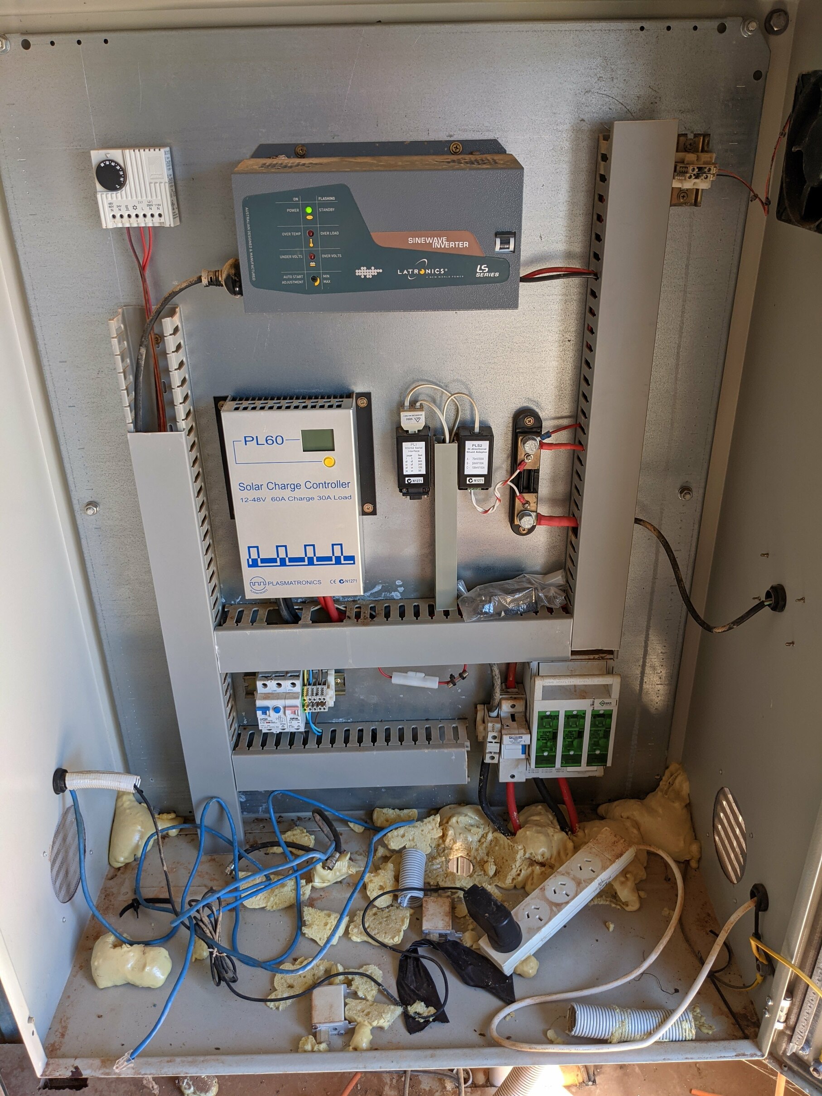
images/PXL_20211117_010557006.jpg
