desertfireballnetwork/observatories_technical_wiki/images/PXL_20211117_012333528.jpg

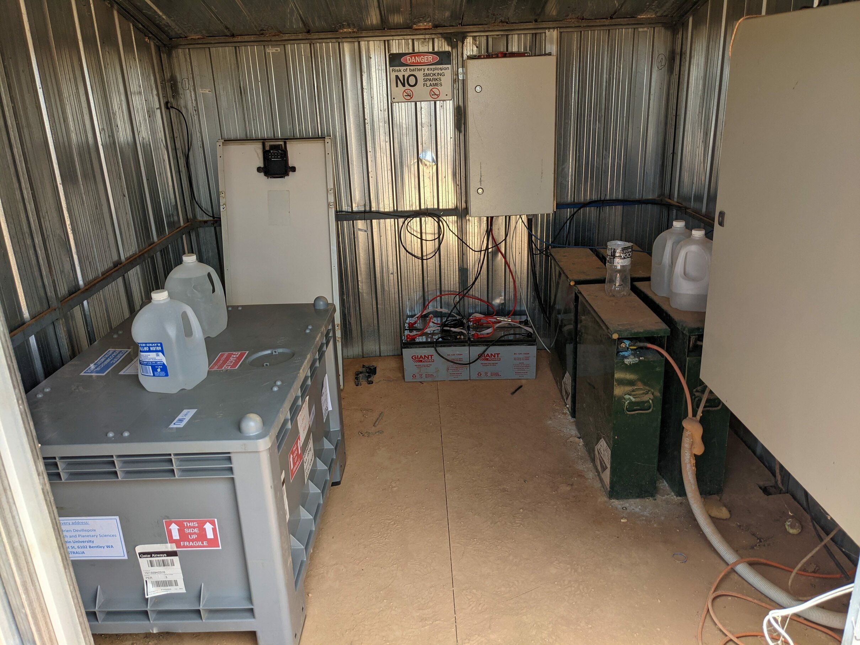
images/PXL_20211117_012333528.jpg
