desertfireballnetwork/observatories_technical_wiki/images/PXL_20211117_063816287.jpg

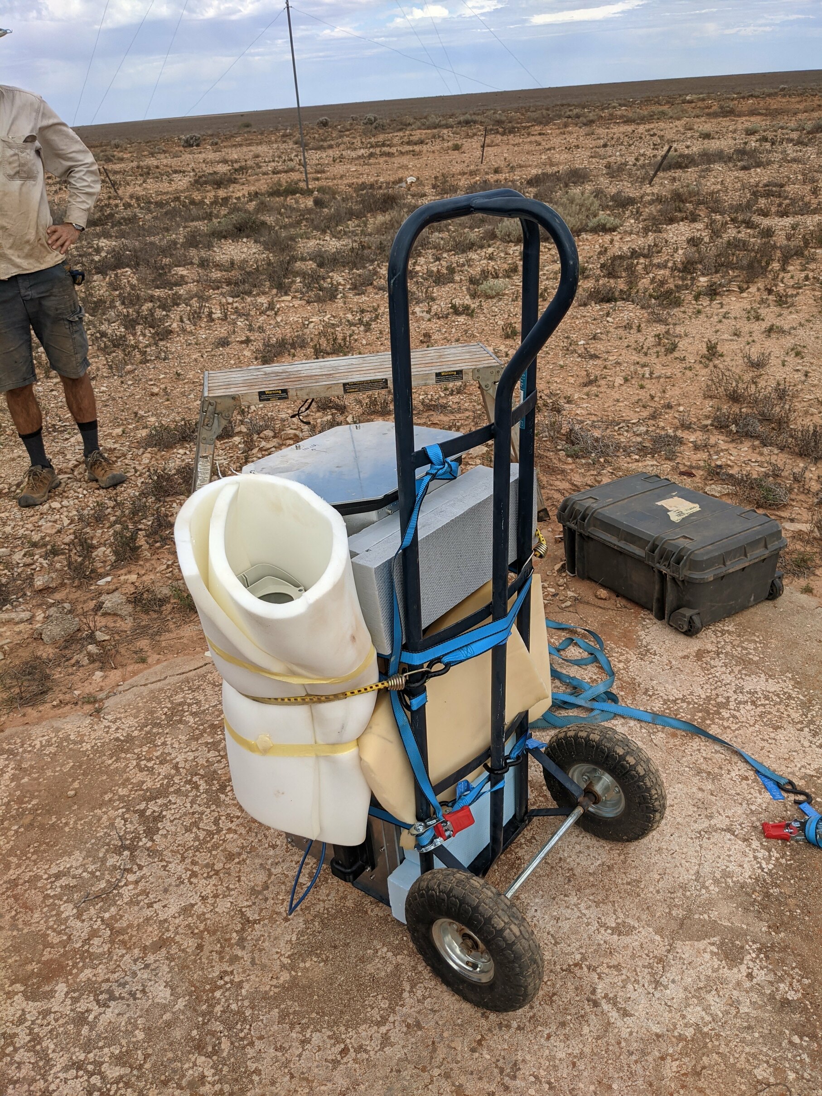
images/PXL_20211117_063816287.jpg
