desertfireballnetwork/observatories_technical_wiki/images/PXL_20211118_012640752.jpg

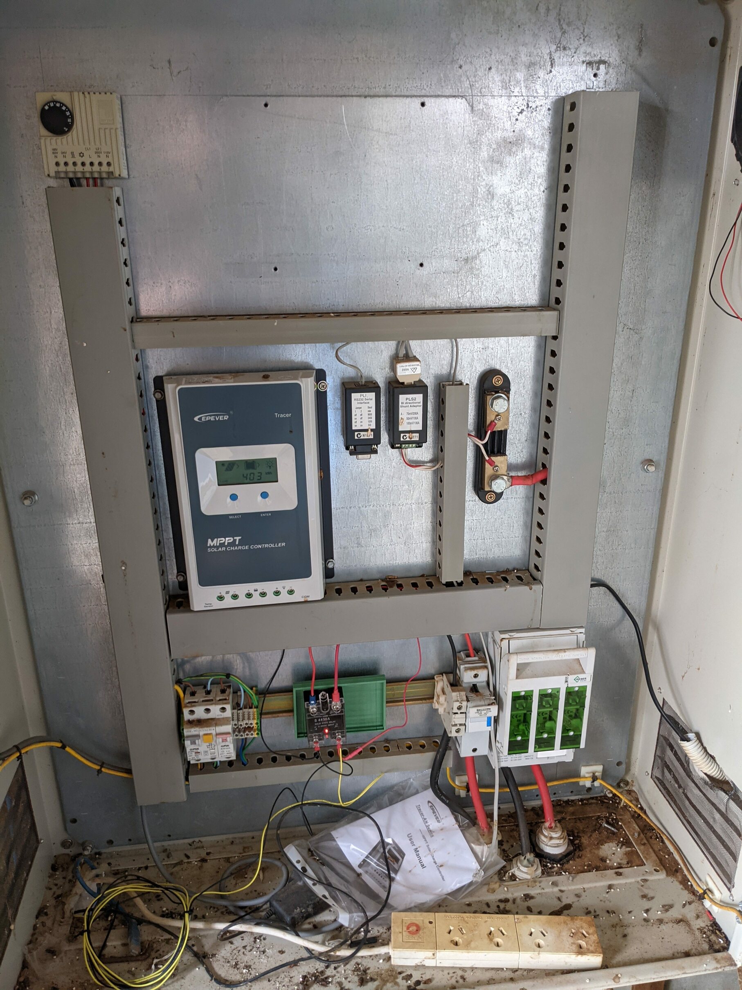
images/PXL_20211118_012640752.jpg
