desertfireballnetwork/observatories_technical_wiki/images/PXL_20211118_012704049.jpg

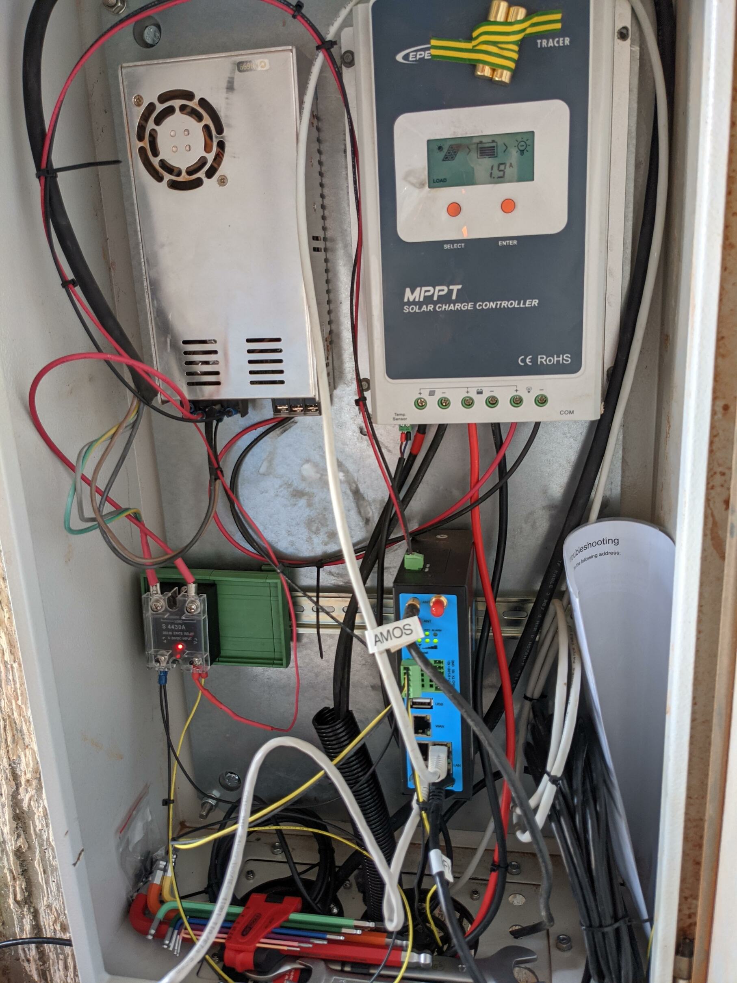
images/PXL_20211118_012704049.jpg
