desertfireballnetwork/observatories_technical_wiki/images/PXL_20211118_012719280.jpg

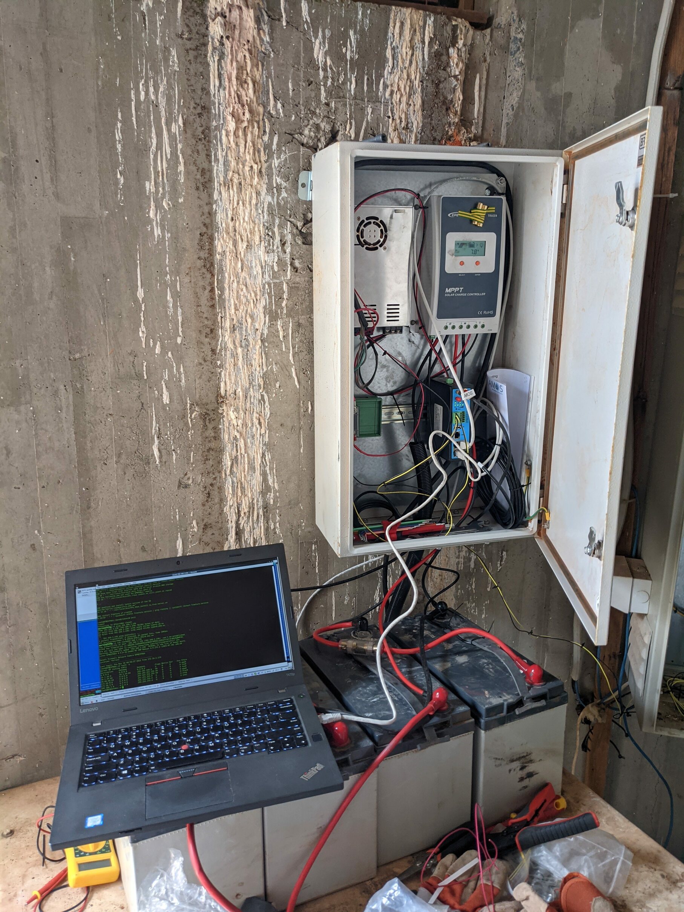
images/PXL_20211118_012719280.jpg
