desertfireballnetwork/observatories_technical_wiki/images/PXL_20211118_012738885.jpg

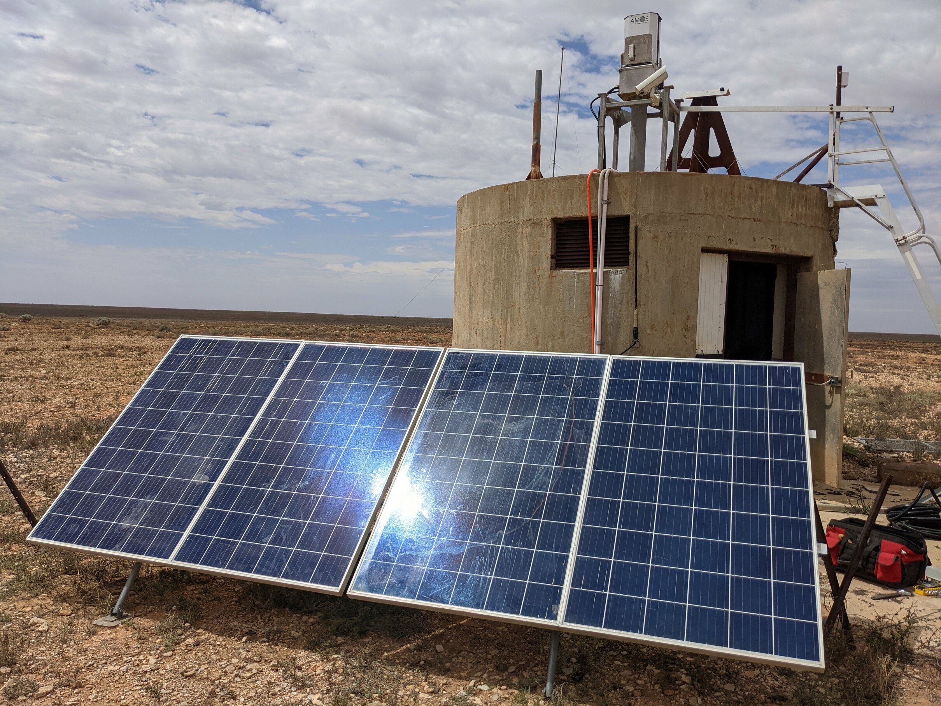
images/PXL_20211118_012738885.jpg
