desertfireballnetwork/observatories_technical_wiki/images/PXL_20211118_013016049.MP.jpg

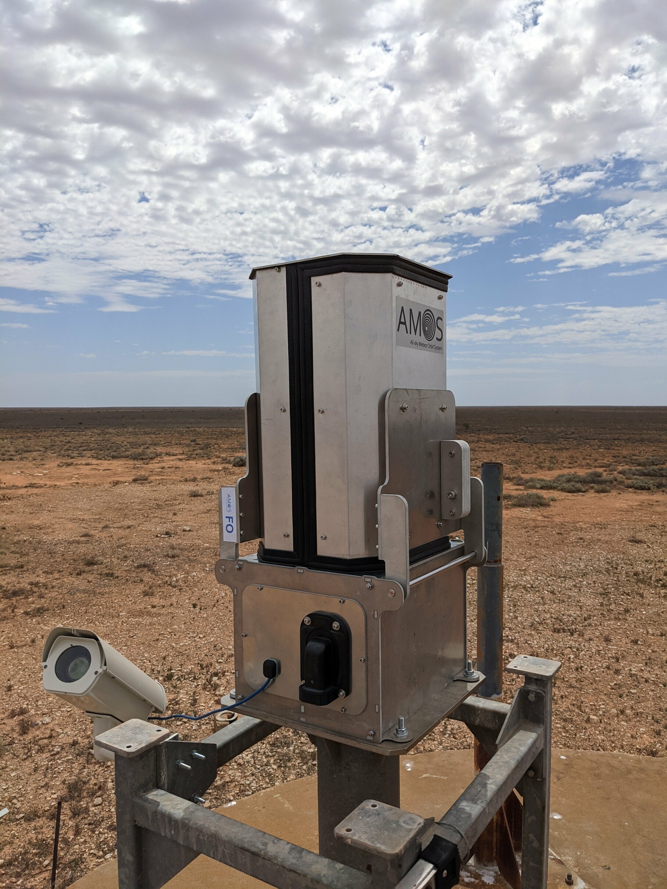
images/PXL_20211118_013016049.MP.jpg
