desertfireballnetwork/observatories_technical_wiki/images/PXL_20211118_013341701.jpg

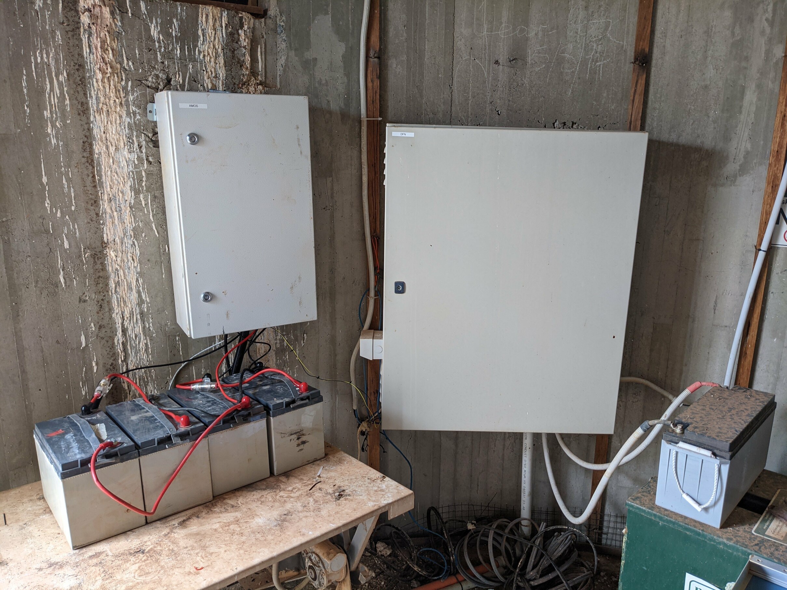
images/PXL_20211118_013341701.jpg
