desertfireballnetwork/observatories_technical_wiki/images/Roof_mount_made_from_shelving_bracket.jpg

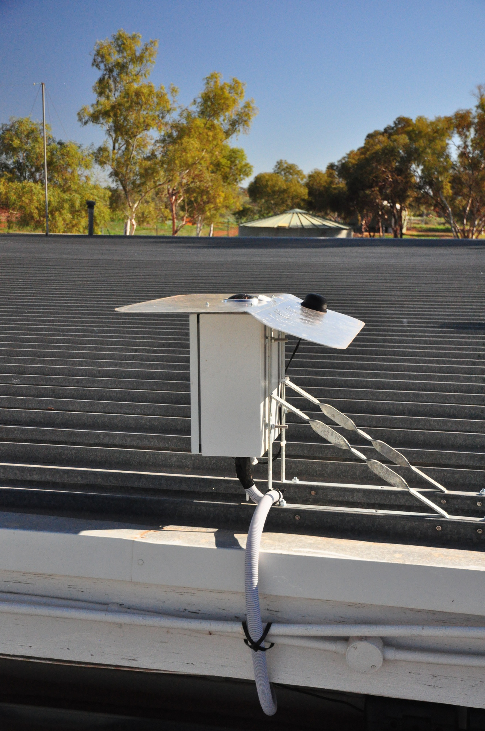
images/Roof_mount_made_from_shelving_bracket.jpg
