desertfireballnetwork/observatories_technical_wiki/images/Starlink_wifi_extender.jpg

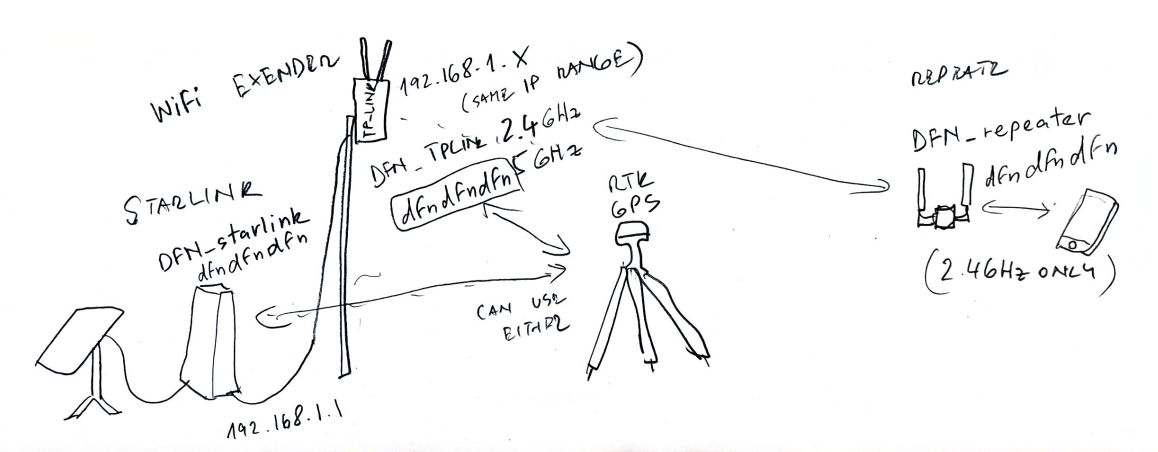
images/Starlink_wifi_extender.jpg
