desertfireballnetwork/observatories_technical_wiki/images/Dfnkit_sunshield.dxf

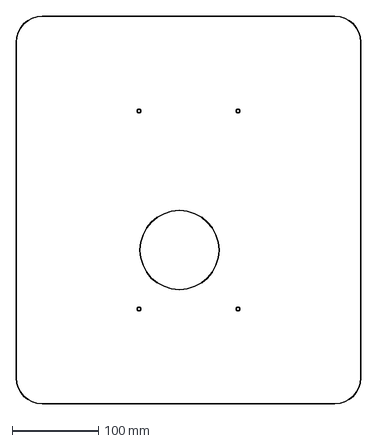
[picture p174: CAD file, 2026-04-02]
images/Dfnkit_sunshield.dxf
400.0 x 450.0 mm
