desertfireballnetwork/observatories_technical_wiki/images/Enclosure_roof_panel.dxf

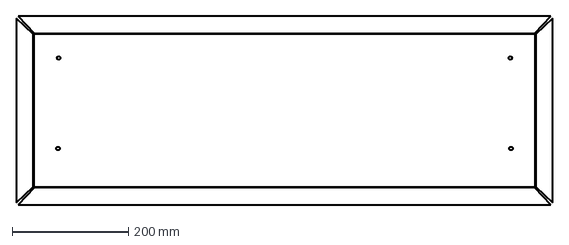
[picture p175: CAD file, 2026-04-02]
images/Enclosure_roof_panel.dxf
923.2 x 324.2 mm
