desertfireballnetwork/observatories_technical_wiki/images/PART_stand_base_MAT_5mm_mild_steel_QTY_1.dxf

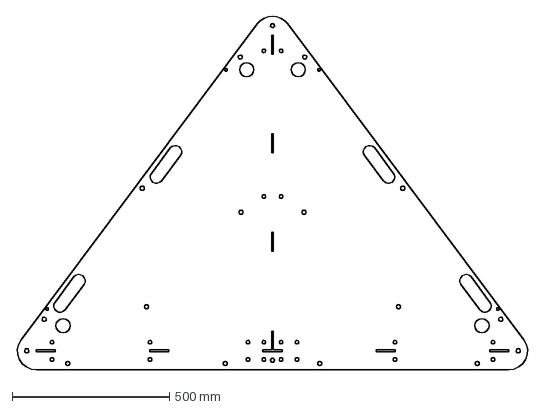
[picture p176: CAD file, 2026-04-02]
images/PART_stand_base_MAT_5mm_mild_steel_QTY_1.dxf
1627.6 x 1122.5 mm
