desertfireballnetwork/observatories_technical_wiki/images/Enclosure_right_panel.dxf

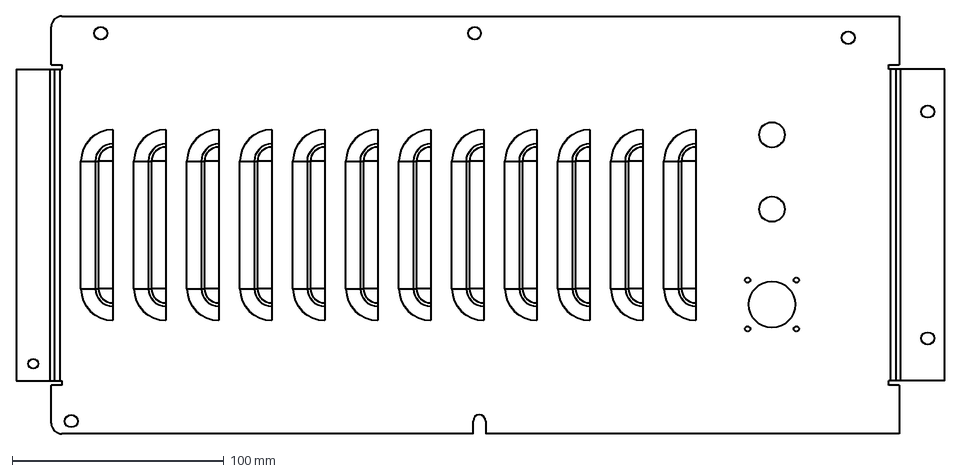
[picture p177: CAD file, 2026-04-02]
images/Enclosure_right_panel.dxf
438.0 x 197.0 mm
