desertfireballnetwork/observatories_technical_wiki/images/PART_solar_support_45d_MAT_5mm_mild_steel_QTY_2.dxf

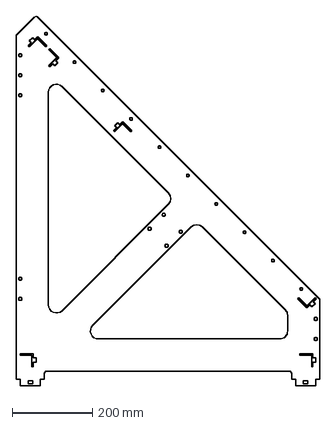
[picture p178: CAD file, 2026-04-02]
images/PART_solar_support_45d_MAT_5mm_mild_steel_QTY_2.dxf
756.6 x 922.2 mm
