desertfireballnetwork/observatories_technical_wiki/images/PART_solar_support_sand_shoe_MAT_5mm_mild_steel_QTY_4.dxf

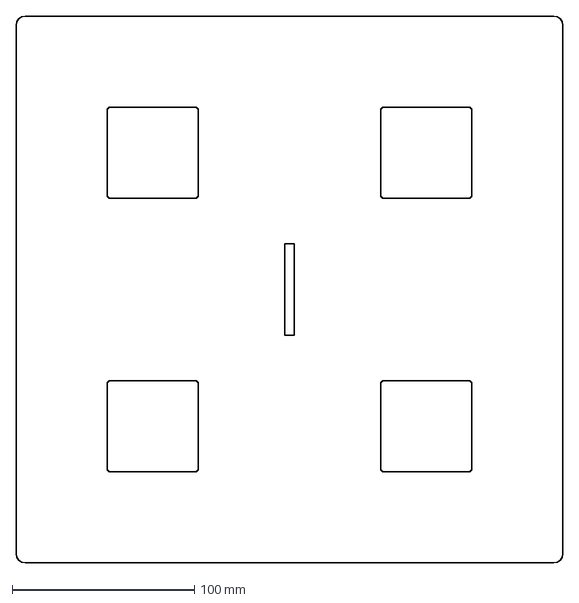
[picture p179: CAD file, 2026-04-02]
images/PART_solar_support_sand_shoe_MAT_5mm_mild_steel_QTY_4.dxf
300.0 x 300.0 mm
