desertfireballnetwork/observatories_technical_wiki/images/PART_wedge_MAT_10mm_mild_steel_QTY_30.dxf

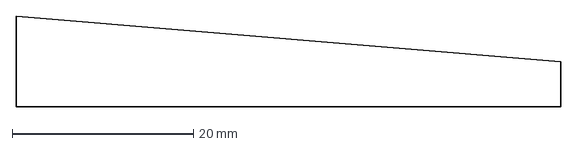
[picture p181: CAD file, 2026-04-02]
images/PART_wedge_MAT_10mm_mild_steel_QTY_30.dxf
60.0 x 10.0 mm
