desertfireballnetwork/observatories_technical_wiki/images/PART_stand_rib_MAT_5mm_mild_steel_QTY_1.dxf

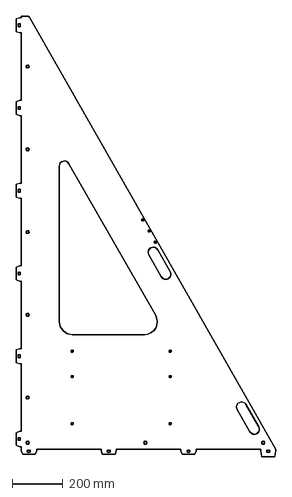
[picture p182: CAD file, 2026-04-02]
images/PART_stand_rib_MAT_5mm_mild_steel_QTY_1.dxf
1020.0 x 1730.0 mm
