desertfireballnetwork/observatories_technical_wiki/(list of files, cad)

Other CAD files:
images/PART_stand_base_MAT_5mm_mild_steel.dxf
images/PART_stand_back_MAT_5mm_mild_steel.dxf
images/PART_wedge_MAT_10mm_mild_steel.dxf
images/PART_15_degree_roof_mount_MAT_3mm_aluminium.dxf
images/PART_10_degree_roof_mount_MAT_3mm_aluminium.dxf
images/PART_flat_mount_MAT_3mm_aluminium.dxf
images/PART_20_degree_rib_and_pan_roof_mount_MAT_3mm_aluminium.dxf
images/PART_25_degree_roof_mount_MAT_3mm_aluminium.dxf
images/PART_30_degree_roof_mount_MAT_3mm_aluminium.dxf
images/PART_20_degree_roof_mount_MAT_3mm_aluminium.dxf
images/PART_35_degree_roof_mount_MAT_3mm_aluminium.dxf
images/PART_stand_rib_MAT_5mm_mild_steel.dxf
images/20170330_Sunshield_2mm_Al.dxf
images/20191218_large_dfnext_sunshield_2mm_aluminum.dxf
images/Flat_roof_mount.ipt
images/Roof_mount.ipt
images/Roof_mount_rib_and_pan.ipt
