desertfireballnetwork/observatories_technical_wiki/Getting_Started.md

---
title: "Getting Started"
nav_order: 2
---
The DFN observatories use a
[GNU/Linux](https://www.debian.org/releases/stable/amd64/ch01s02.html.en)
operating system ([Debian](https://www.debian.org/)) and can be fully
controlled through the [Linux
terminal](https://www.digitalocean.com/community/tutorials/an-introduction-to-the-linux-terminal)
either locally or remotely from anywhere in the world. Much of the
observatories' functionality is also accessible through a graphical [web
interface]({% link observatories/maintenance/Web_Interface.md %}) which can also be used locally or
remotely.

There is more than one type of DFN observatory; you can figure out what
type you have [here]({% link observatories/index.md %}). Most of the
instructions on this wiki will focus primarily on the latest
[DFNEXT]({% link observatories/dfnext/index.md %}) observatories as more of these have been
delivered to collaborators than the other types and this is the only
fireball observatory design still in production.

# Lens and DSLR installation

In order to prevent the issues with lenses being damaged and/or
de-focussed in transport, the DSLR body and Samyang lens are since
August 2018 shipped separately to the main box. That completely
eliminates the mechanical stress transferred from the packaging to the
DSLR/lens joint. On the other hand, that means the user will need to
install them in the [DFNEXT]({% link observatories/index.md %}) box upon
arrival.

Please follow
[these]({% link installations/How_to_install_flanged_Samyang_lens_and_DSLR_to_the_DFNEXT_enclosure.md %})
instructions: [How to install flanged Samyang lens and DSLR to the
DFNEXT
enclosure]({% link installations/How_to_install_flanged_Samyang_lens_and_DSLR_to_the_DFNEXT_enclosure.md %})

# Connecting Fireball Observatory to the Internet

DFN observatoties take images during night, store them on HDDs and run
event detection during day. In order to triangulate the luminous
trajectory and to be able to do further exciting calculations like
backtrace the trajectory to find out where the meteoroid came from,
whether it dropped meteorite and where it may be found, the event
detection data must be transferred to server. For this and other
operational reasons, it is highy desirable for the observatories to be
connected to the Internet.


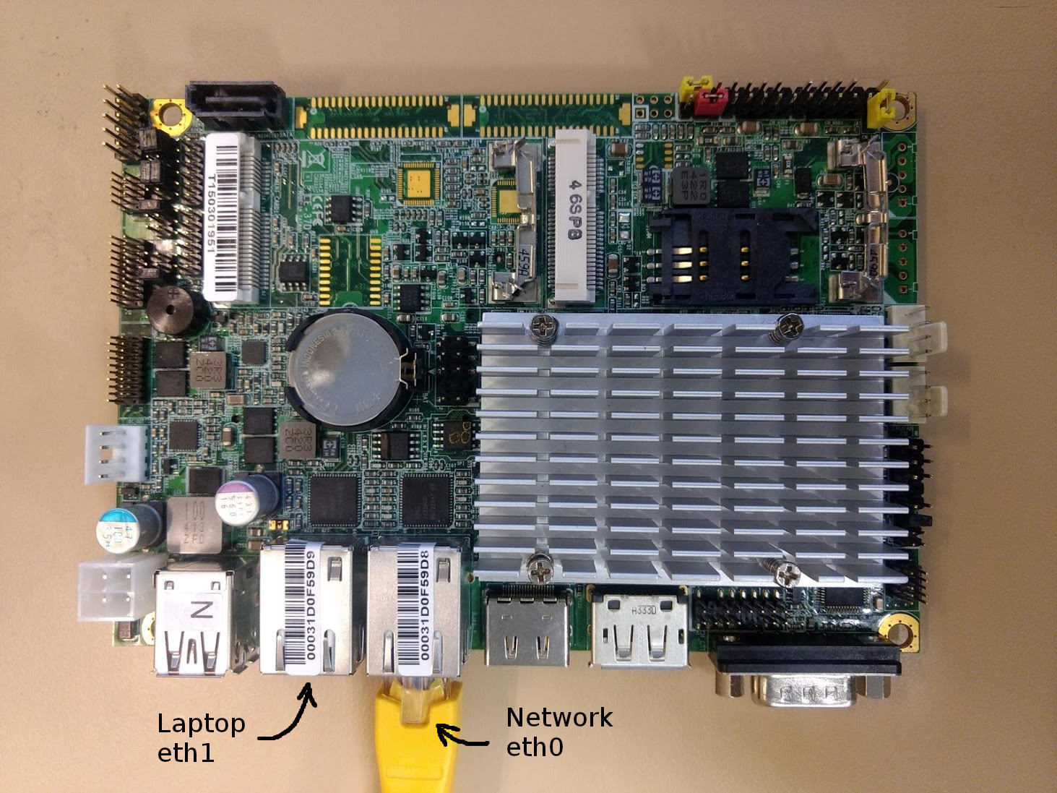
[picture p183: images/DFNSMALL_Commell_PC_eth_ports_marked.jpg]


## Ethernet port eth0

For network/internet connection, it is important to use the correct
port. In the default configuration as the DFN observatory box arrive
from us, the upper port eth1 (DFNEXT/DFNSMALL box oriented lenses up) is
for local connection with laptop during testing or on site, on this port
DHCP server is running and camera system assigns IP address to whatever
is connected to it. It is not good idea to connect this port to local
network eg in office or lab, because it may cause problems with other
computers and devices in the local network. The lower port (eth0) is
awaiting IP address to be assigned by DHCP server and this socket is the
one to connect camera to the Internet.

DFNEXT cameras come with stickers inside the door marking the ports, for
DFNSMALL cameras please refer to images.

The configuration of ethernet port eth0 can be modified in file
/etc/network/interfaces, for example in case there is no DHCP server
available in the local network and static IP and gateway needs to be set
up. Please refer to Debian documentation
[1](http://https://wiki.debian.org/NetworkConfiguration) or contact us
for help.

# Connecting to Your Fireball Observatory for the First Time


You will probably want to set your fireball camera up in your lab or
office before you install it. This will allow you to try logging in,
configuring the camera and running a test in a comfortable environment.

There are three ways to connect to the observatory depending on your
situation. These are:

- [locally via the network (ethernet or
  WiFi)]({% link network/Logging_in_locally_via_WiFi_or_Ethernet.md %})
  (**recommended initially**)
- [locally using a HDMI or VGA monitor and USB
  keyboard]({% link observatories/maintenance/Manual_Maintenance.md %}#direct-connection)
- [remotely over the
  VPN]({% link network/Logging_in_remotely_over_the_network.md %})

You have the choice of either using the terminal or the graphical [web
interface]({% link observatories/maintenance/Web_Interface.md %}) for all three of the above
connection scenarios. (Although logging in locally using a monitor and
keyboard is not recommended if you want to use the web interface.)

## Two Options for Controlling Your Observatory: the Terminal and the Web Interface

The Linux terminal is a powerful text based interface that can be used
to control the fireball observatories or any other Linux computer. Other
operating systems including BSD, Mac OS X, Windows, Android and iOS can
also be controlled from a terminal; however, levels of support vary.

If you are only familiar with graphical user interfaces such as the
[Windows Shell](https://en.wikipedia.org/wiki/Windows_shell) or [Mac OS X
Aqua](https://en.wikipedia.org/wiki/Aqua_(user_interface) "wikilink") it may initially be
hard to see the appeal of the terminal, as the command line is a
fundamentally different way of interacting with your computer. However,
some of the advantages are that:

- commands can be executed on remote computers as easily as on your
  local computer (even over poor connections),
- the interface is a very fast way of getting things done once you know
  what you're doing,
- multiple commands can be used together to do quite fancy things and
- it is easier and less time consuming to create command line
  interface (CLI) programs than it is to create graphical user interface
  (GUI) programs.

DFN observatories can be fully controlled through the terminal; however,
most functionality (including all common operations) is also now
available through the [graphical web
interface]({% link observatories/maintenance/Web_Interface.md %}). This interface is useful for users
who prefer graphical interfaces, users on mobile devices and for quickly
accomplishing small tasks such as turning the drives on and off.

**TODO: finish tidying up this page**

There are a few things you might want to set up on your local machine to
make your life easier:

- [Setting up an SSH key]({% link network/SSH_Keys.md %}) for the terminal
  connection
- [Editing your hosts file]({% link network/Hosts_File.md %})

We currently have three different fireball observatory designs; see
[Which camera]({% link observatories/index.md %}) do I have?

In order to check that the camera survived the transport and before
deploying, we recommend to do a few basic configurations, then you can
run a couple of tests (see [Configuring the
Software]({% link observatories/maintenance/Configuring_the_Software.md %}))

# Selecting an Appropriate Site for Deployment

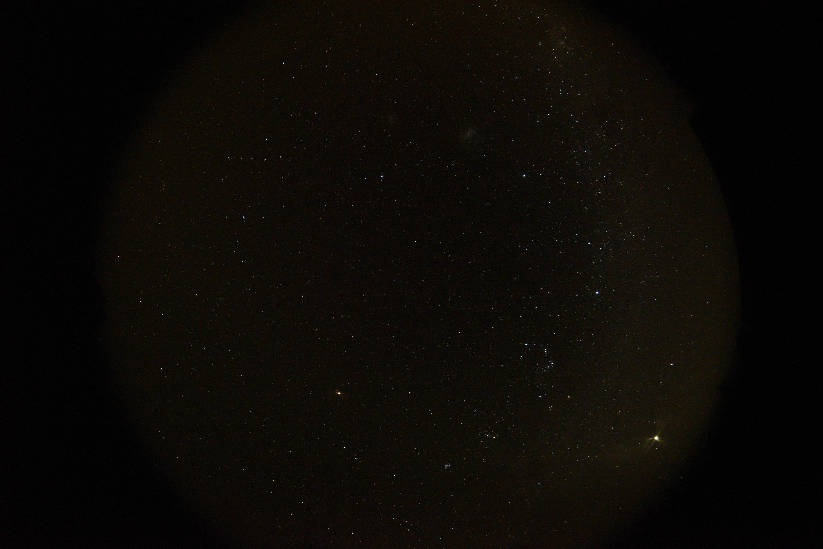
[picture p184: images/Perfect_calibration_image_Gabyon.jpg]

Easy is better than hard, you are not scouting for a site to put the
next 10 metre class telescope! However those simple principles help
ensure maximum science returns from the cameras:

- **Light Pollution**: The amount of light pollution in an area
  generally depends on its vicinity to towns or cities, and can affect
  the quality of the night sky images substantially. We recommend taking
  a look at <http://darksitefinder.com/maps/world.html> to assess your
  proposed area for its level of light pollution. No worse than green as
  a rule of thumb, but the darker the better.
- **Camera Spacing**: If you are installing more than one camera or have
  existing cameras installed in your area, then you will need to space
  these units between 80km and 150km apart to optimise both network
  coverage and triangulability. Spacing in outback Australia is
  typically 100-150 km, for more light polluted areas 80-100 km is best.
- **Minimise Ocean Coverage**: The primary goal of the DFN is to recover
  meteorites with orbits. This is much harder to accomplish if the
  meteorite lands in the water. So to make the best use of our camera's
  coverage, we advise placing the camera unit at least 50km away from
  the coastline if possible.
- **Reasonably Accessible**: Occasionally these camera units need
  maintenance and servicing to ensure they are fully operational, such
  as changing the hard-drives and cleaning the lenses. Therefore, we
  would advise locating it within easy car access. This can include
  farmland (with owners permission of course) or off-road to avoid
  interference from car headlights and potential vandalism.
- **Internet connection**: the camera boxes come with **ethernet** ports
  and **WiFi**, they don't require a fast internet connection. When land
  internet is not available or too complicated to organise, the
  **3G/4G** mobile network modem can be used with a SIM card, check the
  coverage of local GSM providers. In Australia see the [Telstra
  coverage
  map](https://www.telstra.com.au/coverage-networks/our-coverage) or the
  [Optus coverage
  map](http://www.optus.com.au/shop/mobile/network/coverage). The GPS/3G
  external antenna that comes with the camera is usually enough to get a
  good signal in the light orange areas on the Telstra map ("3G external
  antenna"), a larger antenna can extend the coverage even further.
- **Horizon Views**: Ideally, a location with uninterrupted view of the
  whole horizon is preferred. This means avoiding areas in valleys, near
  man-made structures, or with an abundance of trees.
- **Roof versus ground setup**: a [roof
  setup]({% link installations/Rooftop_Fireball_Camera_Installation.md %}) seems easy and
  convenient, but can actually take more time to set up than a [ground
  setup]({% link installations/Standalone_Fireball_Camera_Installation.md %}) and
  sometime be an issue regarding health and safety (working on the roof)
  and reliability of mains power at some sites.

# Deploying Your Fireball Observatory

#### Physical Installation

Fireball observatories need to be securely mounted; movement will
degrade data quality. They also require reliable power and internet
connections. This is recommended [minimal
toolkit]({% link observatories/maintenance/Camera_Maintenance_Toolkit.md %}). This is a
[comprehensive servicing]({% link observatories/maintenance/Camera_servicing_kit.md %}) kit we use on
field trips in Australia.

[Servicing and deployment
checklists]({% link observatories/maintenance/index.md %}#servicing-and-deployment-checklists) -
printable PDF sheets to go through on the remote site

[Rooftop Fireball Camera
Installation]({% link installations/Rooftop_Fireball_Camera_Installation.md %}) (valid
for DFNSMALL and DFNEXT)

[Standalone Fireball Camera
Installation]({% link installations/Standalone_Fireball_Camera_Installation.md %})

[Rooftop Kit Camera
Installation]({% link installations/Rooftop_Kit_Camera_Installation.md %}) (if your
fireball camera has a clear top and only one lens - DFNKIT)

Make your own DFNEXT/DFNSMALL DC power cable using these instructions
![DFNEXT_DC_Power_Cable_Assembly.pdf]({{ site.baseurl }}/images/DFNEXT_DC_Power_Cable_Assembly.pdf) File:DFNEXT_DC_Power_Cable_Assembly.pdf.
Useful for solar powered (~12V) sites or in case when custom/specific
AC/DC power supply is used.

#### Software Configuration

[Configuring the Software]({% link observatories/maintenance/Configuring_the_Software.md %})

[Calibrating the camera
orientation]({% link observatories/maintenance/Calibrating_the_camera_orientation.md %})

[Creating a Mask]({% link data-processing/Creating_a_Mask.md %}) to remove non-sky regions
of the image

#### Internet access

[Finding network interface MAC
address]({% link network/Finding_network_interface_MAC_address.md %})

[Mobile network - 3G, 4G]({% link network/Mobile_network_-_3G,_4G.md %})

[WiFi configuration]({% link network/WiFi_configuration.md %})

# Checking Images

Point to downloading images...
