desertfireballnetwork/observatories_technical_wiki/Cameras_howto.md

## How to...

Login to camera using ssh terminal Test camera in the lab Test camera in
the field (outdoors)
