desertfireballnetwork/observatories_technical_wiki/Photos_of_Fireball_Camera_Installations.md

Just drag and drop your photos onto this page and we will organise them!
(or you can add them to the gallery below yourself it you want to)

## Roof-top installations in Australia - DFNSMALL, DFNEXT

<File:DSC> 1496 Hyden camera 1200.JPG\| <File:DSC> 1485 Hyden camera
1200.JPG\| <File:Top> down view of roof mount.jpg\| <File:Rooftop> mount
with modular aluminium frame.jpg\| <File:Yalgoo> rooftop camera
wide.jpg\| <File:Shelving> bracket roof mount.jpg\| <File:Rooftop>
camera.jpg\|

## Grid powered installations in Morocco - DFNEXT

<File:IMG> 5087 Agoudal DFNEXT 1600.jpg\| <File:IMG> 5373 Ozoud DFNEXT
1600.jpg\| <File:IMG> 5377 Ozoud DFNEXT 1600.jpg\|

<center>

Photos courtesy of Moroccan Observatory for Fireball Detections (MOFID)

</center>

## Installations in Canada

<File:Vermilion> DFNEXT IMG 1358 crop1200.jpg\|
<File:Mattheis_Ranch_Fireball_Camera.jpg>\| <File:20190725_160927.jpg>\|

Photo courtesy of Rob Baron, Lakeland College (the most left image) and
Patrick Hill, University of Alberta (the two on the right).

## Installations in Arizona

<File:Chiricahua> Astronomy Complex Fireball Camera.jpg\| <File:Flat>
roof frame.jpg\| <File:Indoor_power_supply.jpg>\|

## Installations in the UK

<File:20191027_UK_Newby_Hall.jpg>\| <File:20191028_UK_Galloway.jpg>\|
<File:B0B07CCD_UK_MRAO_Cambridge.jpg>\|

<center>

Photos courtesy of Dr. Luke Daly, UKFN

</center>

## Standalone solar powered installations in Australia - DFNSMALL, DFNEXT

<File:DaysHill_camera_1200.JPG>\| <File:Weekeroo.jpg>\| <File:Mt> Ive
DSC 4688 1600.JPG\| <File:Nilpena_camera_1200.JPG>\|
<File:Moolawatana_camera_1200.JPG>\| <File:Sm_DSC_2024.JPG>\|
<File:Ingomar_camera_1200.JPG>\| <File:BillaKalina_camera_1200.JPG>\|
<File:Billa> Kalina DFNSMALL DSC 4279 1600.JPG\| <File:Newdegate>
standalone solar install.jpg\|

## Standalone solar powered installations in the Kingdom of Saudi Arabia

<File:DFNEXT13> KSA.jpg\|

<center>

Photo courtesy of KACST.

</center>
