desertfireballnetwork/observatories_technical_wiki/Power_System_Wiring.md

overview of power system wiring for standalone solar system ===

wiring ===

solar charge controller settings === Victron Settings

Victron MPPT charging controller settings for the new DFN camera power
system - connect with Victron phone/tablet app via bluetooth.

<figure>
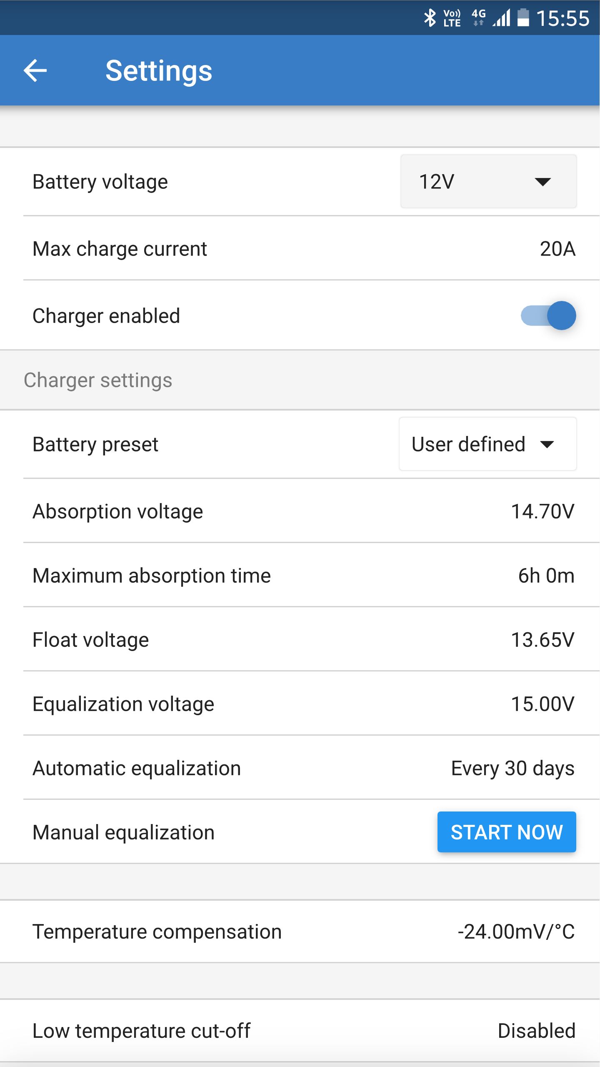
[picture p224: images/Victron_settings.jpg]

<figcaption>Victron_settings.jpg</figcaption>
</figure>
