desertfireballnetwork/observatories_technical_wiki/images/UHF_receiver_operation_manual.pdf

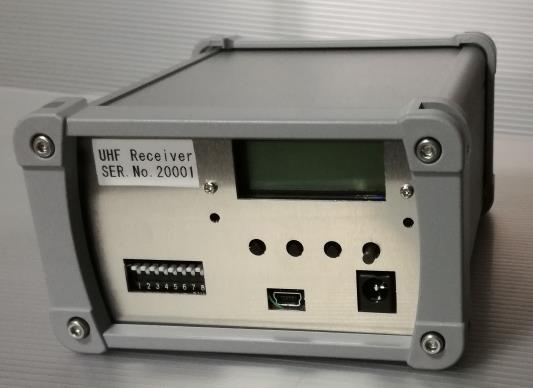
[picture p247: figure]

2020.10.31 K.fukai

# UHF receiver operation manual

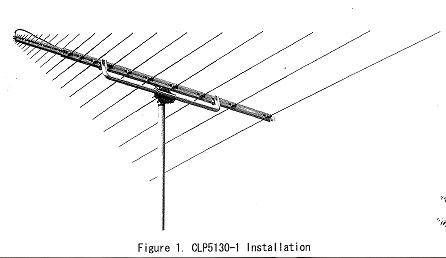
[picture p248: figure]

# Device connection diagram

LOG periodic antenna

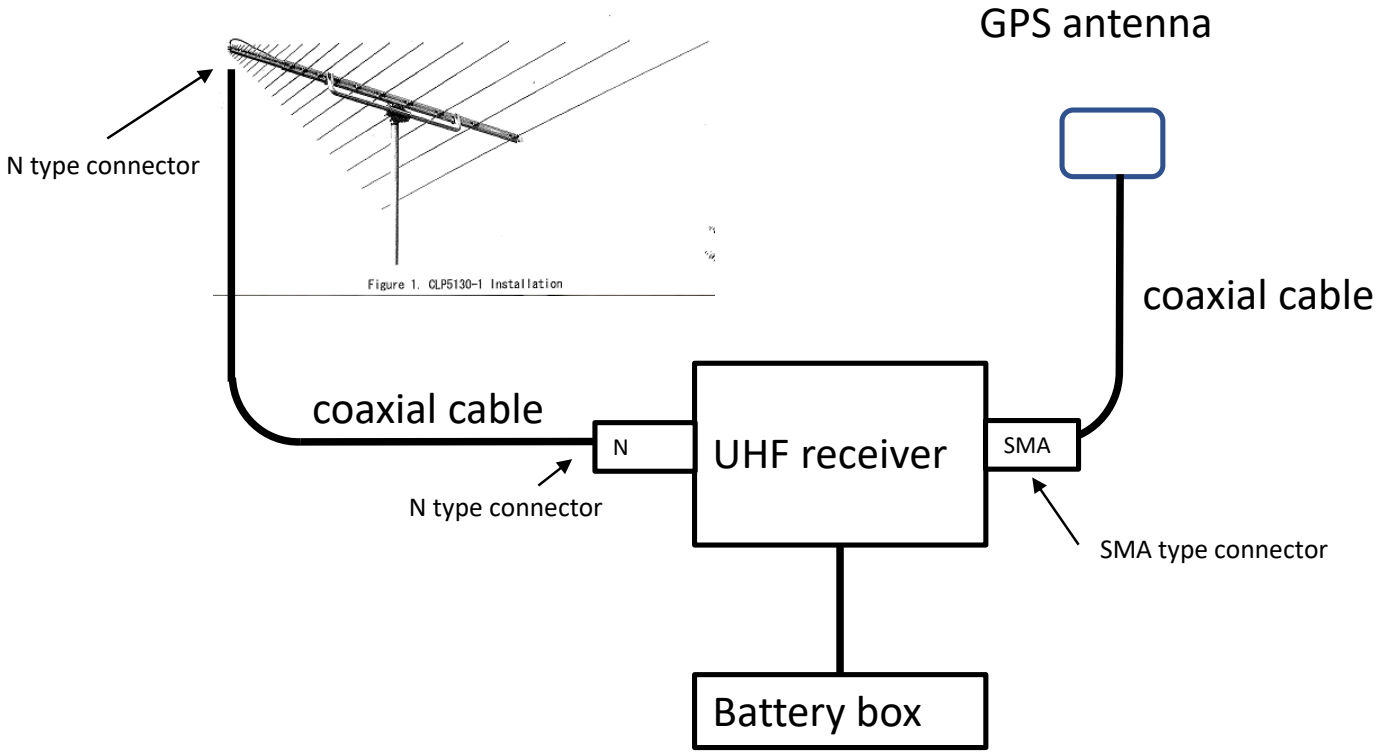
[picture p249: figure]
Battery box; GPS antenna; UHF receiver; coaxial cable; SMA type connector; N type connector; SMA

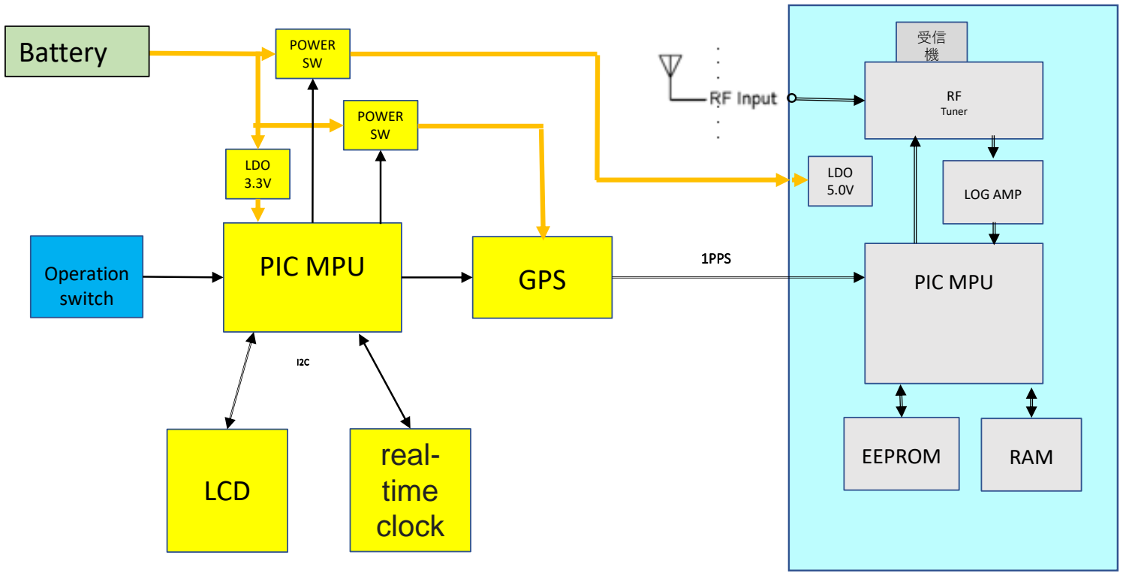
[picture p250: figure]
1PPS PIC MPU; GPS; real- time clock; LCD; Operation switch; LDO 3.3V; POWER SW; PIC MPU; Tuner; LOG AMP; EEPROM; LDO 5.0V; RAM; Battery

2020.3.1 fukai

# UHF receiver diagram

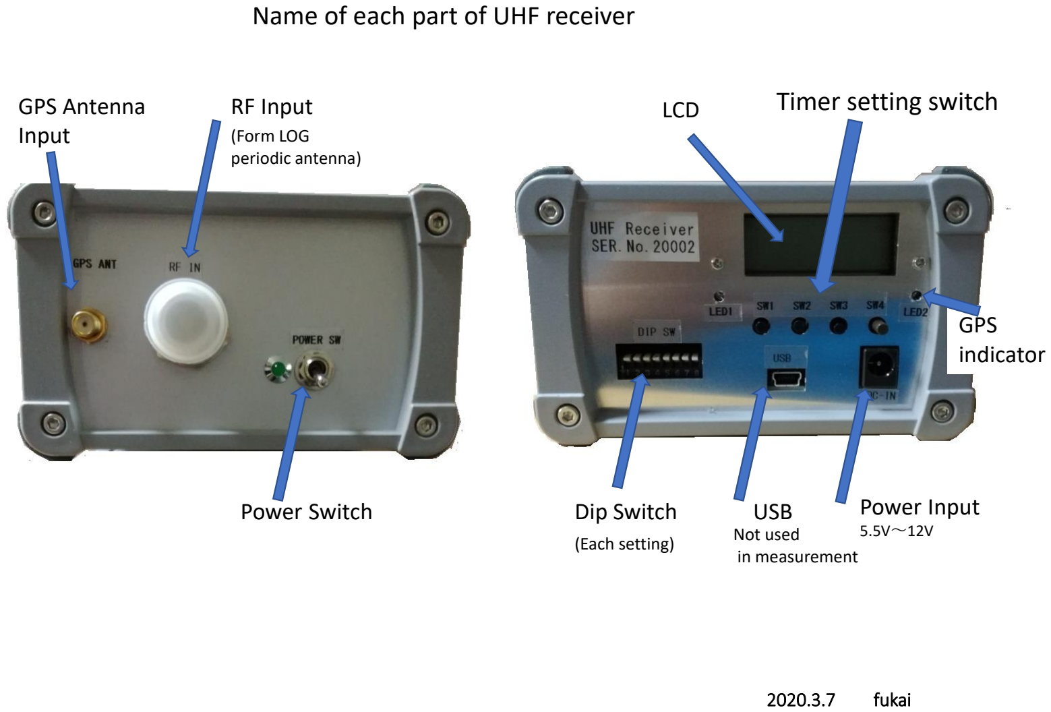
[picture p251: page 4]

2020.3.7 fukai

Name of each part of UHF receiver

GPS Antenna
Input | (Form LOG periodic antenna)

RF Input

Power Switch | Dip Switch (Each setting)

Power Input
5.5V～12V

USB

LCD Timer setting switch

GPS
indicator

Not used
in measurement

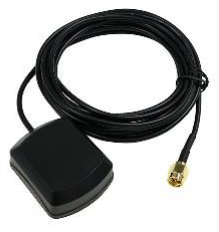
[picture p252: figure]
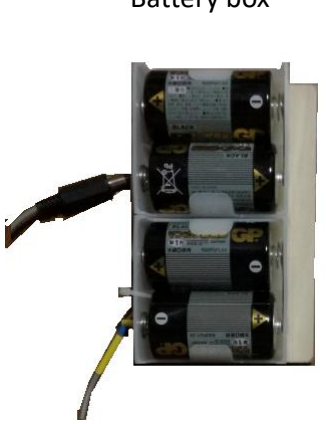
[picture p253: figure]

GPS antenna | Battery box

# Measurement flow

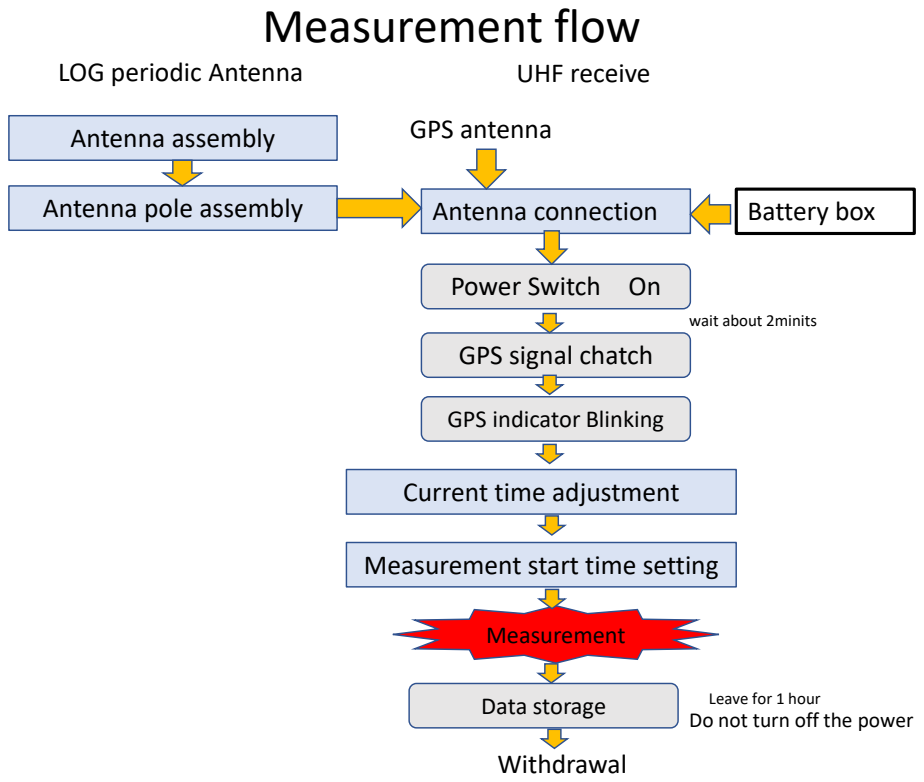
[picture p254: page 6]
Antenna assembly; Antenna connection; UHF receive; GPS antenna; Battery box; wait about 2minits; Measurement; Data storage; Leave for 1 hour; Withdrawal

LOG periodic Antenna

Antenna pole assembly

Power Switch On

GPS signal chatch

GPS indicator Blinking

Current time adjustment

Measurement start time setting

Do not turn off the power

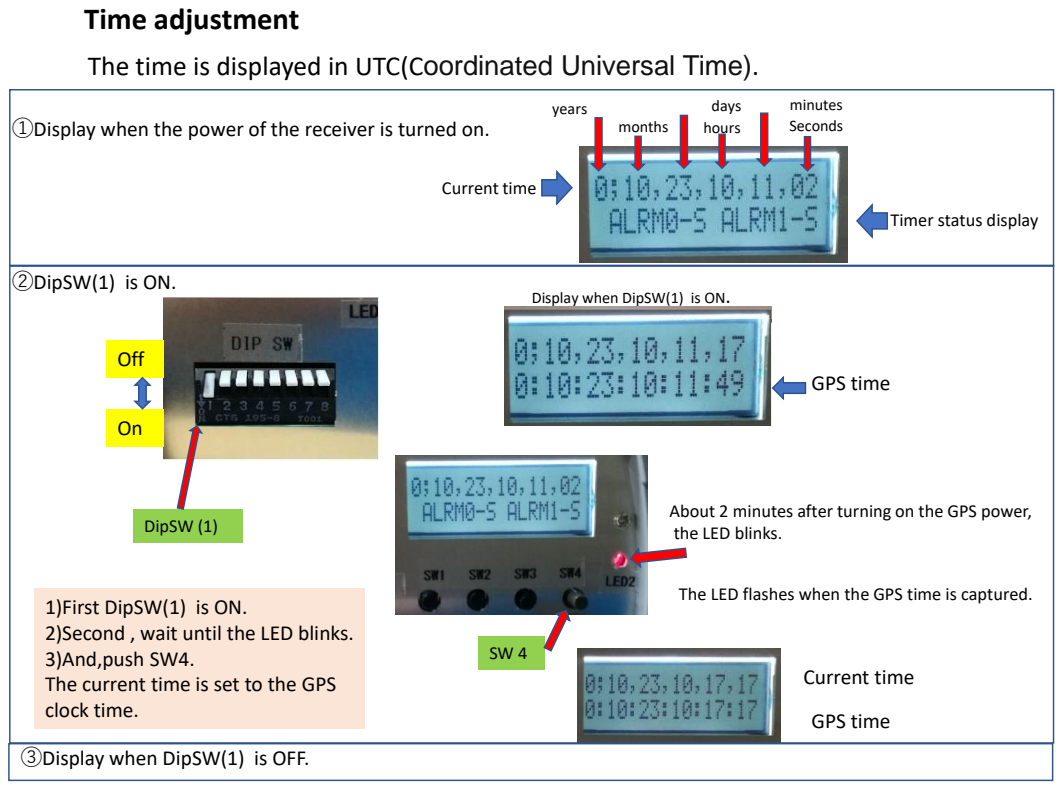
[picture p255: page 7]
GPS time; Current time; months; days hours; minutes Seconds; years; Off; DipSW (1)

Time adjustment
The time is displayed in UTC(Coordinated Universal Time).

①Display when the power of the receiver is turned on.

Timer status display

②DipSW(1) is ON.

Display when DipSW(1) is ON.

About 2 minutes after turning on the GPS power,
the LED blinks.

The LED flashes when the GPS time is captured.

1)First DipSW(1) is ON.
2)Second , wait until the LED blinks.
3)And,push SW4.
The current time is set to the GPS
clock time.

③Display when DipSW(1) is OFF.

Measurement start time setting

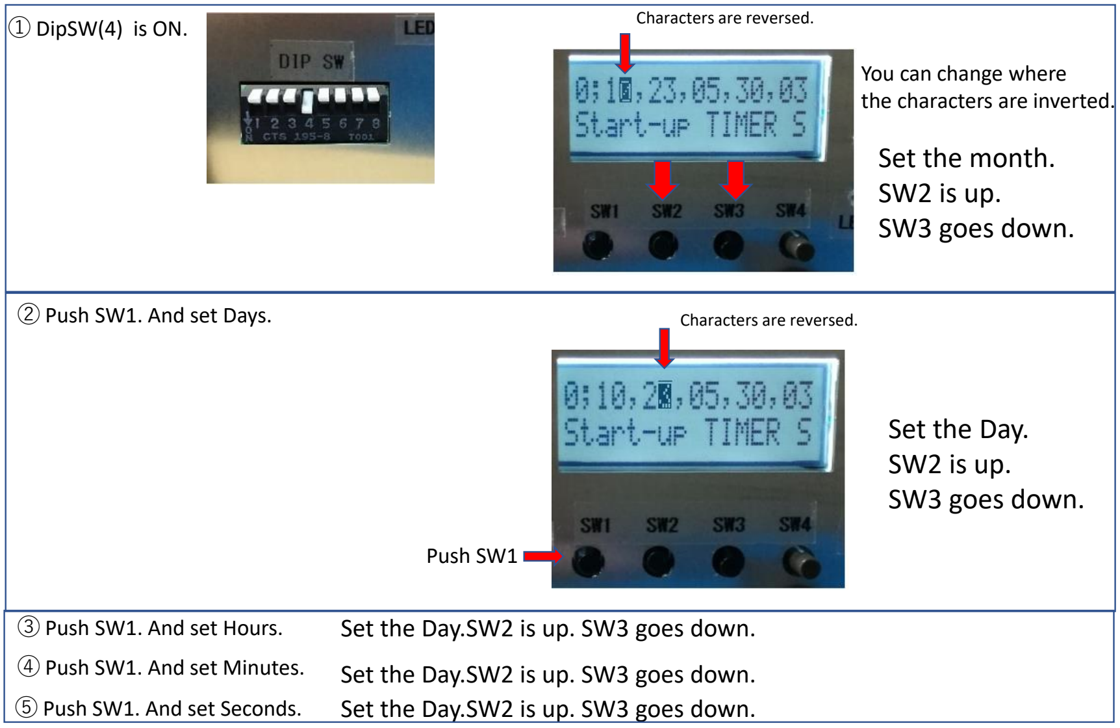
[picture p256: figure]
① DipSW(4) is ON.; Characters are reversed.; You can change where the characters are inverted.; Set the month. SW2 is up. SW3 goes down.; Push SW1; Set the Day. SW2 is up. SW3 goes down.; ④ Push SW1. And set Minutes.; ⑤ Push SW1. And set Seconds.; Set the Day.SW2 is up. SW3 goes down. Set the Day.SW2 is up. SW3 goes down.

② Push SW1. And set Days. | Characters are reversed.
③ Push SW1. And set Hours. | Set the Day.SW2 is up. SW3 goes down.

Preparation for measurement

① DipSW(1) and (4) is OFF.

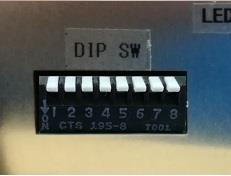
[picture p257: figure]

②The power is connected, and the switch remains on. Store in a waterproof case.

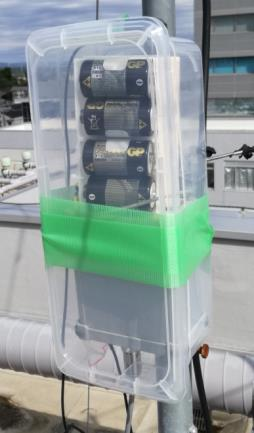
[picture p258: figure]

③Attach to the pole.

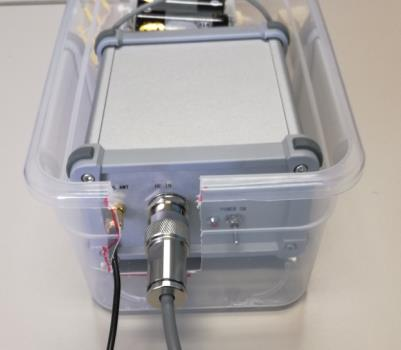
[picture p259: figure]

GPS antenna

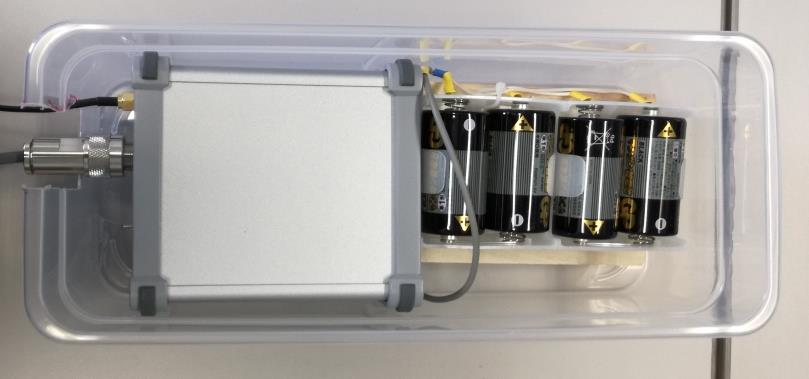
[picture p260: figure]
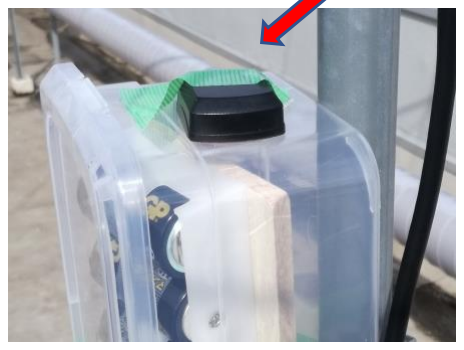
[picture p261: figure]

Measurement

When the timer set time is reached, data is automatically acquired for 5 minutes. After acquiring the data, transfer the data to EEPROM.
During this time, it takes 1 hour, so do not turn off the power.

After 1 hour or more has passed after the measurement is completed, turn off the power switch.
After that, do not connect the power supply.
The data may be overwritten.
We read the data.
Thank you very much.
Please contact us if you have any questions.

After Measurement
