desertfireballnetwork/observatories_technical_wiki/installations/Photos_of_Fireball_Camera_Installations.md

---
title: "Installation Photos"
parent: "Site Installations"
---
Just drag and drop your photos onto this page and we will organise them!
(or you can add them to the gallery below yourself it you want to)

## Roof-top installations in Australia - DFNSMALL, DFNEXT

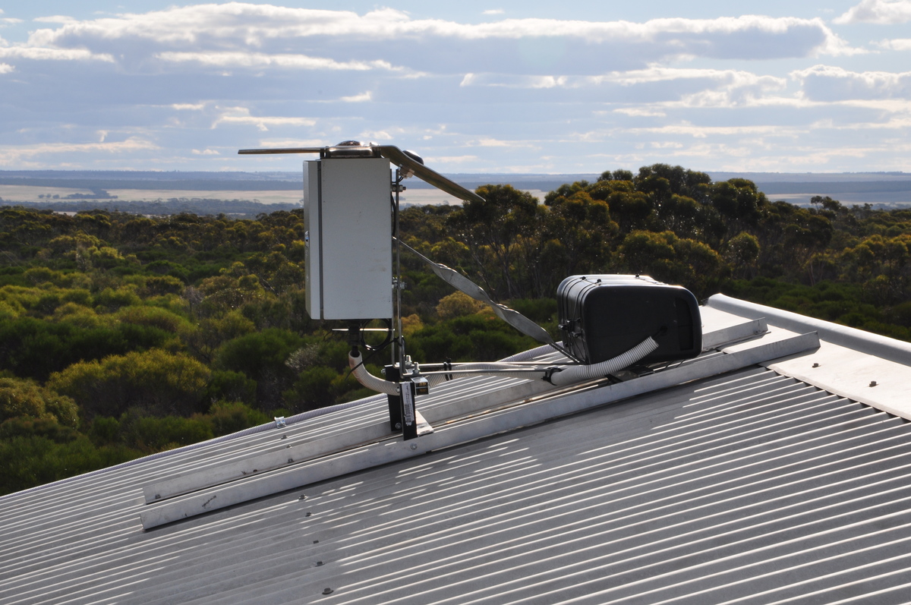
[picture p262: images/DSC_1496_Hyden_camera_1200.JPG]
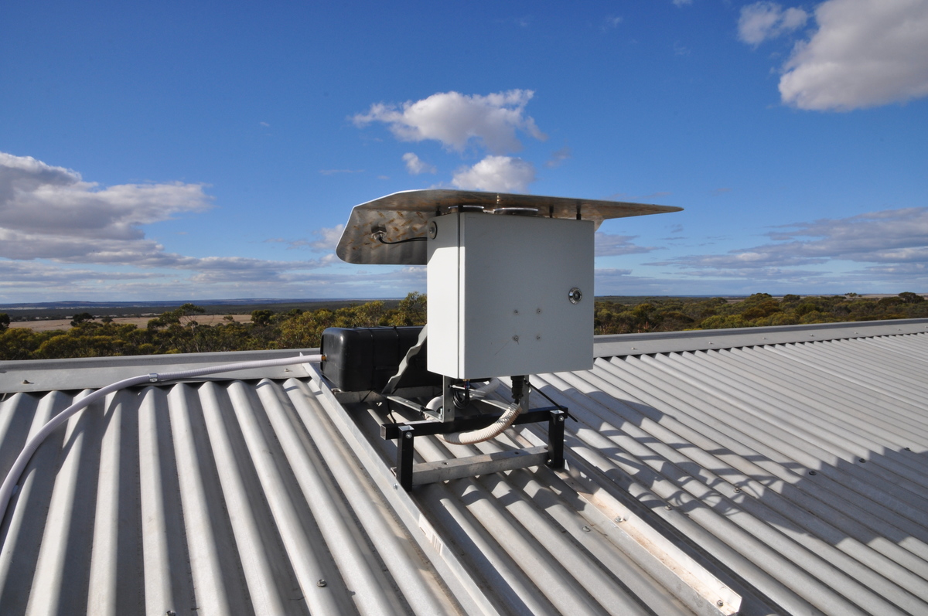
[picture p263: images/DSC_1485_Hyden_camera_1200.JPG]
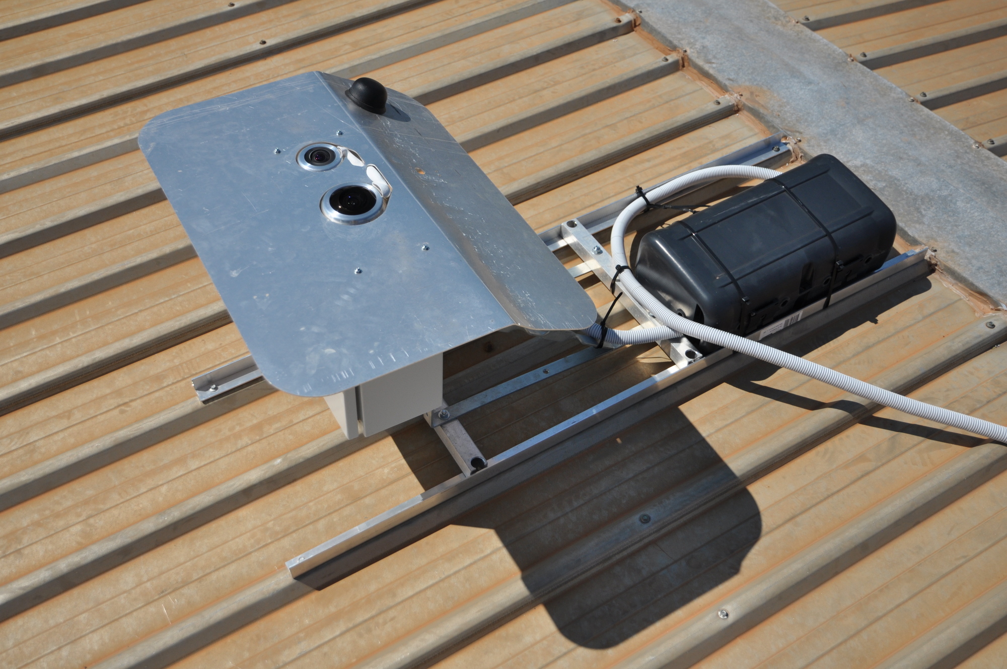
[picture p264: images/Top_down_view_of_roof_mount.jpg]
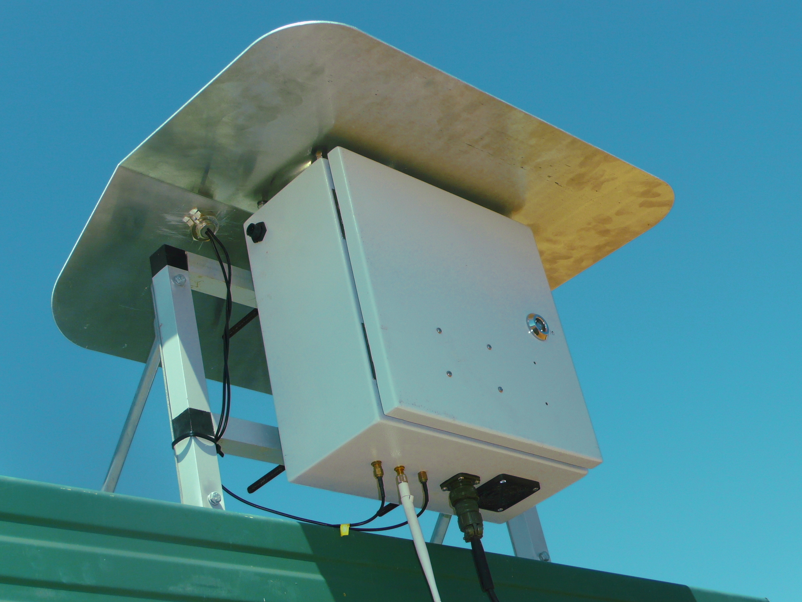
[picture p265: images/Rooftop_mount_with_modular_aluminium_frame.jpg]
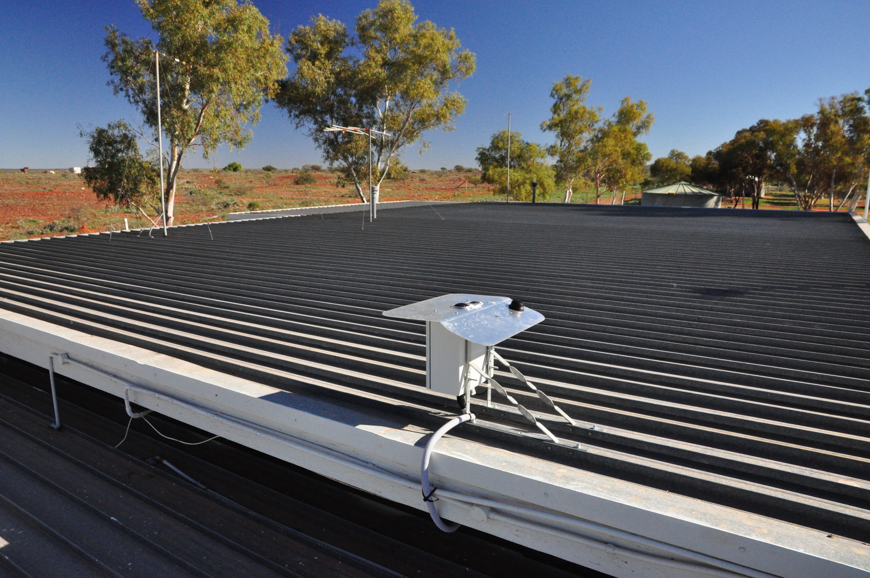
[picture p266: images/Yalgoo_rooftop_camera_wide.jpg]
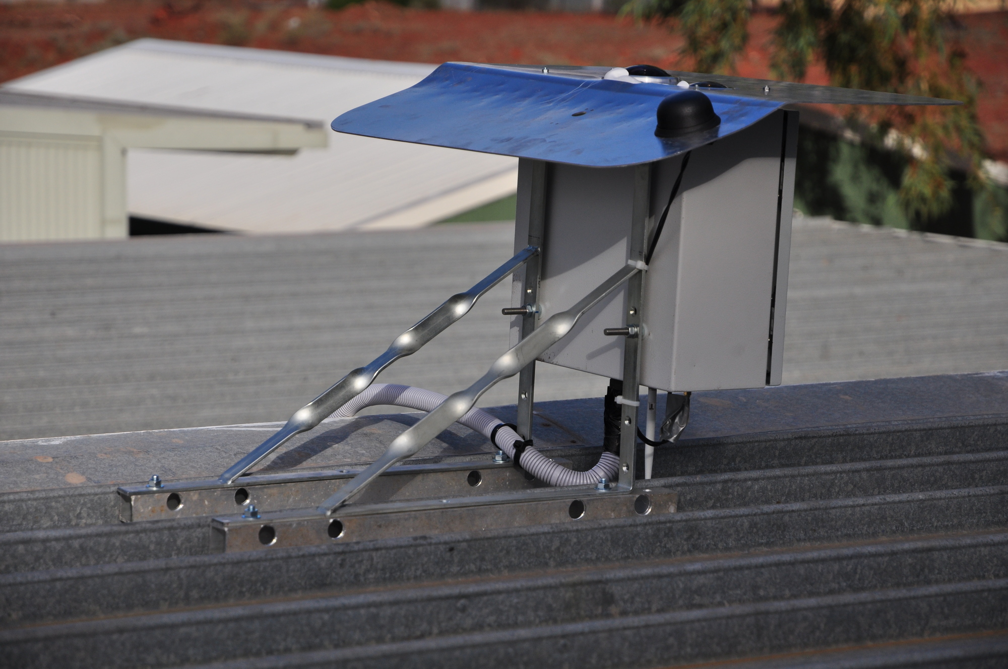
[picture p267: images/Shelving_bracket_roof_mount.jpg]
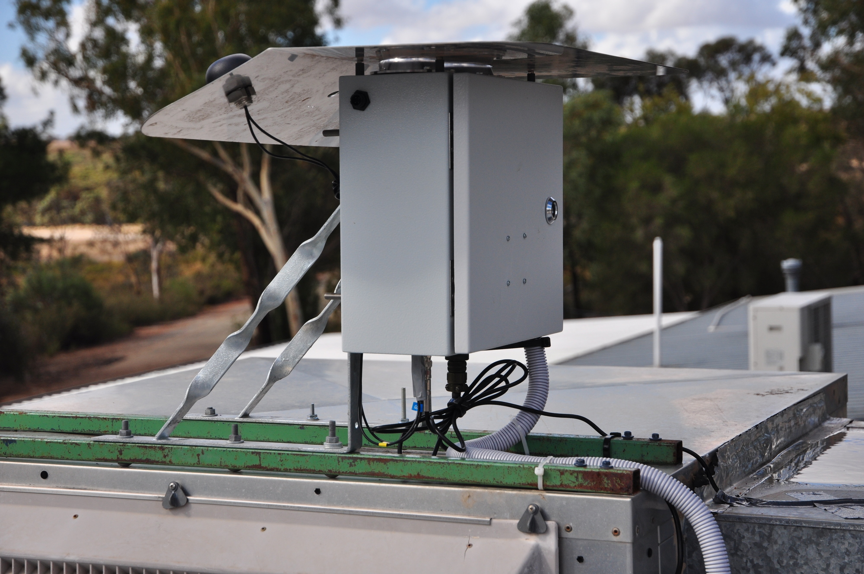
[picture p268: images/Rooftop_camera.jpg]
\| \| \| \| \| \| \|

## Grid powered installations in Morocco - DFNEXT

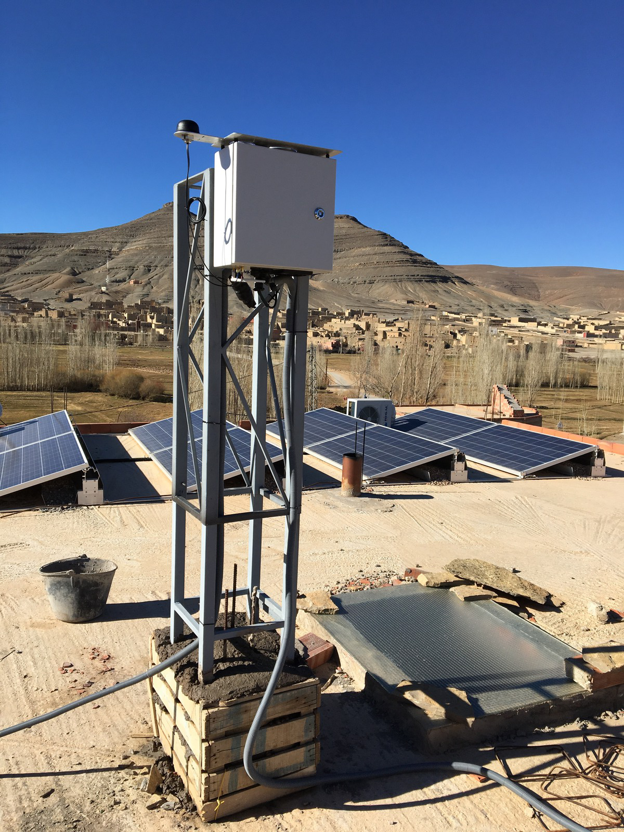
[picture p269: images/IMG_5087_Agoudal_DFNEXT_1600.jpg]
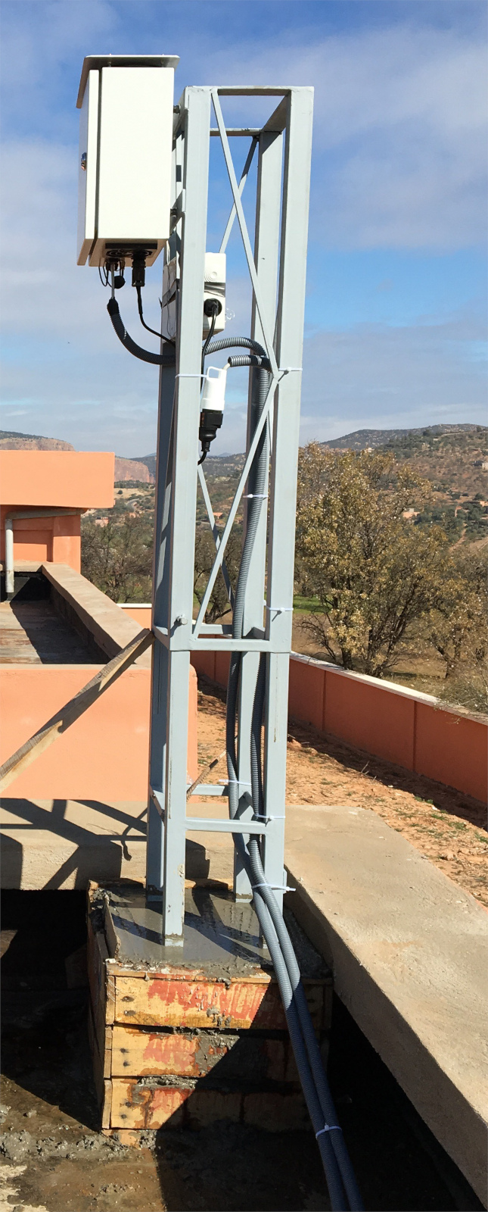
[picture p270: images/IMG_5373_Ozoud_DFNEXT_1600.jpg]
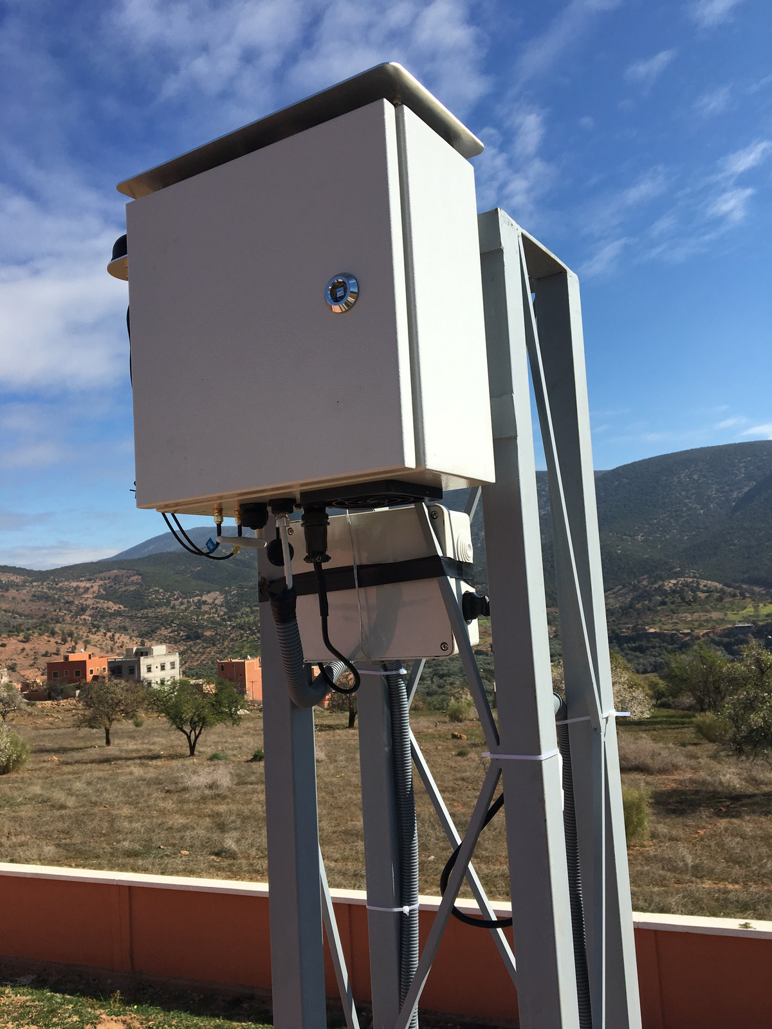
[picture p271: images/IMG_5377_Ozoud_DFNEXT_1600.jpg]
\| \| \|

<center>

Photos courtesy of Moroccan Observatory for Fireball Detections (MOFID)

</center>

## Installations in Canada

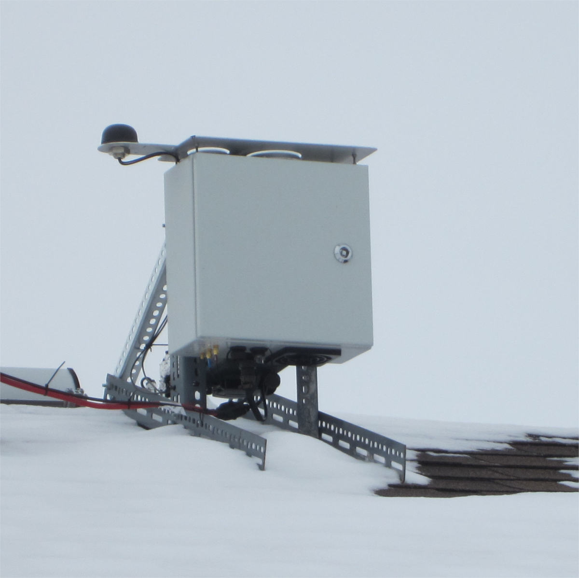
[picture p272: images/Vermilion_DFNEXT_IMG_1358_crop1200.jpg]
\|
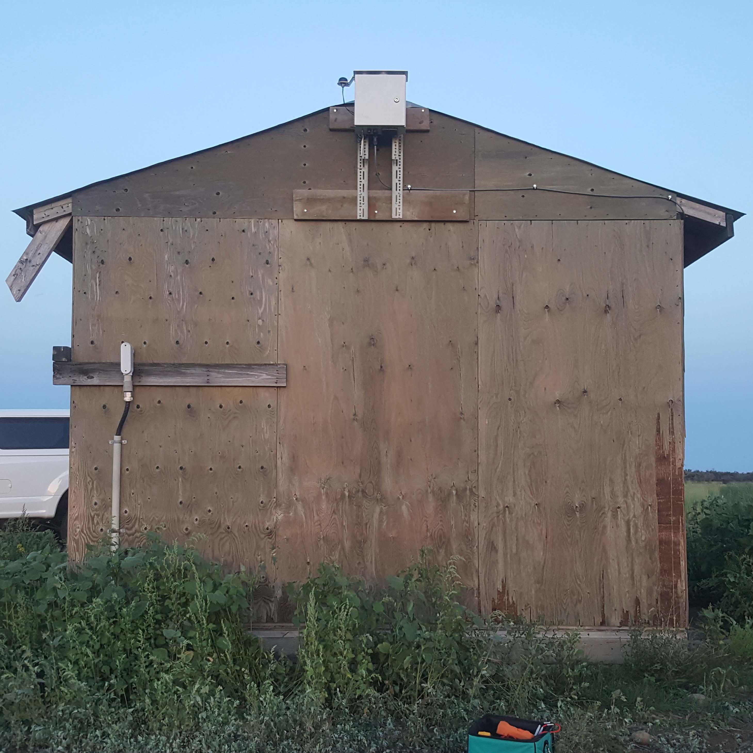
[picture p273: images/Mattheis_Ranch_Fireball_Camera.jpg]
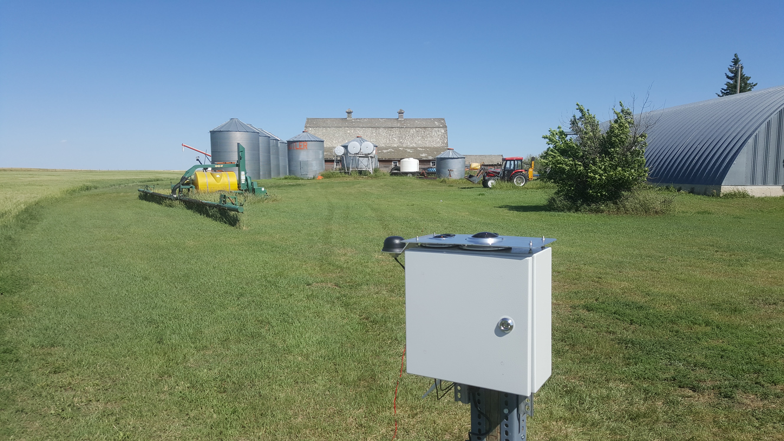
[picture p274: images/20190725_160927.jpg]
\| \|

Photo courtesy of Rob Baron, Lakeland College (the most left image) and
Patrick Hill, University of Alberta (the two on the right).

## Installations in Arizona

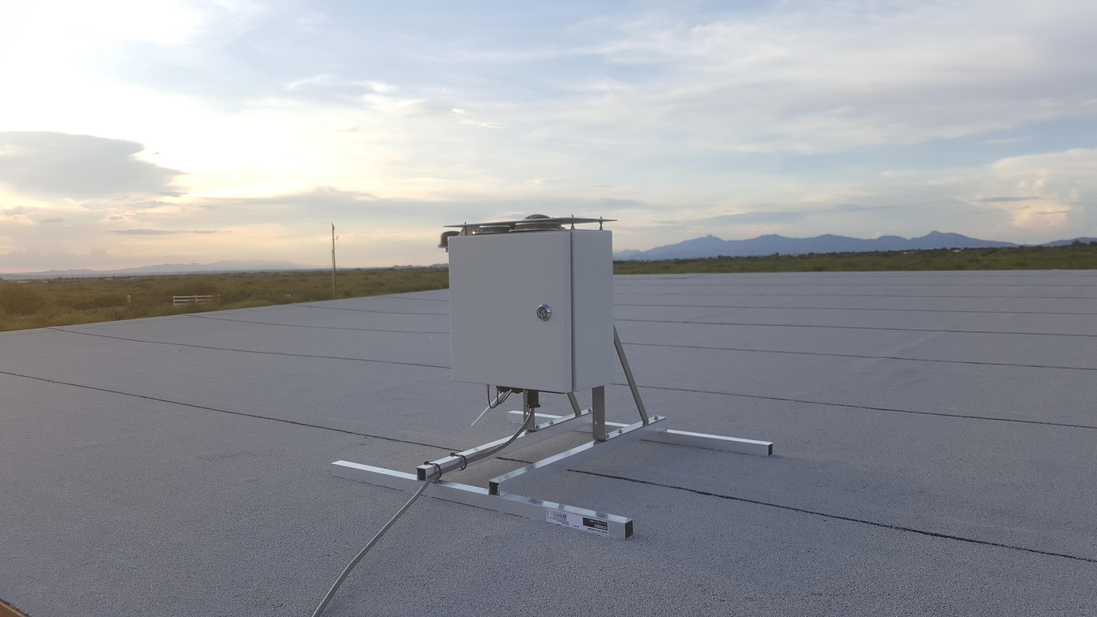
[picture p275: images/Chiricahua_Astronomy_Complex_Fireball_Camera.jpg]
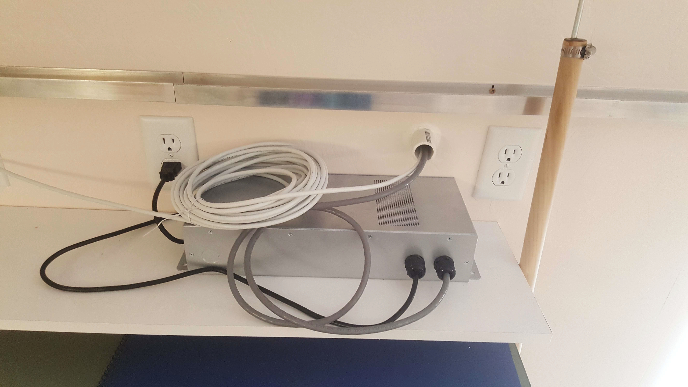
[picture p277: images/Indoor_power_supply.jpg]
\| \| \|

## Installations in the UK

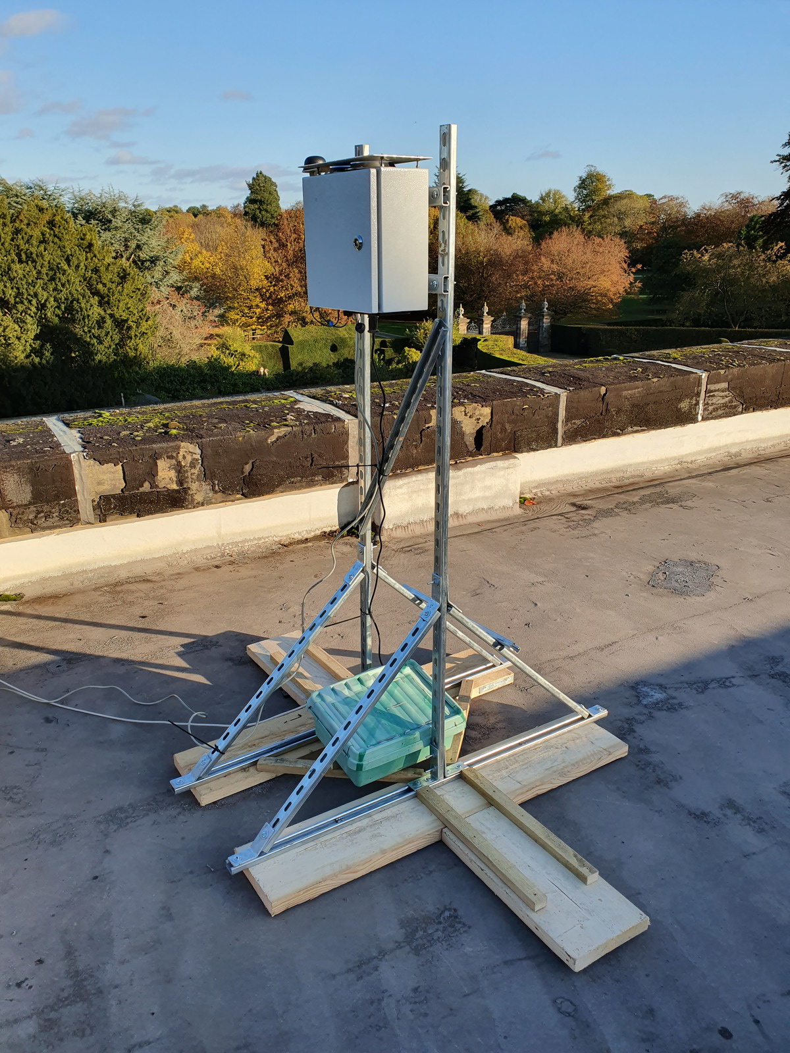
[picture p278: images/20191027_UK_Newby_Hall.jpg]
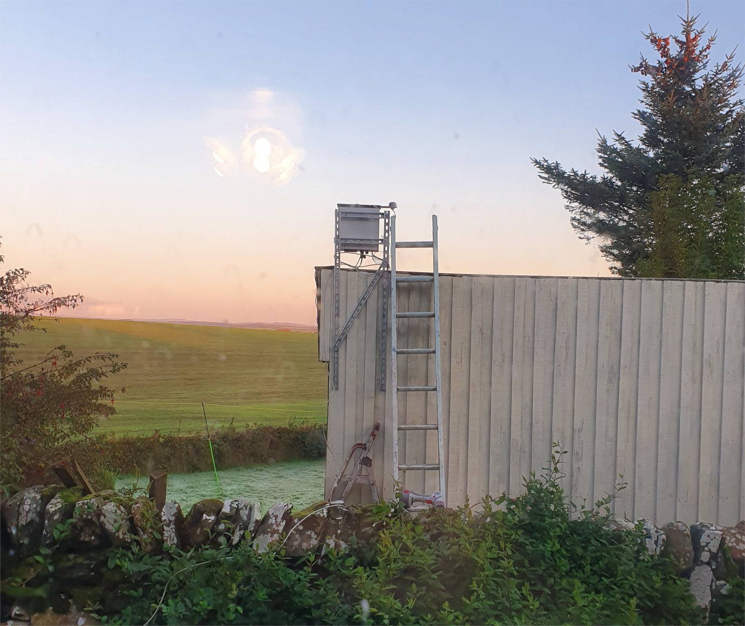
[picture p279: images/20191028_UK_Galloway.jpg]
\| \|
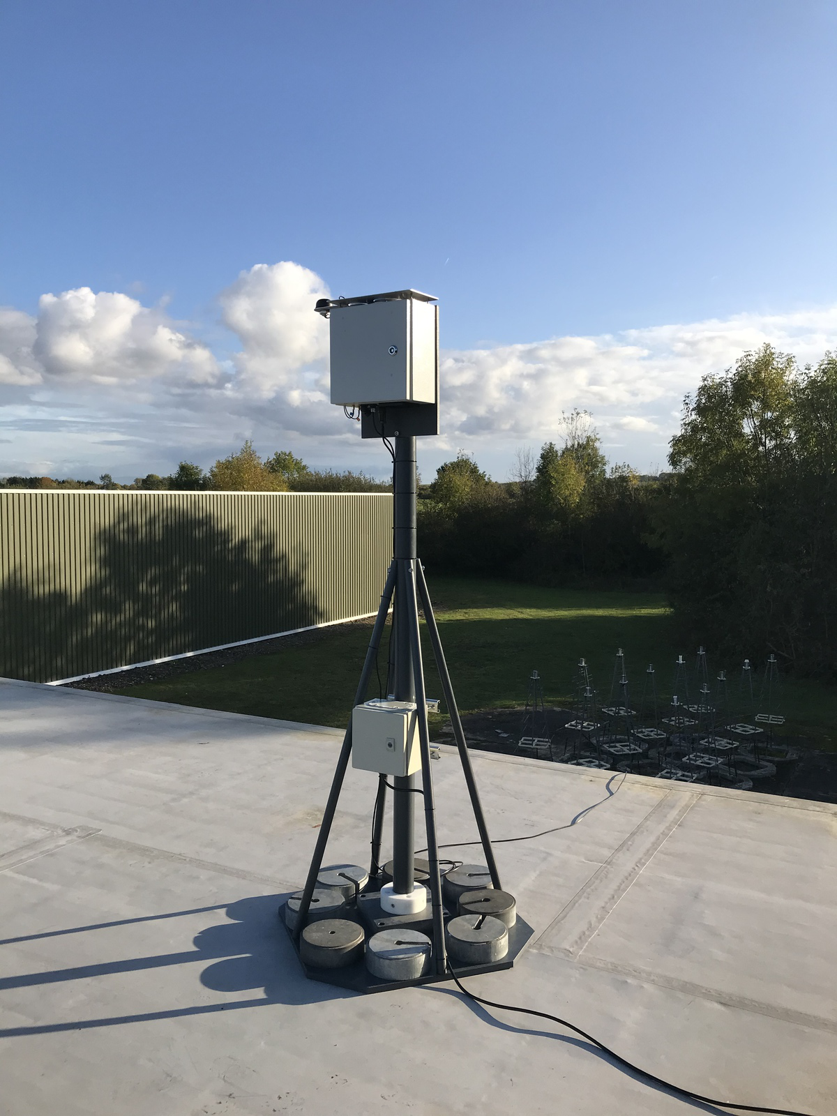
[picture p280: images/B0B07CCD_UK_MRAO_Cambridge.jpg]
\|

<center>

Photos courtesy of Dr. Luke Daly, UKFN

</center>

## Standalone solar powered installations in Australia - DFNSMALL, DFNEXT

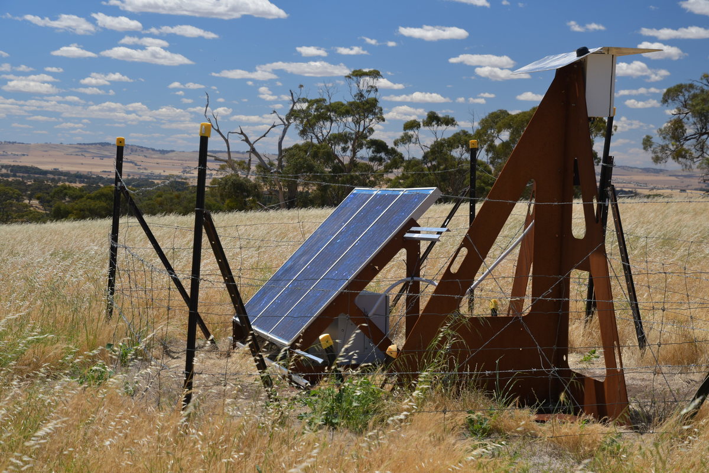
[picture p281: images/DaysHill_camera_1200.JPG]
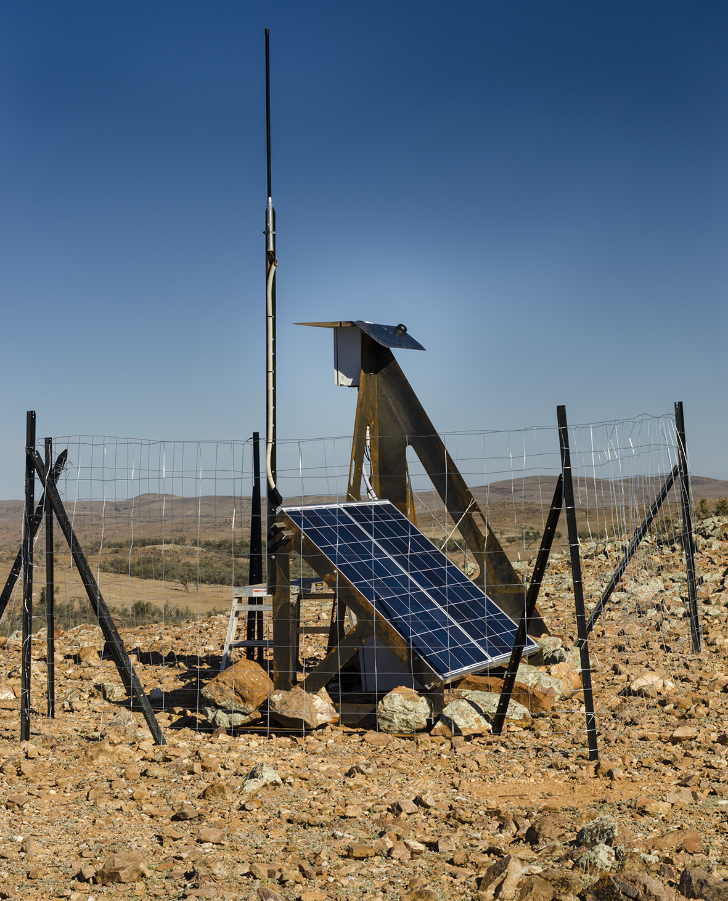
[picture p282: images/Weekeroo.jpg]
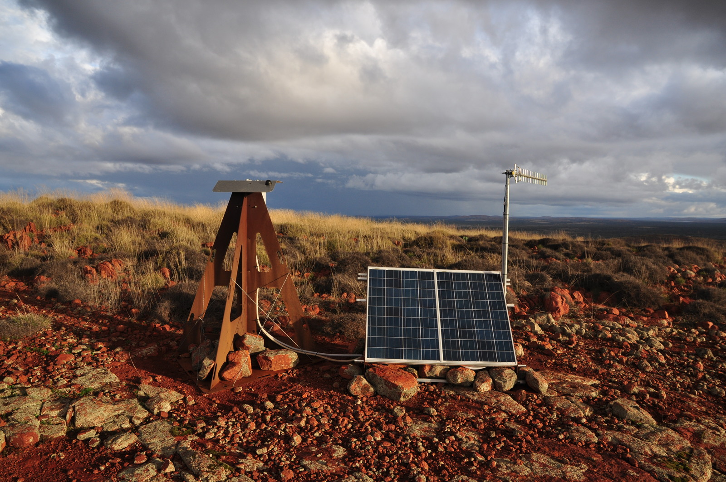
[picture p283: images/Mt_Ive_DSC_4688_1600.JPG]
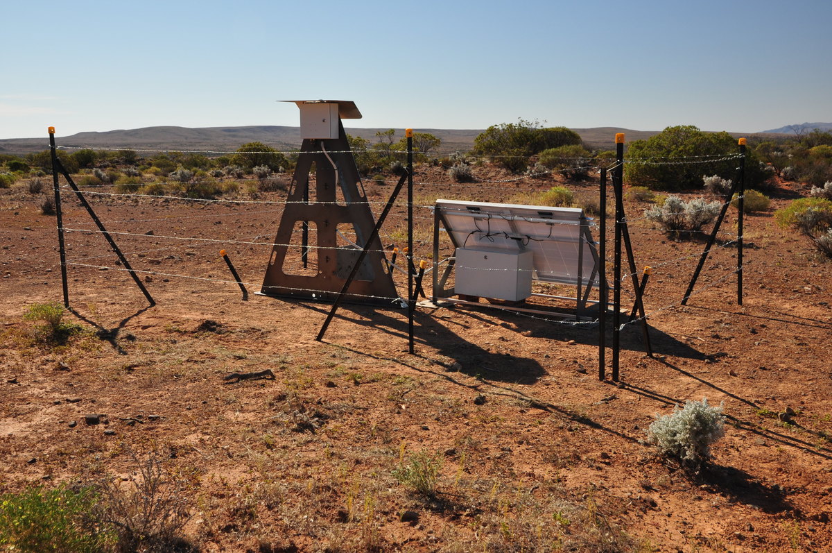
[picture p284: images/Nilpena_camera_1200.JPG]
\| \| \| \|
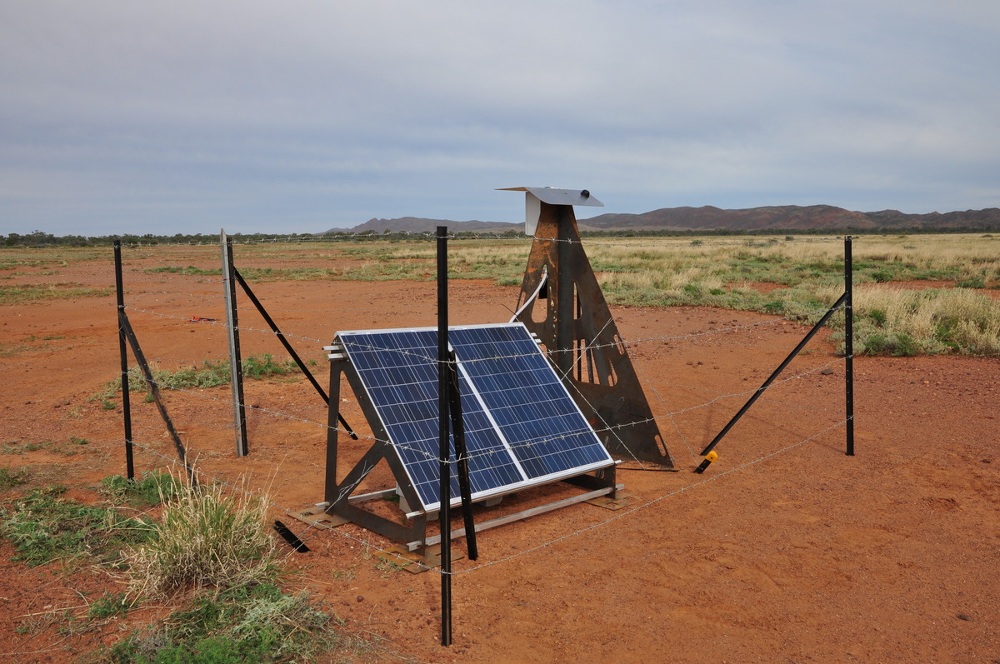
[picture p285: images/Moolawatana_camera_1200.JPG]
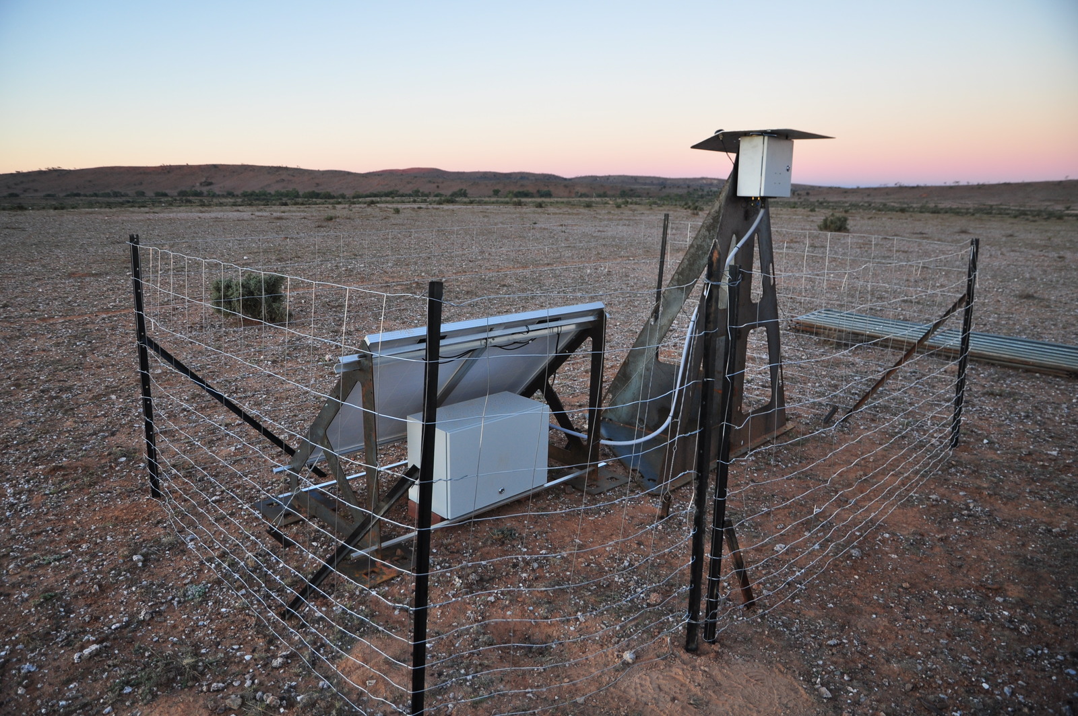
[picture p286: images/Sm_DSC_2024.JPG]
\| \|
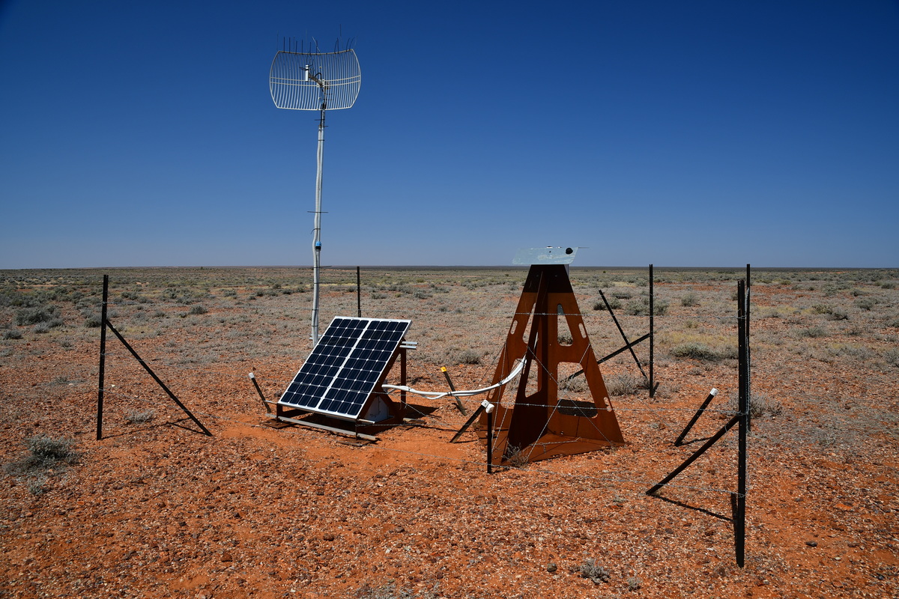
[picture p287: images/Ingomar_camera_1200.JPG]
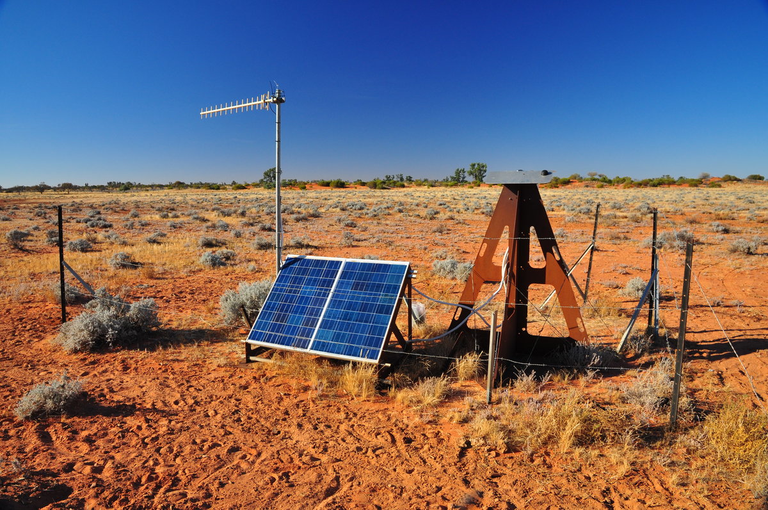
[picture p288: images/BillaKalina_camera_1200.JPG]
\| \|
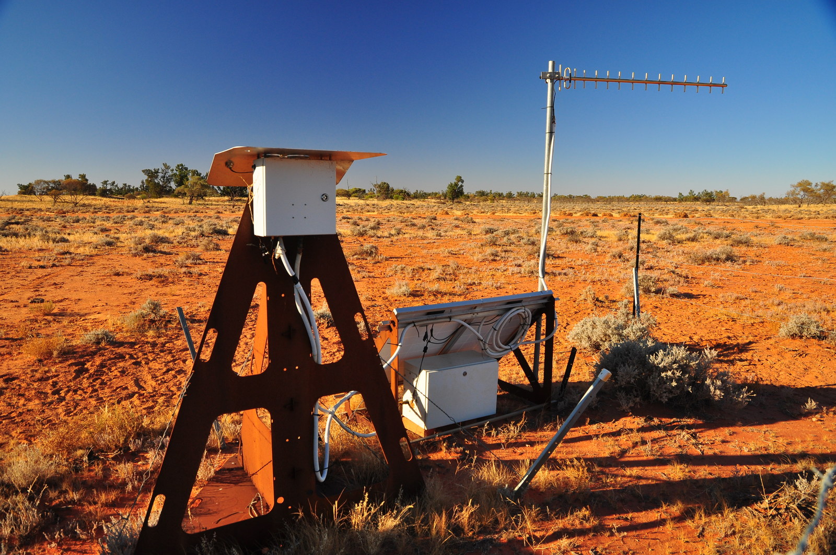
[picture p289: images/Billa_Kalina_DFNSMALL_DSC_4279_1600.JPG]
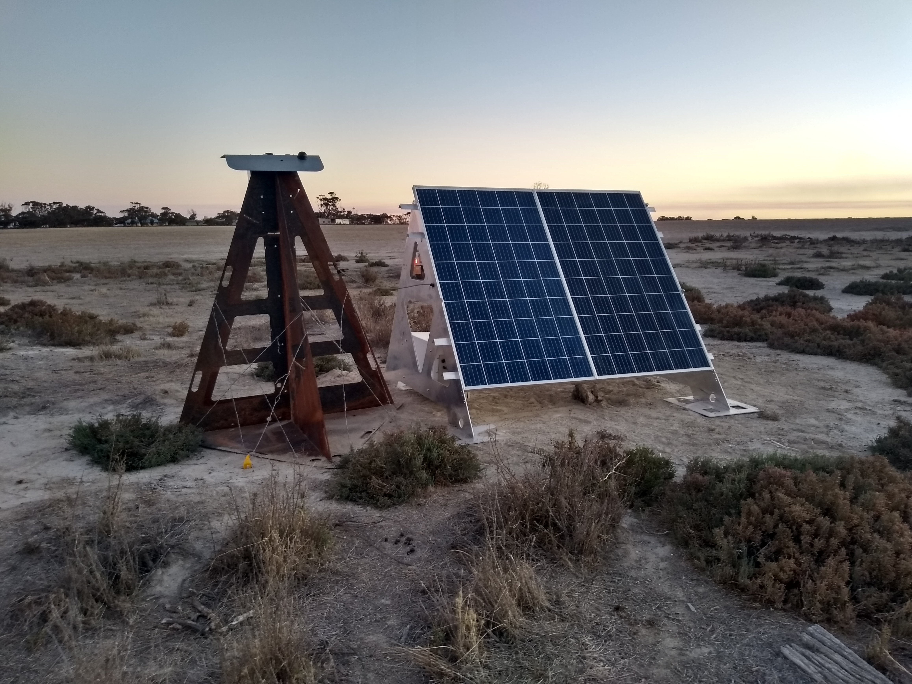
[picture p290: images/Newdegate_standalone_solar_install.jpg]
\| \|

## Standalone solar powered installations in the Kingdom of Saudi Arabia

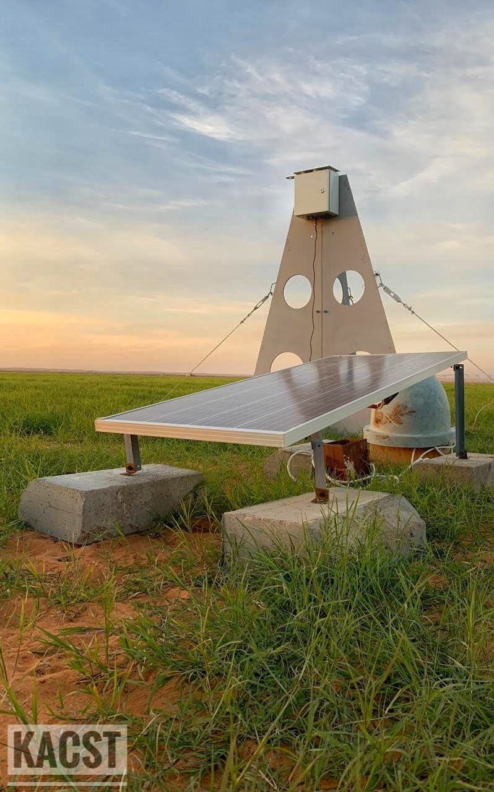
[picture p291: images/DFNEXT13_KSA.jpg]
\|

<center>

Photo courtesy of KACST.

</center>
