desertfireballnetwork/observatories_technical_wiki/images/Lens_install_align.jpg

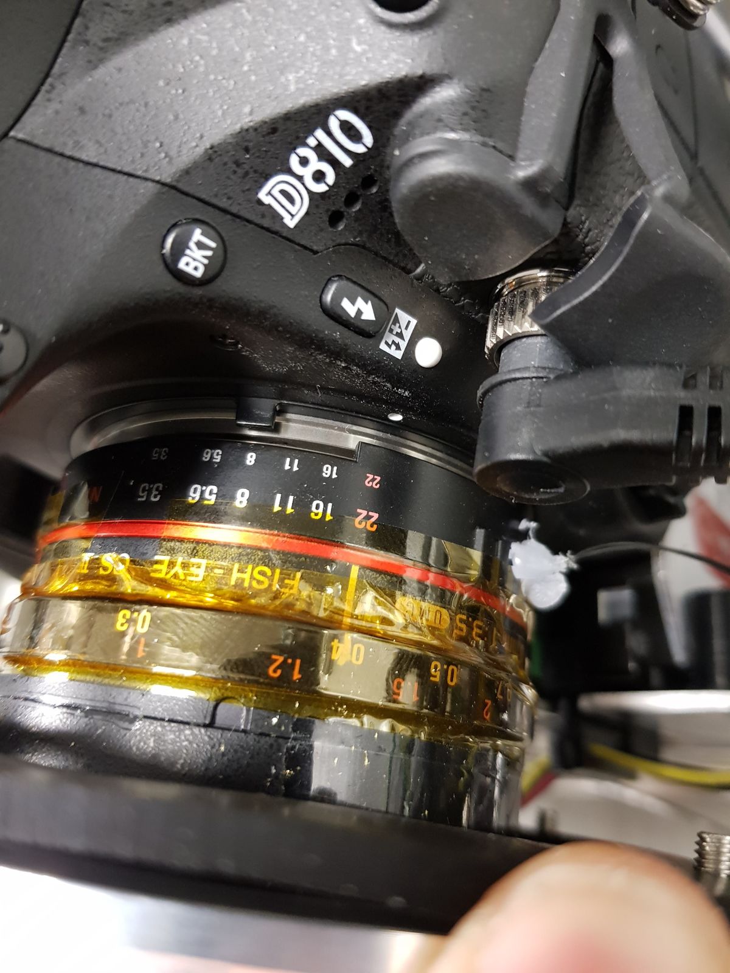
images/Lens_install_align.jpg
