desertfireballnetwork/observatories_technical_wiki/images/Lens_install_shuttercable.jpg

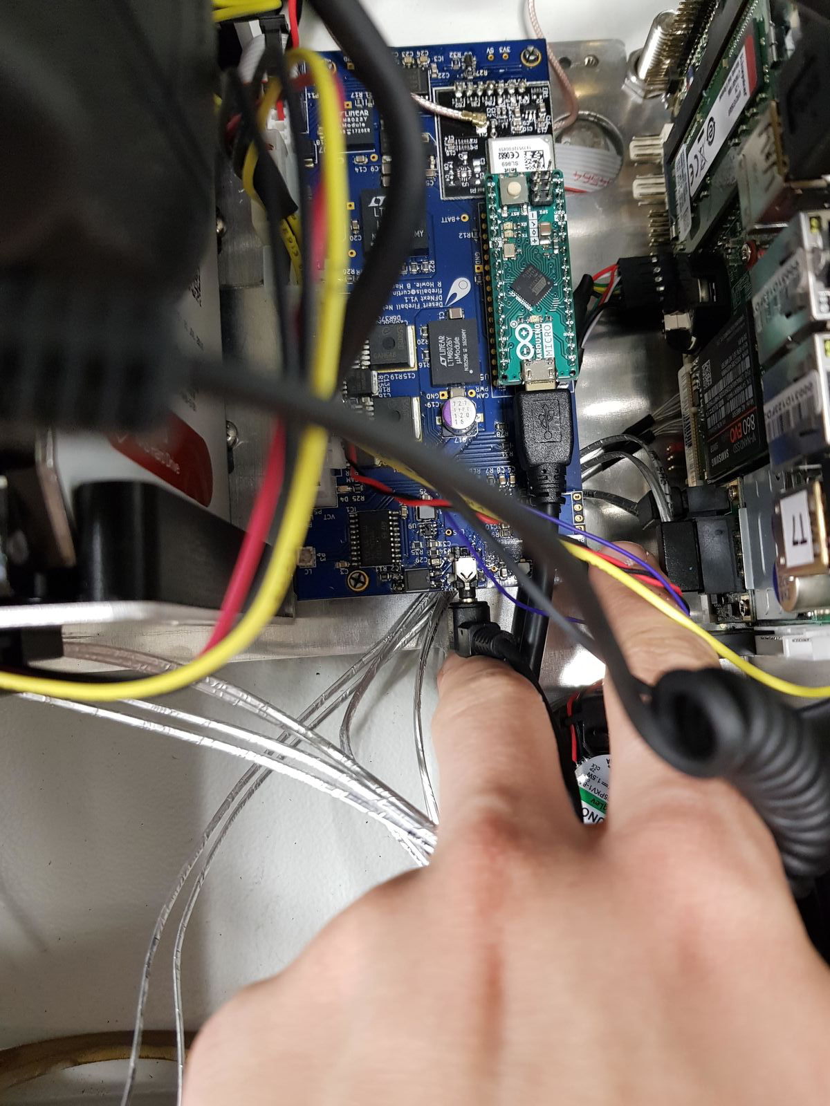
images/Lens_install_shuttercable.jpg
