desertfireballnetwork/observatories_technical_wiki/Calibrating_the_camera_orientation.md

*Note: this page is a stub and needs to be extended.*

As part of the initial setup, you must calibrate the camera, so that is
knows which direction is north, zenith. This is important for the
triangulations, as the camera must convert coordinates of pixel events
into altitude, azimuth, and then into Right Ascension, Declination

If you deploy the camera as detailed in the
[standalone](Standalone_Fireball_Camera_Installation.html)
section, with the long axis of the camera east/west, and the correct
direction north (camera stand towards North, camera enclosure door
towards South), then the default values are OK, and you don't need to do
anything.

## Using the GUI

N/A yet

## Command line

please don't
