desertfireballnetwork/observatories_technical_wiki/Camera_Maintenance.md

### Servicing and deployment checklists

Printable PDF checklists with steps what to do on a remote site.

- [Camera system replace / deploy
  checklist](Media:Checklist_replace_camera_box.pdf.html)
  (commandline/text terminal instructions)
- [GUI commands checklist](Media:Checklist_Web_GUI.pdf.html) (Web
  GUI, missing some steps not implemented in the GUI)
- [Camera system servicing checklist - replacing HDDs on
  site](Media:Checklist_HDDs_replace.pdf.html)

### Checklist for refurbish, repair, upgrade before shipping or heading on a trip

Parts of this checklist are also useful in the field, when a major
troubleshooting and/or repair is conducted on-site rather than in lab.

- [Checklist for configuration and testing in
  lab](Media:Checklist_in_lab_refurbish_shipping_trip.pdf.html)
  (requires some knowledge of the camera system)

### General User Interface via the web

When servicing cameras, the
[GUI](Using_the_GUI_for_Regular_Maintenance.html) is your first
port of call. It can be used to

- [Check hard drive storage
  space](Using_the_GUI_for_Regular_Maintenance#Check_hard_drive_storage_space.html)
- [Check GPS
  status](Using_the_GUI_for_Regular_Maintenance#Check_GPS_status.html)
- [Format
  HDDs](Manual_Maintenance#3._Format_the_new_drives_after_replacing.html)
- [Run testing
  software](Using_the_GUI_for_Regular_Maintenance#Run_interval_control_test.html)

For full instructions on it's use, see [Using the GUI for Regular
Maintenance](Using_the_GUI_for_Regular_Maintenance.html).

### Physical HW maintenance

You will also occasionally be required to:

- [Installing lens and
  DSLR](How_to_install_flanged_Samyang_lens_and_DSLR_to_the_DFNEXT_enclosure.html)
  in the [DFNEXT](Observatory_Types.html) observatory type
- [Fitting the outer blower
  ducting](Fitting_the_outer_blower_ducting.html) on a
  [DFNEXT](DFNEXT.html) or [DFNSMALL](DFNSMALL.html)
  observatory
- Physically replace [the hard
  drives](Replacing_the_Hard_Drives.html)
- Clean the Lenses and [Applying Hydrophobic Lens
  Coating](Applying_Hydrophobic_Lens_Coating.html)
- [Nikon DSLR settings](DSLR_Settings.html)
- [Focusing the DSLR](Focusing_the_DSLR.html)
- [Focusing the video lens](Focusing_the_video_lens.html)
- [Format the CF Card](Formatting_the_CF_Card.html)
- [Replacing the embedded
  PC](Manual_Maintenance#Replacing_embedded_PC_board.html)
- [Replacing hard drives](Replacing_hard_drives.html), incl what
  models are recommended

This is recommended [minimal
toolkit](Camera_Maintenance_Toolkit.html). This is a
[comprehensive servicing](Camera_servicing_kit.html) kit we use on
field trips in Australia.

### [Manual Maintenance](Manual_Maintenance.html) using commandline (Todo: move this link and recategorise content within)

If you are ever required to perform any manual maintenance, use the
following links for information on the following topics, or see the
general [Manual Maintenance](Manual_Maintenance.html) page.

- [Replace the Hard
  Drives](Manual_Maintenance#Installing_new_HDDs.html)
- [Update Software](Manual_Maintenance#Software_Updates.html),
  [Update Software Page 2](Update_Software.html) Todo: fix
  duplication here
- [Connecting to the PC with a keyboard and
  monitor](Manual_Maintenance#Direct_connection.html)
- [Finding network interface MAC
  address](Finding_network_interface_MAC_address.html)
- [Configure the local time
  zone](Manual_Maintenance#Configure_timeozne.html)

### Advanced Usage

- [Microcontroller Commands](Microcontroller_Commands.html)

<!-- -->

- [Which camera type do I have?](Observatory_Types.html)

#### DFNSMALLs

- [DFNSMALL observatories BIOS
  configuration](DFNSMALL_observatories_BIOS_configuration.html) -
  including jumpers - for Commell LE-37D PC
- [DFNSMALL observatories BIOS configuration -
  Advantech](DFNSMALL_observatories_BIOS_configuration_-_Advantech.html) -
  including BIOS update - for Advantech MIO 5250 PC

#### DFNSKITs

- [DFNKIT embedded PC BIOS
  configuration](DFNSMALL_observatories_BIOS_configuration.html) -
  including jumpers - for Commell LE-37D PC

#### DFNEXTs

- [DFNEXT onservatories BIOS
  configuration](DFNEXT_onservatories_BIOS_configuration.html) -
  including jumpers - for Commell LE-37G PC

#### FireOPALs

- [FireOPAL observatories specific
  configurations](FireOPAL_observatories_specific_configurations.html)
  (6-core Mini ITX PC BIOS)
