desertfireballnetwork/observatories_technical_wiki/observatories/maintenance/index.md

---
title: "Observatory Maintenance"
has_children: true
parent: "Observatories"
---
### Servicing and deployment checklists

Printable PDF checklists with steps what to do on a remote site.

- [Camera system replace / deploy
  checklist]({{ site.baseurl }}/images/Checklist_replace_camera_box.pdf)
  (commandline/text terminal instructions)
- [GUI commands checklist]({{ site.baseurl }}/images/Checklist_Web_GUI.pdf) (Web
  GUI, missing some steps not implemented in the GUI)
- [Camera system servicing checklist - replacing HDDs on
  site]({{ site.baseurl }}/images/Checklist_HDDs_replace.pdf)

### Checklist for refurbish, repair, upgrade before shipping or heading on a trip

Parts of this checklist are also useful in the field, when a major
troubleshooting and/or repair is conducted on-site rather than in lab.

- [Checklist for configuration and testing in
  lab]({{ site.baseurl }}/images/Checklist_in_lab_refurbish_shipping_trip.pdf)
  (requires some knowledge of the camera system)

### General User Interface via the web

When servicing cameras, the
[GUI]({% link observatories/maintenance/Using_the_GUI_for_Regular_Maintenance.md %}) is your first
port of call. It can be used to

- [Check hard drive storage
  space]({% link observatories/maintenance/Using_the_GUI_for_Regular_Maintenance.md %})
- [Check GPS
  status]({% link observatories/maintenance/Using_the_GUI_for_Regular_Maintenance.md %}#gps-status)
- [Format
  HDDs]({% link observatories/maintenance/Manual_Maintenance.md %}#3-format-the-new-drives-after-replacing)
- [Run testing
  software]({% link observatories/maintenance/Using_the_GUI_for_Regular_Maintenance.md %}#interval-control-test)

For full instructions on it's use, see [Using the GUI for Regular
Maintenance]({% link observatories/maintenance/Using_the_GUI_for_Regular_Maintenance.md %}).

### Physical HW maintenance

You will also occasionally be required to:

- [Installing lens and
  DSLR]({% link installations/How_to_install_flanged_Samyang_lens_and_DSLR_to_the_DFNEXT_enclosure.md %})
  in the [DFNEXT]({% link observatories/index.md %}) observatory type
- [Fitting the outer blower
  ducting]({% link observatories/maintenance/Fitting_the_outer_blower_ducting.md %}) on a
  [DFNEXT]({% link observatories/dfnext/index.md %}) or [DFNSMALL]({% link observatories/dfnsmall/index.md %})
  observatory
- Physically replace [the hard
  drives]({% link observatories/maintenance/Replacing_the_Hard_Drives.md %})
- Clean the Lenses and [Applying Hydrophobic Lens
  Coating]({% link observatories/maintenance/Applying_Hydrophobic_Lens_Coating.md %})
- [Nikon DSLR settings]({% link observatories/maintenance/DSLR_Settings.md %})
- [Focusing the DSLR]({% link observatories/maintenance/Focusing_the_DSLR.md %})
- [Focusing the video lens]({% link observatories/maintenance/Focusing_the_video_lens.md %})
- [Format the CF Card]({% link observatories/maintenance/Formatting_the_CF_Card.md %})
- [Replacing the embedded
  PC]({% link observatories/maintenance/Manual_Maintenance.md %}#replacing-embedded-pc-board)
- [Replacing hard drives]({% link observatories/maintenance/Replacing_hard_drives.md %}), incl what
  models are recommended

This is recommended [minimal
toolkit]({% link observatories/maintenance/Camera_Maintenance_Toolkit.md %}). This is a
[comprehensive servicing]({% link observatories/maintenance/Camera_servicing_kit.md %}) kit we use on
field trips in Australia.

### [Manual Maintenance]({% link observatories/maintenance/Manual_Maintenance.md %}) using commandline (Todo: move this link and recategorise content within)

If you are ever required to perform any manual maintenance, use the
following links for information on the following topics, or see the
general [Manual Maintenance]({% link observatories/maintenance/Manual_Maintenance.md %}) page.

- [Replace the Hard
  Drives]({% link observatories/maintenance/Manual_Maintenance.md %}#installing-new-hdds)
- [Update Software]({% link observatories/maintenance/Manual_Maintenance.md %}#software-updates),
  [Update Software Page 2]({% link observatories/maintenance/Update_Software.md %}) Todo: fix
  duplication here
- [Connecting to the PC with a keyboard and
  monitor]({% link observatories/maintenance/Manual_Maintenance.md %}#direct-connection)
- [Finding network interface MAC
  address]({% link network/Finding_network_interface_MAC_address.md %})
- [Configure the local time
  zone]({% link observatories/maintenance/Manual_Maintenance.md %}#configure-timeozne)

### Advanced Usage

- [Microcontroller Commands]({% link observatories/maintenance/Microcontroller_Commands.md %})

<!-- -->

- [Which camera type do I have?]({% link observatories/index.md %})

#### DFNSMALLs

- [DFNSMALL observatories BIOS
  configuration]({% link observatories/dfnsmall/DFNSMALL_observatories_BIOS_configuration.md %}) -
  including jumpers - for Commell LE-37D PC
- [DFNSMALL observatories BIOS configuration -
  Advantech]({% link observatories/dfnsmall/DFNSMALL_observatories_BIOS_configuration_-_Advantech.md %}) -
  including BIOS update - for Advantech MIO 5250 PC

#### DFNSKITs

- [DFNKIT embedded PC BIOS
  configuration]({% link observatories/dfnsmall/DFNSMALL_observatories_BIOS_configuration.md %}) -
  including jumpers - for Commell LE-37D PC

#### DFNEXTs

- [DFNEXT onservatories BIOS
  configuration]({% link observatories/dfnext/DFNEXT_onservatories_BIOS_configuration.md %}) -
  including jumpers - for Commell LE-37G PC

#### FireOPALs

- FireOPAL observatories specific
  configurations
  (6-core Mini ITX PC BIOS)
