desertfireballnetwork/observatories_technical_wiki/images/DFNEXT_and_DFNSMALL_mounting_pattern_(PDF_format).pdf

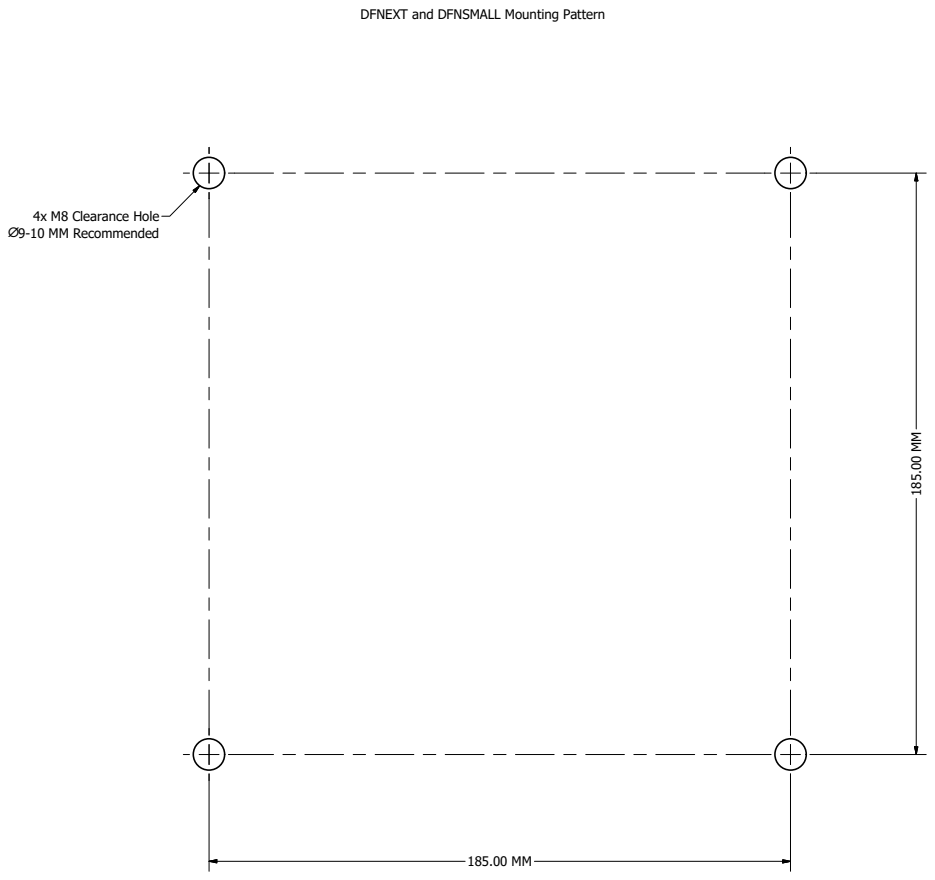
[picture p307: page 1]
4x M8 Clearance Hole

DFNEXT and DFNSMALL Mounting Pattern
