desertfireballnetwork/observatories_technical_wiki/images/DFNEXT_Winged_wall_mount.pdf

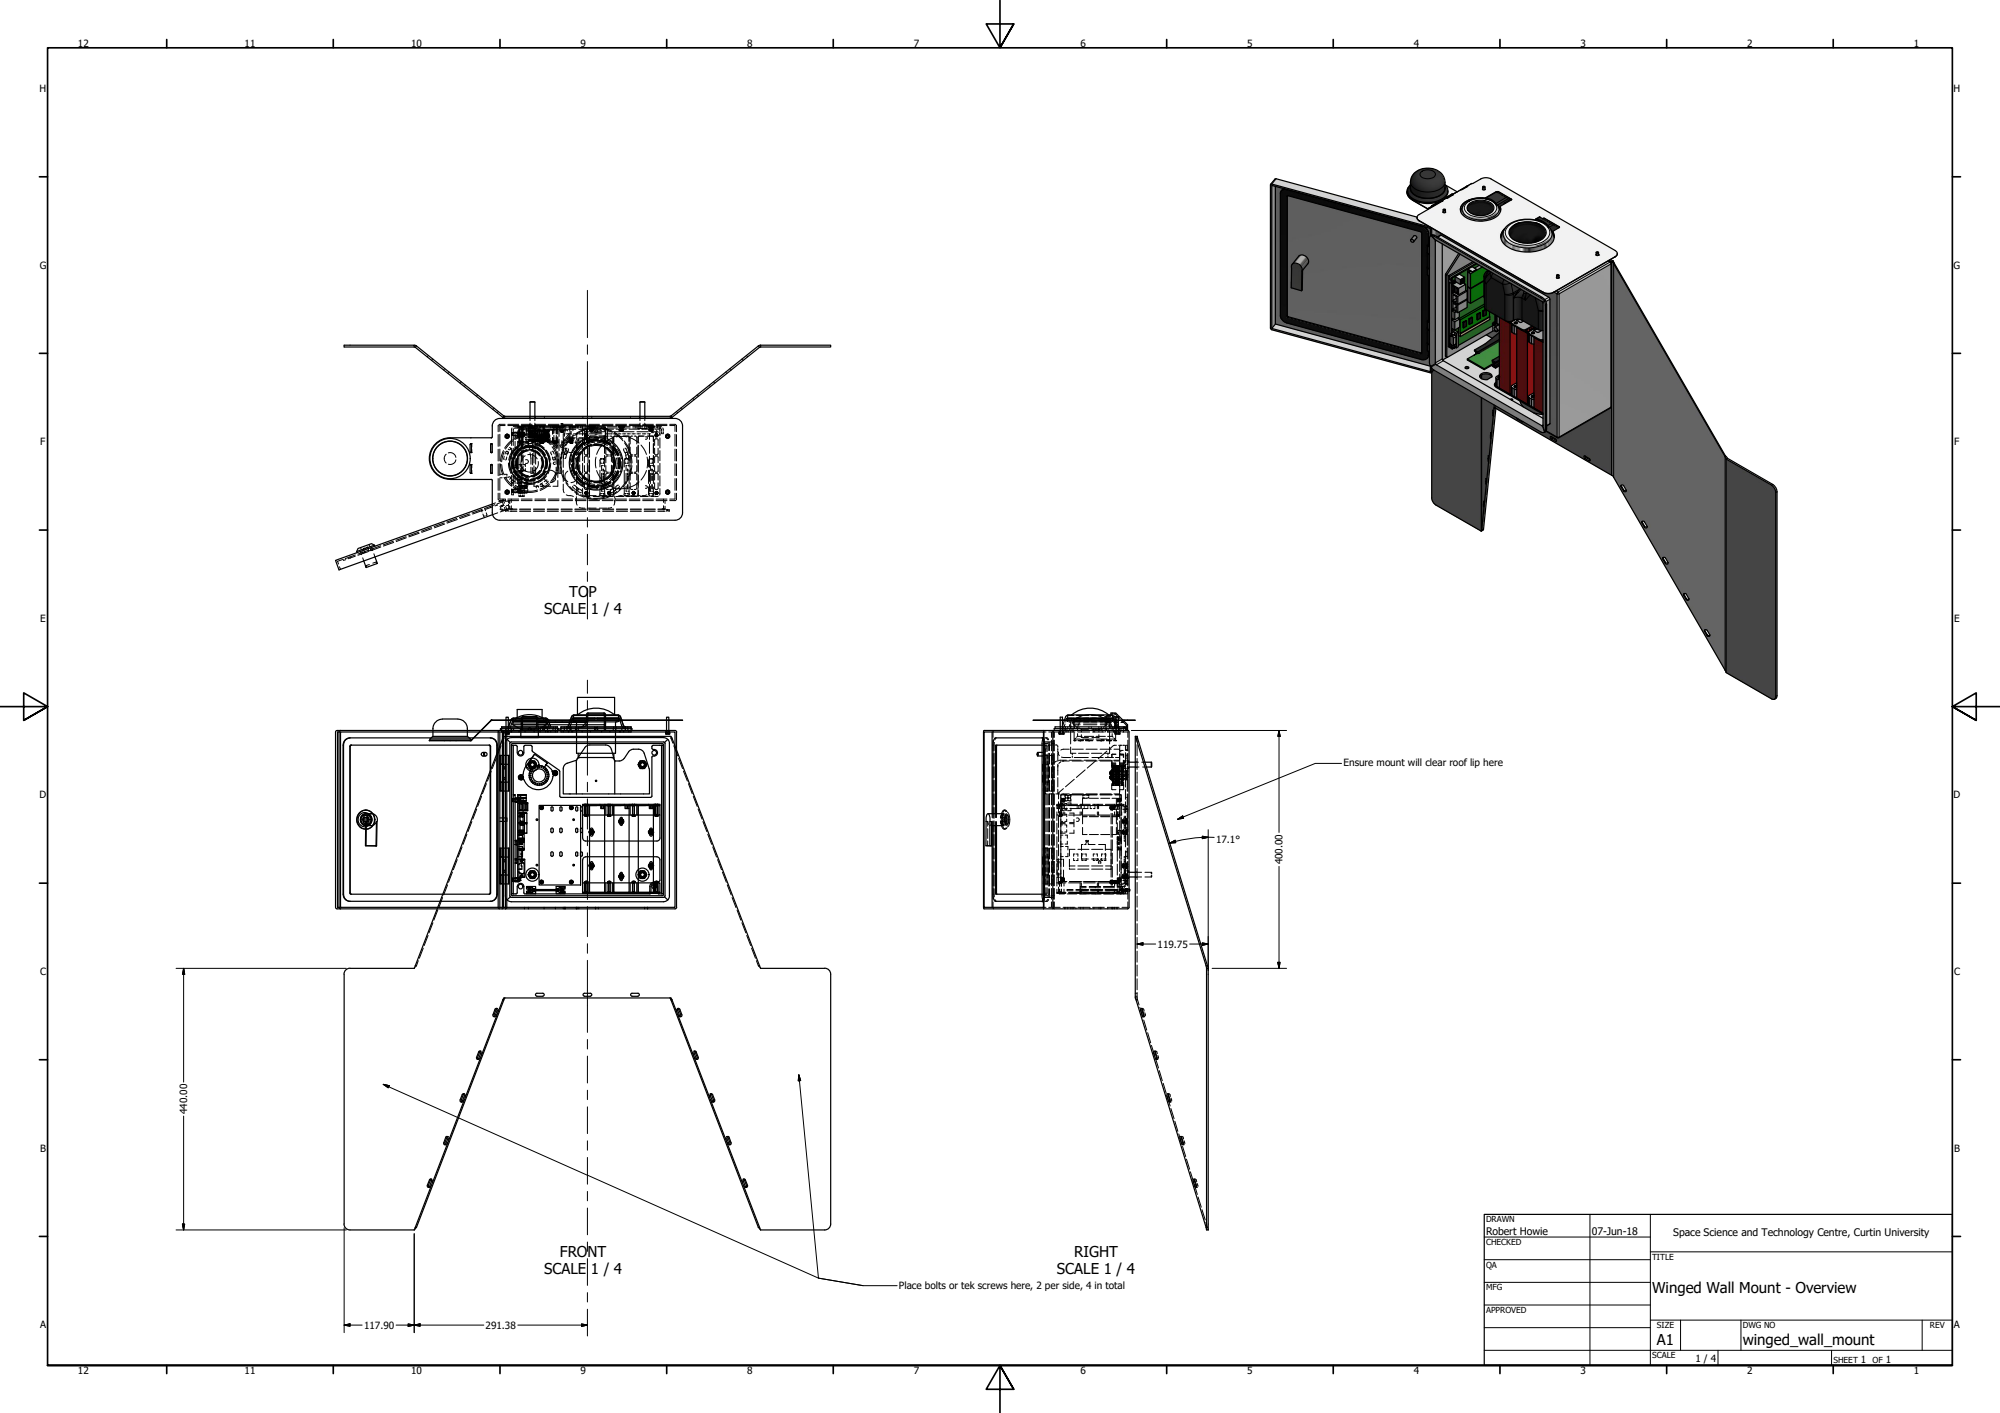
[picture p308: page 1]
SCALE 1 / 4; SHEET 1 OF 1; Robert Howie; 07-Jun-18; DWG NO

Ensure mount will clear roof lip here

Space Science and Technology Centre, Curtin University

TITLE
Winged Wall Mount - Overview

Place bolts or tek screws here, 2 per side, 4 in total
