desertfireballnetwork/observatories_technical_wiki/(commit log)

2026-04-02 added all missing media
    [20170330_Sunshield_2mm_Al.dxf, 20191218_large_dfnext_sunshield_2mm_aluminum.dxf, Dfnkit_sunshield.dxf, Enclosure_right_panel.dxf, Enclosure_roof_panel.dxf, Flat_roof_mount.ipt, PART_10_degree_roof_mount_MAT_3mm_aluminium.dxf, PART_15_degree_roof_mount_MAT_3mm_aluminium.dxf]
2026-04-08 fixing images file name case issues
