desertfireballnetwork/observatories_technical_wiki/images/20190724_212620.jpg

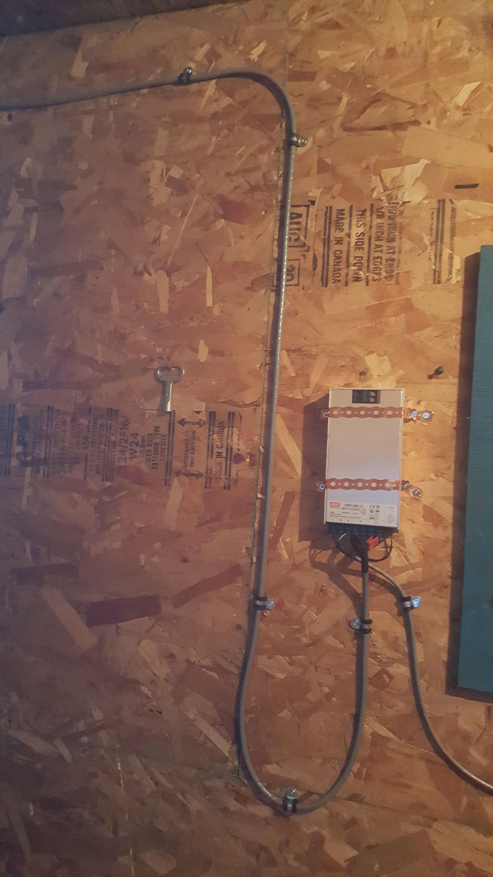
images/20190724_212620.jpg
