desertfireballnetwork/observatories_technical_wiki/images/Flat_roof_frame.jpg

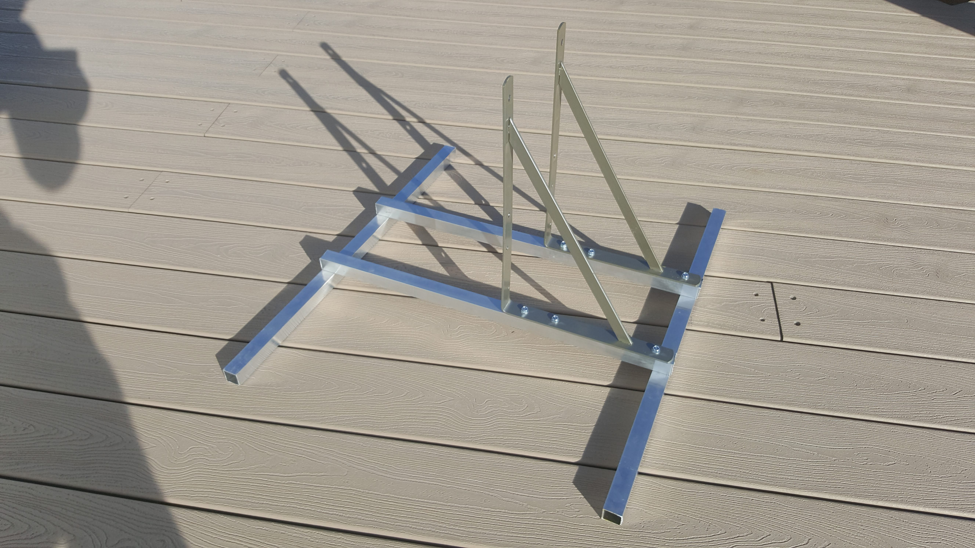
[picture p276: images/Flat_roof_frame.jpg]
images/Flat_roof_frame.jpg
